IliyanAntov/CodeFreeBLDC/README.md

 <h1 align="center"> Осъвременяване на управлението на вакуумна помпа <br/><br/>
 Code-free BLDC pump motor driver
 </h1>

## [Документация](./Documentation/DR_Iliyan_Antov_101324019.pdf)

## [Презентация на проекта](./Documentation/Presentation/BLDC%20motor%20driver.pptx)

## Блокова схема:
<p align="center">
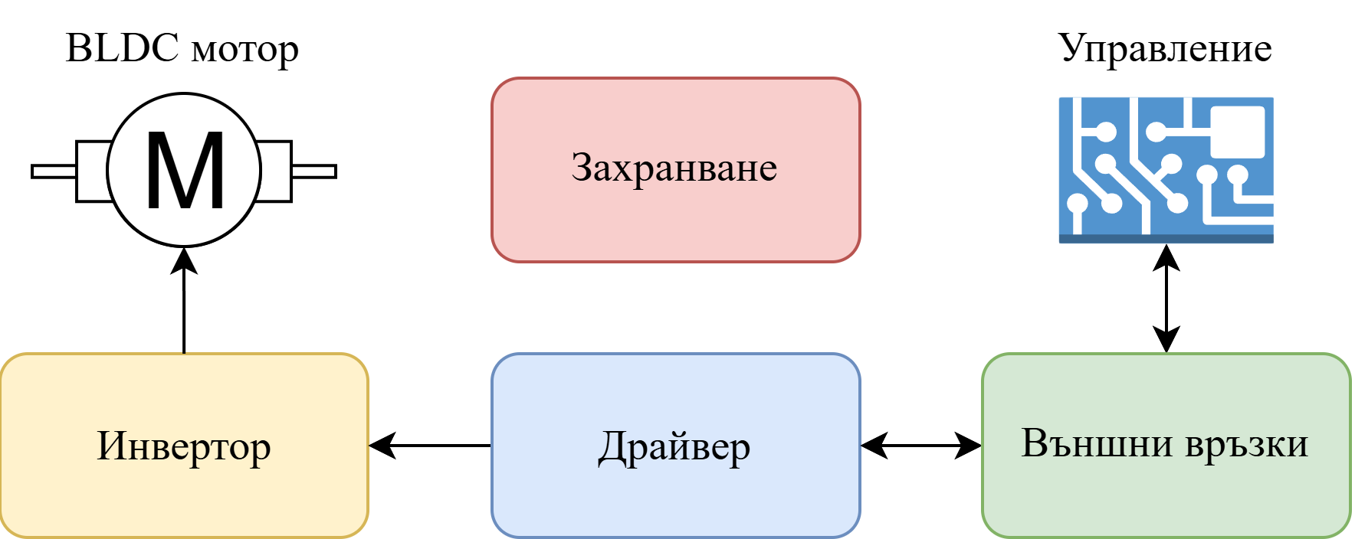
[picture p1: Documentation/Images/Block schemes/BLDC_driver.png]
  
</p>

## Принципна електрическа схема:
<p align="center" float="left">
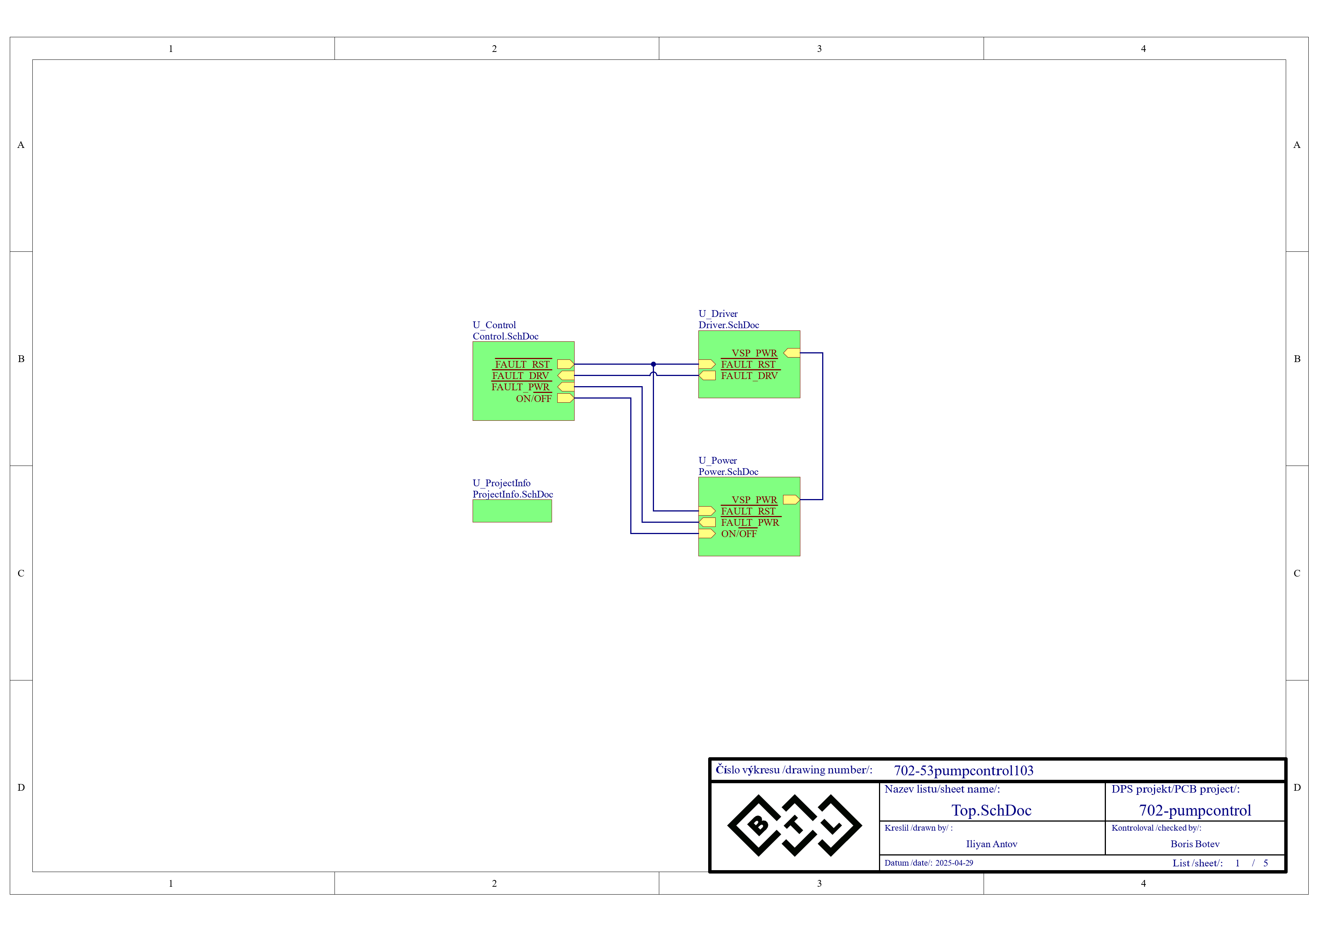
[picture p2: Design/Schematic/1_Top.png]
  
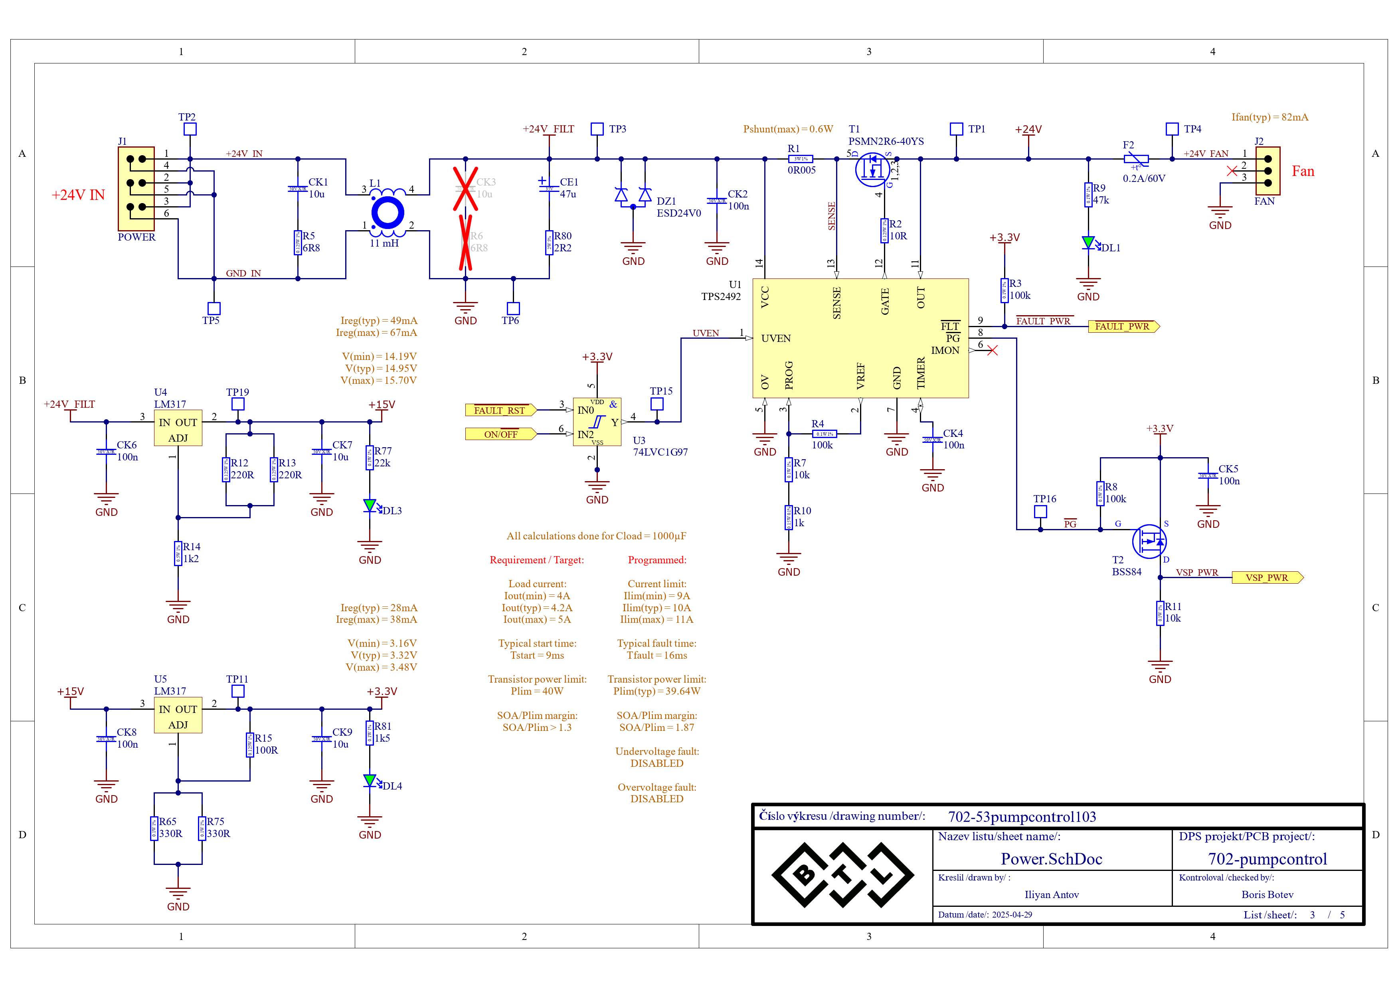
[picture p3: Design/Schematic/3_Power.png]
  
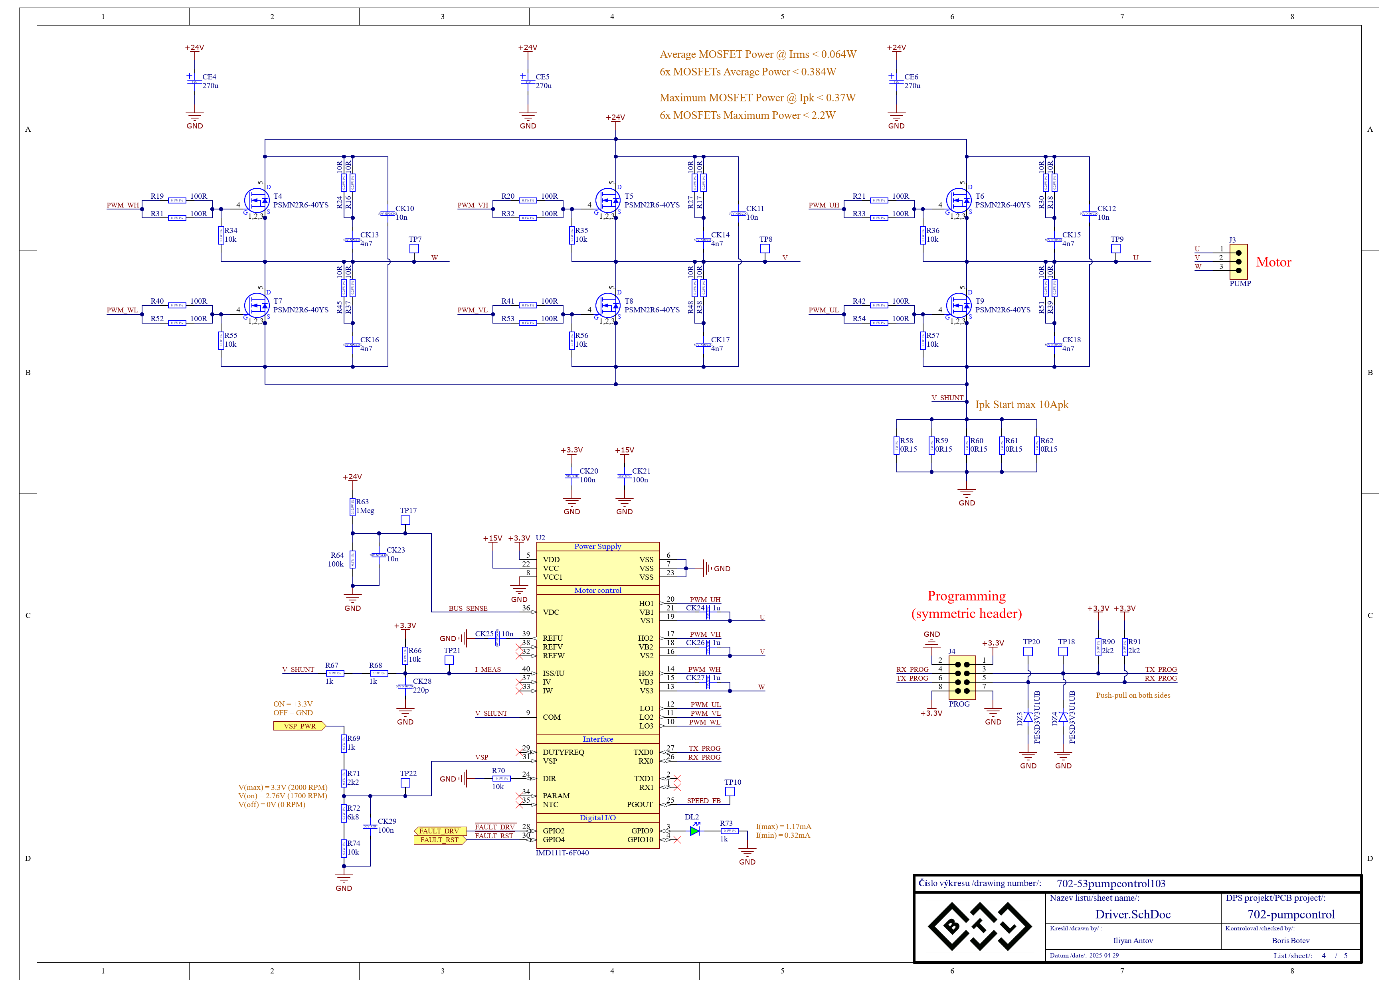
[picture p4: Design/Schematic/4_Driver.png]
  
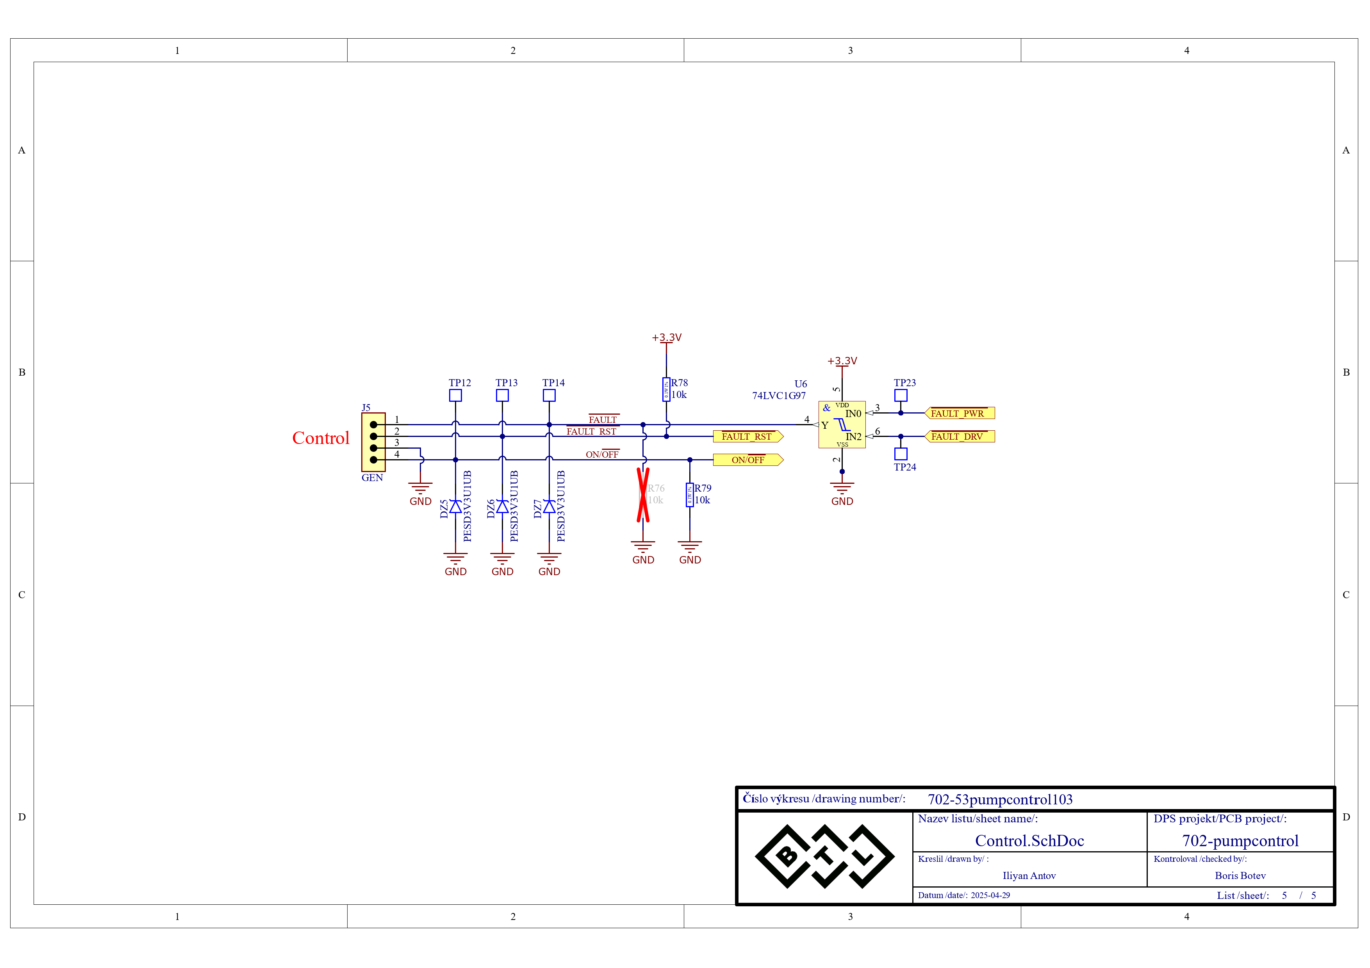
[picture p5: Design/Schematic/5_Control.png]
  
</p>

## Печатна платка:
<p align="center">
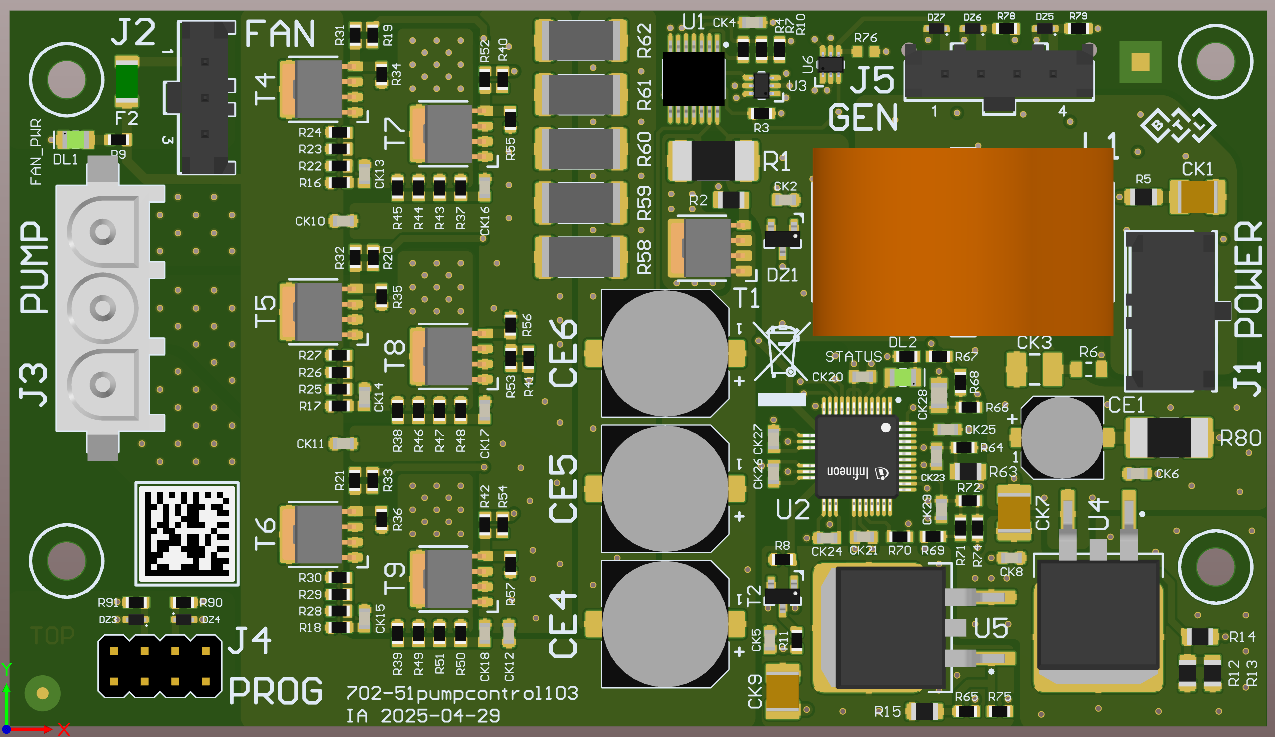
[picture p6: Documentation/Images/PCB/3D_TOP.png]
  
</p>

## Реализация:
<ul>
  <li><a href="./Design/Testing/702-pumpcontrol102_Test_Report.pdf"> Test report </a></li>
  <li><a href="./Documentation/Images/Measurements/EMC/VER_therapy%20-%20pumpcontrol103.pdf"> EMC report </a></li>
</ul>

## Използвани технологии:
* Schematics/Layout: Altium
* Simulations: LTSpice
* BLDC driver platform: Infineon iMOTION

## Автор:
Илиян Антов - [Iliyan Antov](https://github.com/IliyanAntov) - [i.antov2@gmail.com](i.antov2@gmail.com)
