IliyanAntov/CodeFreeBLDC/Design/Design report.docx

# 702-pumpcontrol102 Design Report

References:

- IMD111T datasheet (https://www.infineon.com/dgdl/Infineon-IMD110T-DataSheet-v01_01-EN.pdf?fileId=5546d462773f93240177489a1dcf0a7d)
- iMOTION Software Reference Manual (https://www.infineon.com/dgdl/Infineon-MCESW-RM-UserManual-v01_34-EN.pdf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)
- EVAL-M7-D111T user guide (https://www.infineon.com/dgdl/Infineon-UG-2021-17_EVAL-M7-D111T-UserManual-v01_00-EN.pdf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)
  - Schematics (https://www.infineon.com/dgdl/Infineon-Schematics-EVAL-M7-D111T-PCBDesignData-v01_00-EN.pdf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)
- EVAL-M7-LVMOS-INV user guide (https://www.infineon.com/dgdl/Infineon-UG-2021-30_EVAL-M7-LVMOS-INV-UserManual-v01_01-EN.pdf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)
  - Schematics (https://www.infineon.com/dgdl/Infineon-Schematics-EVAL-M7-LVMOS-INV-PCBDesignData-v01_00-EN.pdf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)
- REF_Fridge_D111T_RC2_SL user guide (https://www.infineon.com/dgdl/Infineon-UG-2021-31_REF_Fridge_D111T_RC2_SL_V1.1_EN-UserManual-v01_01-EN.pdf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)
  - Schematics (https://www.infineon.com/dgdl/Infineon-Schematics-REF_FRIDGE_D111T_RC2_SL-PCBDesignData-v01_01-EN.pdf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)
- iMOTION Link User Manual (https://www.infineon.com/dgdl/Infineon-iMOTION_Link-UserManual-v01_01-EN.pdf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)
- MOSFET Gate Drive Circuit application note (https://toshiba.semicon-storage.com/info/application_note_en_20180726_AKX00068.pdf?did=59460)
- Accurate Thermal Calculations on the Back of a Napkin (https://www.ti.com/lit/an/slpa015/slpa015.pdf)

# 1. Shunt resistors

I_(pk) =10A, P_(res(max)) =1W

R_(tot) =0.15/5=0.03Ω=30mΩ

P_(tot(max)) =R_(tot) *I_(pk)^2 =30m*10^2 =3W

P_(res(pk)) =(P_(tot))/5=0.6W

P_(tot(RMS)) =R_(tot) *I_(RMS)^2 =30m*4.2^2 =0.5W

P_(res(RMS)) =0.5/5=0.1W

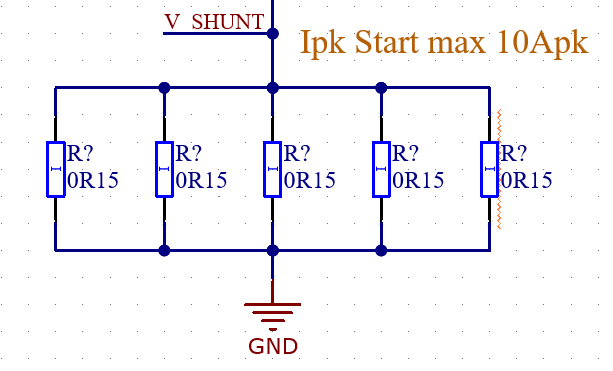
[picture p7: figure]

# 2. Bus sense

V_(ADC(max)) =3.3V

V_(DC(max)) =(100k+1000k)/(100k)*3.3V=36.3V

τ_(RC) =1Meg*10n=10μs

f_c =1/(2πRC)=1/(2π*1Meg*10n)=16Hz

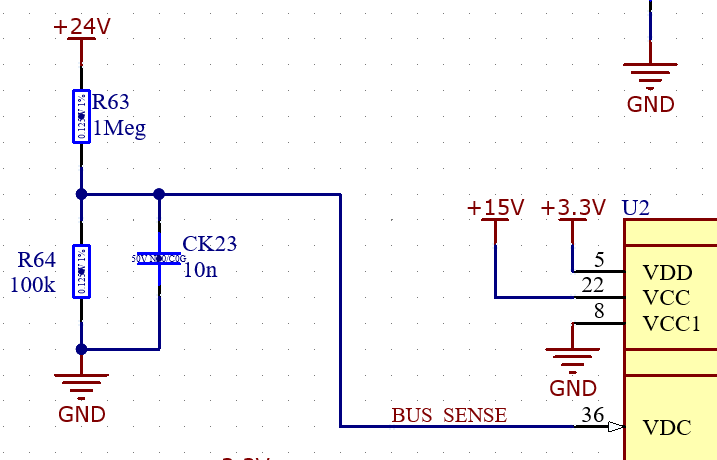
[picture p8: figure]

# 3. Current measurement

G_(int) =3, R_(shunt) =30mΩ

V_(offset) =(2k)/(2k+10k)*3.3V=0.55V=550mV

V_(shunt(min)) =-V_(offset) =-550mV

V_(shunt(max)) =(V_(ADC))/(G_(int))-V_(offset) =3.3/3-0.55=550mV

G_(ext) =(10k)/(2k+10k)=0.833

Current gain=G_(ext) *R_(shunt) =0.833*30mΩ=25mV/A

I_((min)) =(V_(shunt(min)))/(Current gain)=(-550mV)/25=-22A

I_((max)) =(V_(shunt(max)))/(Current gain)=(550mV)/25=22A

P_(res(max)) =(U^2)/R=5.45mW

τ_(RC) =2k*220p=440ns=0.44μs

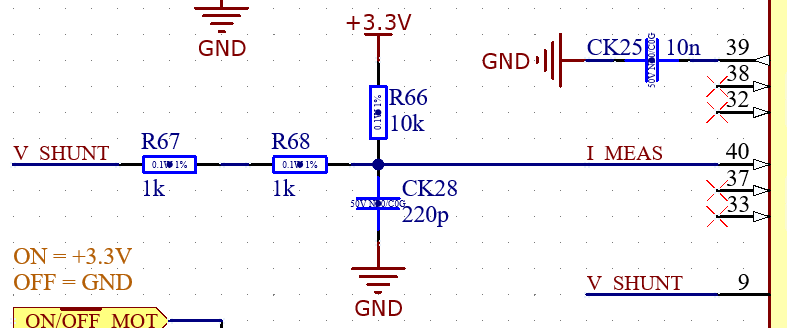
[picture p9: figure]
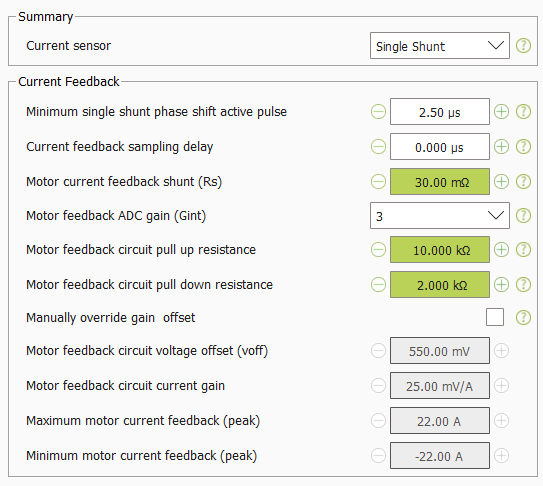
[picture p10: figure]
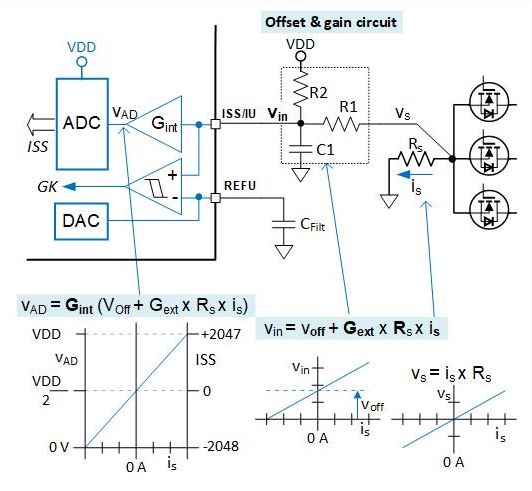
[picture p11: figure]

# 4. Parameter selection

Multiple parameter sets not used, so PARAM pin can be left floating. Parameter set chosen during firmware flash.

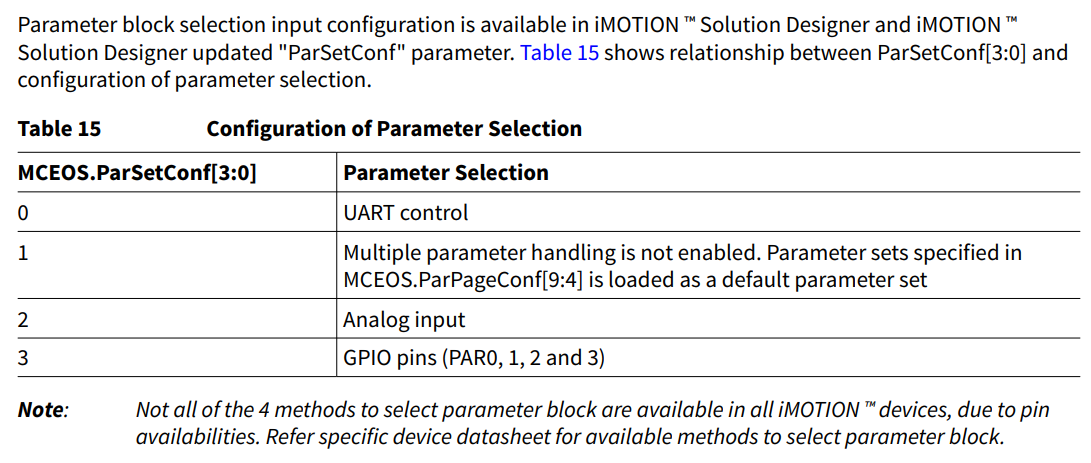
[picture p12: figure]

# 5. Motor direction

DIR pin should be LOW so motor direction is positive.

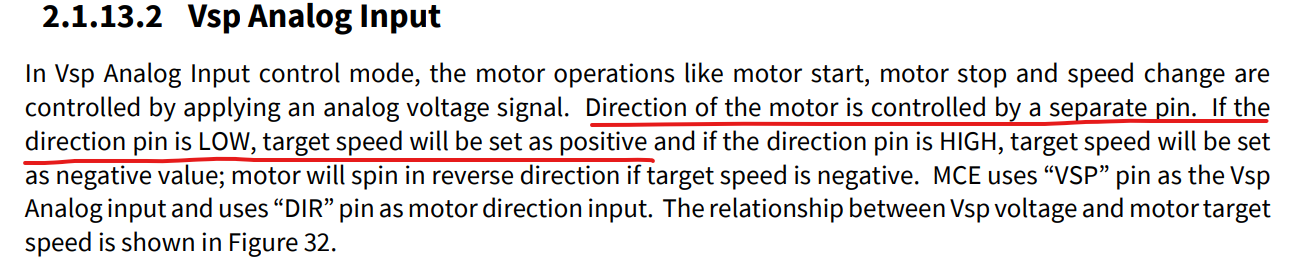
[picture p13: figure]
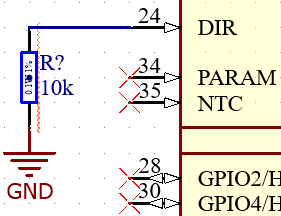
[picture p14: figure]

# 6. Motor speed

S_(typ) =1700 RPM, S_(min) =200 RPM, S_(max) =2000 RPM

V_(target) =((S_(typ) -S_(min) ))/((S_(max) -S_(min) ))*(V_(max) -V_(min) )+V_(min)

V_(target) =((1700-200))/((2000-200))*(3.16-0.79)+0.79=2.77V

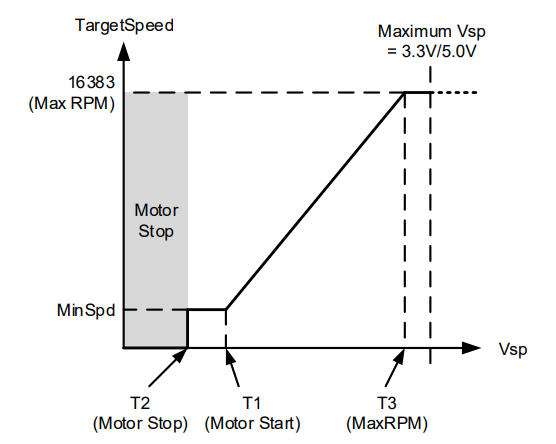
[picture p15: figure]
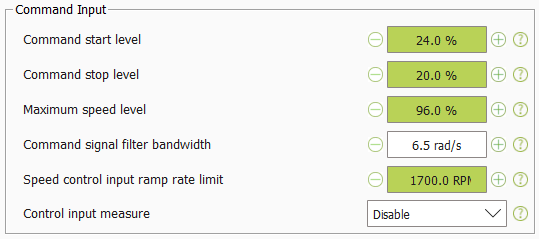
[picture p16: figure]

R_(ds(on)) ≤2Ω

VSP=(10k+6.8k)/(10k+6.8k+2.2k+1k+R_(ds(on)))*3.3V≈2.77V

I_(div) =(3.3V)/(1k+2.2k+6.8k+10k+R_(ds(on)))=165μA

τ_(RC) =(1k+2.2k)*100n=320μs

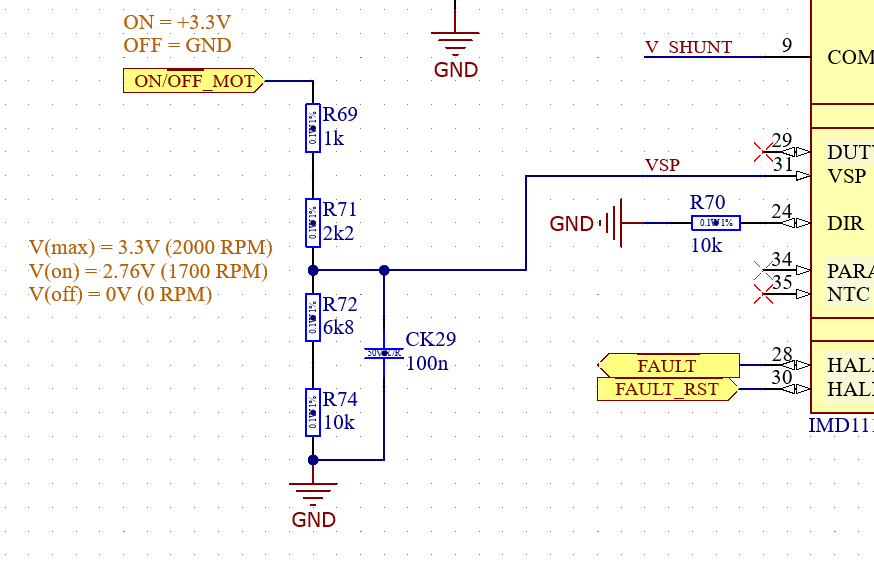
[picture p17: figure]
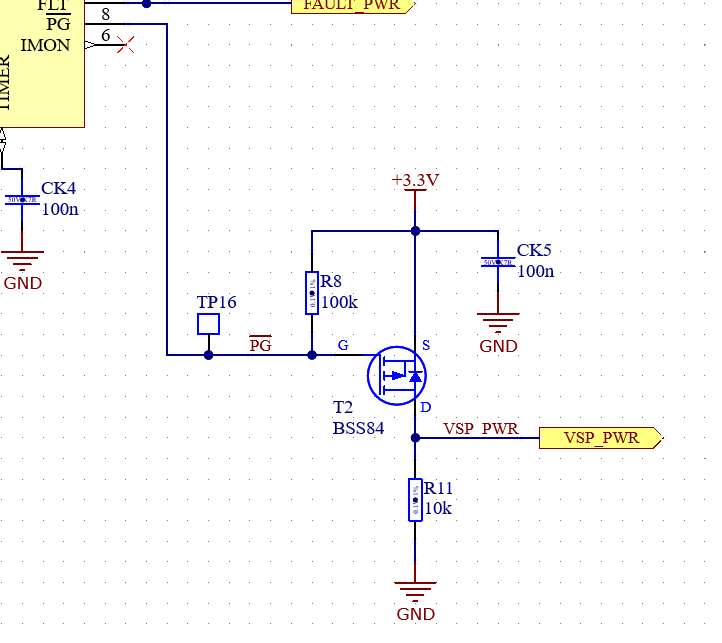
[picture p18: figure]
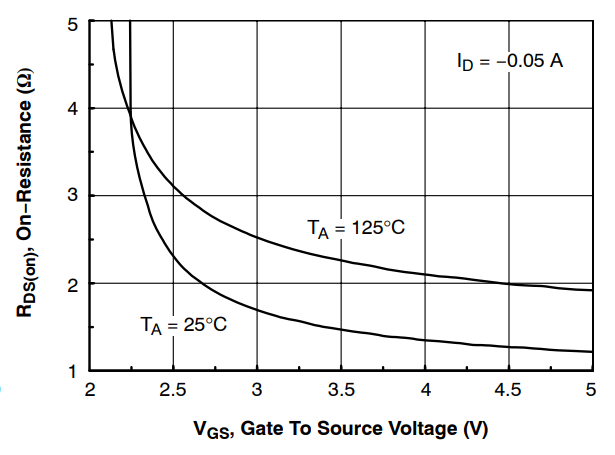
[picture p19: figure]

# 7. +15V and +3.3V power supplies

Q_(g(max)) =63nC, f_(sw(max)) =40kHz, N=6 transistors

I_(G(max)) =Q_(g(max)) *f_(sw(max)) =63n*40k=2.52mA

I_(CC(max)) =N*I_(g(max)) =6*2.52m=15.12mA

I_(QCC(nom)) =0.75mA

I_(+15V(nom)) =I_(QCC(nom)) +I_(CC(nom))

I_(+15V(nom)) ≈10mA

I_(QCC(max)) =1.5mA

I_(+15V(max)) =I_(QCC(max)) +I_(CC(max)) =1.5m+15.12m

I_(+15V(max)) =16.62mA

I_(DD(nom)) =12mA

I_(+3.3V(nom)) =15mA

I_(DD(max)) =20mA

I_(+3.3V(max)) =25mA

IC (IMD111T):

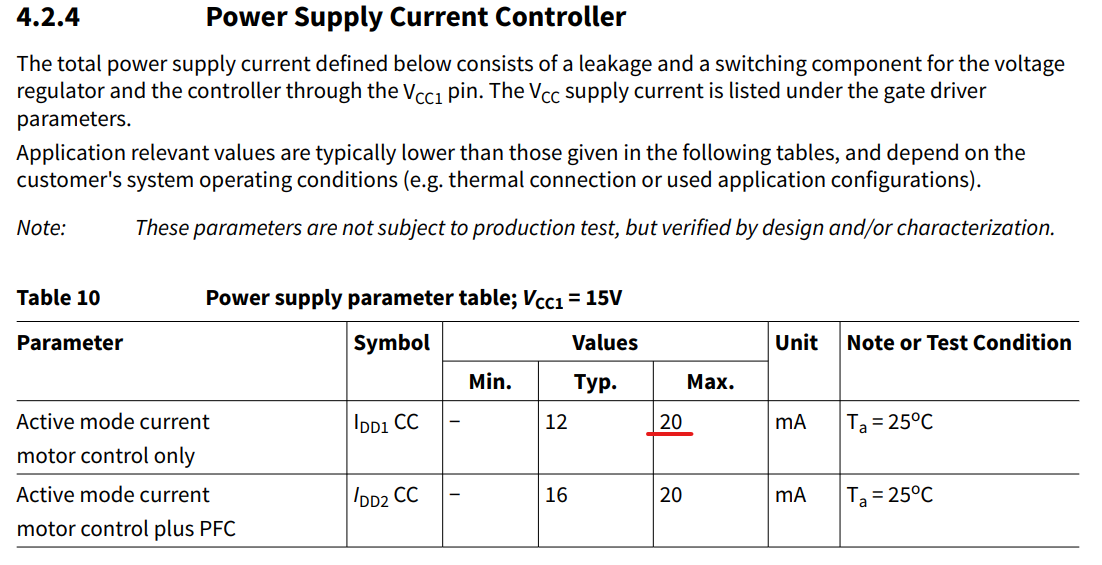
[picture p20: figure]

Transistors (PSMN2R6-40YS):

Regulator:

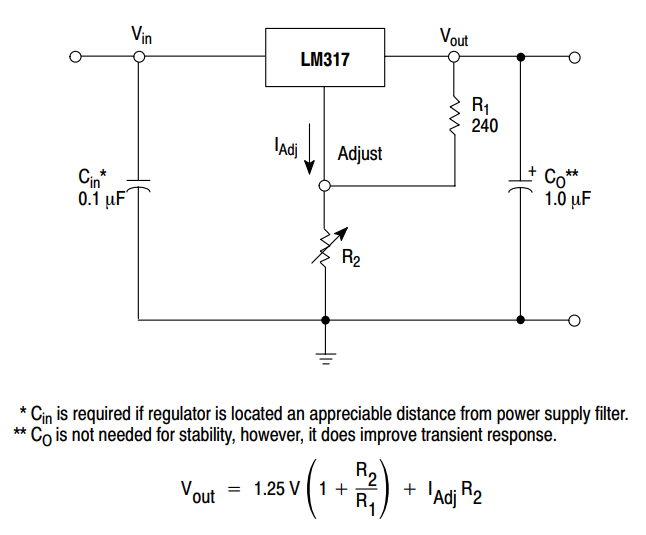
[picture p21: figure]

# 8. Overall power loss and self-heating

T_(amb) =40°C

- +15V regulator (LM317):

P_(+15V_reg(nom)) =0.44W

T_(+15V_reg(nom)) =62.12°C

- +3.3V regulator (LM317):

P_(+3.3V_reg(nom)) =0.32W

T_(+3.3V_reg(nom)) =55.99°C

- Shunt resistors (5x):

P_(R(nom)) =0.104W

T_(R(nom)(polygon)) =48.41°C

- Inverter transistors (6x):

P_(T_(inv) (nom)) =0.035W

T_(T_(inv) (nom)(polygon)) =42.82°C

- +24V power transistor:

P_(T_(+24V) (nom)) =0.035W

T_(T_(+24V) (nom)(polygon)) =43.16°C

- +24V power shunt resistor:

P_(R_(+24V) (nom)) =0.087W

T_(T_(+24V) (nom)(polygon)) =52.75°C

P_(tot(nom)) =P_(+15V_reg(nom)) +P_(+3.3V_reg(nom)) +5P_(R(nom)) +6P_(T_(inv) (nom)) +P_(T_(+24V) (nom)) +P_(R_(+24V) (nom))

P_(tot(nom)) =0.44+0.32+5*0.104+6*0.035+0.035+0.087

P_(tot(nom)) =1.614 W

# 9. Phase output snubber calibration

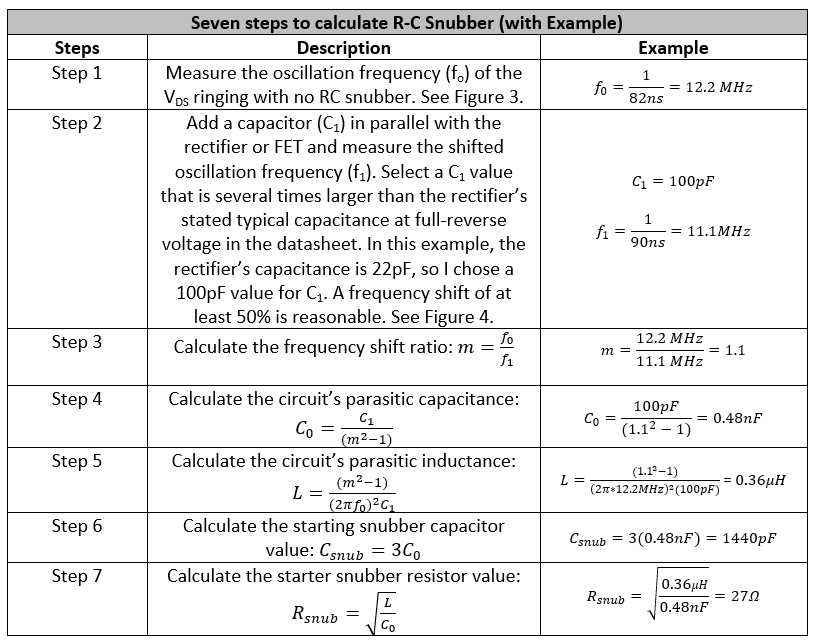
[picture p22: figure]

U phase:

Top:

f_0 =22.8 MHz

Choose C_1 =2.2 nF

f_1 =12.5 MHz

m=(f_0)/(f_1)=1.824

C_0 =(C_1)/((m^2 -1))=0.945 nF

L=((m^2 -1))/((2πf_0 )^2 C_1)=51.54 nH

C_(snub) =3C_0 =2.835 nF

Choose C_(snub) =4.7 nF

R_(snub) =√(L/(C_0))=7.385 Ω

Choose R_(snub) =5 Ω

Bot:

f_0 =24 MHz

Choose C_1 =2.2 nF

f_1 =11.5 MHz

m=(f_0)/(f_1)=2.087

C_0 =(C_1)/((m^2 -1))=0.656 nF

L=((m^2 -1))/((2πf_0 )^2 C_1)=67.08 nH

C_(snub) =3C_0 =1.968 nF

Choose C_(snub) =4.7 nF

R_(snub) =√(L/(C_0))=10.11 Ω

Choose R_(snub) =5 Ω

V phase:

Top:

f_0 =22.5 MHz

Choose C_1 =2.2 nF

f_1 =11.5 MHz

m=(f_0)/(f_1)=1.957

C_0 =(C_1)/((m^2 -1))=0.777 nF

L=((m^2 -1))/((2πf_0 )^2 C_1)=64.36 nH

C_(snub) =3C_0 =2.331 nF

Choose C_(snub) =4.7 nF

R_(snub) =√(L/(C_0))=9.101 Ω

Choose R_(snub) =5 Ω

Bot:

f_0 =23.8 MHz

Choose C_1 =2.2nF

f_1 =11.6 MHz

m=(f_0)/(f_1)=2.052

C_0 =(C_1)/((m^2 -1))=0.685 nF

L=((m^2 -1))/((2πf_0 )^2 C_1)=65.26 nH

C_(snub) =3C_0 =2.055

Choose C_(snub) =4.7 nF

R_(snub) =√(L/(C_0))=9.761 Ω

Choose R_(snub) =5 Ω

W phase:

Top:

f_0 =24 MHz

Choose C_1 =2.2 nF

f_1 =11.7 MHz

m=(f_0)/(f_1)=2.051

C_0 =(C_1)/((m^2 -1))=0.686 nF

L=((m^2 -1))/((2πf_0 )^2 C_1)=64.10 nH

C_(snub) =3C_0 =2.058 nF

Choose C_(snub) =4.7 nF

R_(snub) =√(L/(C_0))=9.666 Ω

Choose R_(snub) =5 Ω

Bot:

f_0 =24.2 MHz

Choose C_1 =2.2 nF

f_1 =11.8 MHz

m=(f_0)/(f_1)=2.051

C_0 =(C_1)/((m^2 -1))=0.686 nF

L=((m^2 -1))/((2πf_0 )^2 C_1)=63.04 nH

C_(snub) =3C_0 =2.058 nF

Choose C_(snub) =4.7 nF

R_(snub) =√(L/(C_0))=9.586 Ω

Choose R_(snub) =5 Ω
