IliyanAntov/CodeFreeBLDC/Design/TPS2492_calculations.xlsx

Sheet: Instructions
 | © 2016
TPS249x/8x Design Tool- Rev. B
Typical design procedure
Typical applications require multiple passes through the design tool using MOSFET factors such as transient
thermal response and safe operating area curves. Refer to the following application reports for more detail.
Robust Hot Swap Design (http://www.ti.com/lit/pdf/slva673)
The basic design process follows:
1. Enter operating conditions.
2. Select current limit parameters.
3. Enter MOSTFET SOA characteristics & power limit.
4. Select start up conditions (load and/or soft start). Check whether FET is operating with reasonable margin, within the SOA curve.
If not, try changing start-up conditions (soft start values, timer values), add more FETs in parallel, or switch to FET with better SOA.
5. Enter desired UVLO and OVLO values to get recommended resistor values.
6. Done
Notes
1. This worksheet is designed for use with Microsoft Excel 5.0 or later. Its use is intended to assist power supply designers in their
routine, day-to-day calculations.
2. All worksheets have light green inputs cells, white calculated cells, yellow warning cells and red high-risk cells.
3. Formulas and device constants used in the spreadsheet are locked to prohibit them from accidentally being overwritten or deleted.
TEXAS INSTRUMENTS TEXT FILE LICENSE Copyright (c) 2014 Texas Instruments Incorporated All rights reserved not granted herein. Limited License. Texas Instruments Incorporated grants a world-wide, royalty-free, non-exclusive license under copyrights and patents it now or hereafter owns or controls to make, have made, use, import, offer to sell and sell ("Utilize") this software subject to the terms herein. With respect to the foregoing patent license, such license is granted solely to the extent that any such patent is necessary to Utilize the software alone. The patent license shall not apply to any combinations which include this software, other than combinations with devices manufactured by or for TI (“TI Devices”). No hardware patent is licensed hereunder. Redistributions must preserve existing copyright notices and reproduce this license (including the above copyright notice and the disclaimer and (if applicable) source code license limitations below) in the documentation and/or other materials provided with the distribution Redistribution and use in binary form, without modification, are permitted provided that the following conditions are met: * No reverse engineering, decompilation, or disassembly of this software is permitted with respect to any software provided in binary form. * any redistribution and use are licensed by TI for use only with TI Devices. * Nothing shall obligate TI to provide you with source code for the software licensed and provided to you in obje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

Sheet: Design Calculator
TPS2490/1/2/3 & TPS2480/1/2/3 Hot Swap Design Tool
 | www.ti.com/hotswap
 |  |  | Enter Values in Green Shaded Cells
 |  |  | Calculated Values are shown in White Cells
 |  |  | Yellow and Red cells highlight pottential issues with the design. Red highlights items that are higher risk.
 | Step 0: Calculator Tutorials |  | Note: Before proceeding, please watch the video tutorials listed to ensure accurate results from this tool!
 |  |  | Steps 1 & 2: Operating Conditions, Current Limit, & Circuit Breaker (7:41) (https://training.ti.com/node/1133677)
 |  |  | Step 3: MOSFET Selection (9:58) (https://training.ti.com/node/1133673)
 |  |  | Step 4: Startup (10:32) (https://training.ti.com/node/1133664)
 |  |  | Step 5: UVLO, OVLO & PGD Thresholds (4:20) (https://training.ti.com/node/1133681)
 |  |  | TPS2490 Datasheet (http://www.ti.com/product/TPS2490)
 |  |  | I understand and agree to watch the video tutorials if help is needed. (Choose Yes to enable the calculator.) |  |  | Yes
 |  |  | Assure to follow the layout and application guidelines listed on the datasheet. |  |  | Yes
 |  |  | *For additional questions not addressed in the videos, please post on E2E.ti.com
 | Step 1: Operating Conditions |  |  | Minimum Input Operating Voltage: VIN(MIN) | 22 | V
 |  |  |  | Nominal Input Operating Voltage: VIN(NOM) | 24 | V
 |  |  |  | Maximum Input Operating Voltage: VIN(MAX) | 26 | V
 |  |  |  | Maximum Load Current: IOUT(MAX) | 5 | A
 |  |  |  | Maximum Output Load Capacitance: CLOAD | 1000 | µF
 |  |  |  | Maximum Ambient Operating Temperature: TMAX | 65 | oC
 | Steps 1 & 2: Operating Conditions, Current Limit, & Circuit Breaker (https://training.ti.com/node/1133677)
 | Step 2: Current Limit and Circuit Breaker |  |  | Maximum Recommended Value for Rs | 8.91 | mW
 |  |  |  | Use External Resistor Divider to Reduce Effecitve RS | No
 |  |  |  | Enter the Resistance for RS | 5 | mW
 |  |  |  | Recommended Value for RCL1 | NA | W
 |  |  |  | Recommended Value for RCL2 | NA | W
 |  |  |  | Enter value for RCL1 | 10 | W
 |  |  |  | Enter value for RCL2 | 2 | W
 | Steps 1 & 2: Operating Conditions, Current Limit, & Circuit Breaker (https://training.ti.com/node/1133677) |  |  | Effective Sense Resistance (RS,EFF) | 5.00 | mW
 |  |  |  | Resulting Minimum Current Limit | 9.0 | A
 |  |  |  | Resulting Typical Current Limit | 10.0 | A
 |  |  |  | Resulting Maximum Current Limit | 11.0 | A
 |  |  |  | Maximum Power Dissipation in RS | 0.6 | W
 | Step 3: MOSFET Selection |  |  | Q1 FET Name | ET+PSMN2R6XX0
 |  |  |  | Estimated MOSFET RQJA | 30 | oC/W
 |  |  |  | Number of MosFETs | 1 | #
 |  |  |  | MOSFET On resistance @ TJ,DC | 3.7 | mW
 |  |  |  | Maximum FET Junction Temperature | 150 | oC
 |  |  |  | 100ms SOA Current (re-use 1ms data if unavailable) @ VIN(MAX) | 90.0 | A
 |  |  |  | 1ms SOA Current @ VIN(MAX) | 10.0 | A
 | Step 3: MOSFET Selection (https://training.ti.com/node/1133673) |  |  | 10ms SOA Current @ VIN(MAX) | 5.0 | A
 |  |  |  | 100ms Current at @ VIN(MAX) (use DC if 100ms not available) | 2.5 | A
 |  |  |  | 1s or DC SOA Current at @ VIN(MAX) (use DC if 1s not available) | 1.5 | A
 |  |  |  | FET Power dissapation at full load (per FET) | 0.092 | W
 | Note: TI recommends choosing a FET with SOA current specified for 100ms and/or 1s or DC. If choosing a FET without these parameters, this calculator will estimate the values via extrapolation, which leaves an inherent associated risk. |  |  | Maximum steady state FET Junction Temperature (TJ,DC) | 67.8 | oC
 |  |  |  | Minimum Power Limit to Ensure Vsns > 5mV & Vprog > 0.4V (PLIM,MIN) | 40.0 | W
 |  |  |  | Target Power Limit | 40.0 | W
 |  |  |  | Select R3 | 100.0 | kW
 |  |  |  | Calculated R4 | 11.11 | kW
 |  |  |  | Actual R4 (Select next available std. value) | 11 | kW | Note: Hover here to see the 3 values affecting this curve, consult a thermal expert if you are unsure!
 |  |  |  | Actual PLIM | 39.64 | W
 | Step 4: Startup |  |  | Load Turn-On Threshold | 0 | V
 |  |  |  | Startup Load Type | Constant Current
 |  |  |  | Startup Load Value | 0.1 | A
 |  |  |  | Use External Soft-Start Control | No
 |  |  |  | Typical Start Time with Vinmax (Tstart) | 9.04 | ms
 |  |  |  | IFET - ILOAD margin (lowest for Vout range) | 93.44090909%
 |  |  |  | Target Fault Timer: Tstart + Margin | 15.83 | ms
 |  |  |  | Target Timer capacitance | 98.93 | nF
 |  |  |  | Selected Timer capacitance | 100 | nF
 | Step 4: Startup (https://training.ti.com/node/1133664) |  |  | Final Fault Timer(Tfault) | 16.00 | ms
 |  |  |  | Derated SOA / PLIM | 1.87
 |  |  |  | Can a "hot" board be hotplugged | No
 |  |  |  | Recommended slew Rate (max) | 0.53 | V/ms
 |  |  |  | Recommended slew Rate (min) | 0.10 | V/ms
 | Note: This is the typical dv/dt rate, but max value can be larger. This is because the gate source current can vary from 16uA to 28uA. Thus TI recommends keeping the overall SOA margin during start-up >1.5 in order to compensate for this. |  |  | dv/dt rate on Vout | 1 | V/ms
 |  |  |  | calculated SS capacitance | 22.00 | nF
 |  |  |  | actual SS capacitance | 22 | nF
 |  |  |  | actual dv/dt rate on Vout | 1.00 | V/ms
 |  |  |  | SOA margin during start-up | 2.32
 |  |  |  | Target Fault Time | 1 | ms
 |  |  |  | Calculated Timer Capacitance | 6.25 | nF
 |  |  |  | Actual Timer Capacitance (pick one smaller than CT,CALC) | 10 | nF
 |  |  |  | Actual Fault Time (Tfault) | 1.60 | ms
 |  |  |  | SOA margin during "hot-short" or "start-into short" | 1.87
 | Step 5: UVLO, OVLO & PGD Thresholds |  |  | Target Under - Voltage | 20 | V
 |  |  |  | Recommended R2 | 10.00 | kW
 |  |  |  | Actual R2 |  | kW
 |  |  |  | Calculated R1 | 0.00 | kW
 |  |  |  | Actual R1 |  | kW
 |  | Resulting Thresholds: | Minimum | Typical | Maximum
 | Step 5: UVLO, OVLO & PGD Thresholds (https://training.ti.com/node/1133681) | Resulting Upper UVLO Threshold = | #DIV/0! | #DIV/0! | #DIV/0! | V
 |  | Resulting Lower UVLO Threshold = | #DIV/0! | #DIV/0! | #DIV/0! | V
 | Design Summary |  |  | RS = | 5 | mW
 |  |  |  | RCL1 = | DNP | W
 |  |  |  | RCL2 = | short | W
 |  |  |  | R1 = | 0 | kW |  |  | Typical | Units
 |  |  |  | R2 = | 0 | kW |  | Current limit | 10.0 | A
 |  |  |  | R3 = | 100.0 | kW |  | Power Limit | 39.63963964 | W
 |  |  |  | R4 = | 11 | kW |  | Fault Timeout | 16.000 | ms
 |  |  |  | CT = | 100.00 | nF |  | Upper UVLO Threshold | #DIV/0! | V
 |  |  |  | C1 = | 0.10 | µF |  | Lower UVLO Threshold | #DIV/0! | V
 |  |  |  | Q1 = | ET+PSMN2R6XX0
 |  |  |  | RG = | DNP | kW
 |  |  |  | CG = | DNP | nF
 | Notes: | 1. Although not mandatory, CIN provides transient suppression at the VIN pin
 |  | 2. A TVS clamp from VIN to GND is absolutely mandatory to clamp the voltage overshoot upon MOSFET turn-off, e.g. during circuit breaker
 |  | 3. Componet tolerances not accounted for in Min/Max Calculations.
