IliyanAntov/CodeFreeBLDC/Documentation/T_Iliyan_Antov_101324019.docx

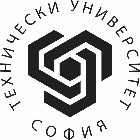
[picture p23: figure]

| Т Е Х Н И Ч Е С К И У Н И В Е Р С И Т Е Т – С О Ф И Я
| | ФАКУЛТЕТ ПО ЕЛЕКТРОННА ТЕХНИКА И ТЕХНОЛОГИИ

#### ДИПЛОМНА РАБОТА

ТЕМА: | ОСЪВРЕМЕНЯВАНЕ НА УПРАВЛЕНИЕТО НА ВАКУУМНА ПОМПА

ДИПЛОМАНТ: | инж. Илиян Илиянов Антов

РЪКОВОДИТЕЛ: | ас. инж. Николай Тюлиев

София, 2025
