IliyanAntov/CodeFreeBLDC/Documentation/DR_Iliyan_Antov_101324019.docx

Съдържание

# 1. Увод

Последна и най-важна задача на голяма част от електрическите устройства и системи е преобразуването на електрическата енергия в механична. Тази функция се изпълнява от т.нар. задвижващи механизми, които най-общо се разделят на линейни и ротационни. Постояннотоковите двигатели са едни от най-често използваните в индустрията ротационни задвижващи механизми.

Двата основни вида постояннотокови двигатели са т.нар. четкови и безчеткови мотори[1]. Основно предимство на четковите мотори е тяхната ниска цена и лесно управление. От друга страна, безчетковите мотори са по-ефективни, по-компактни, поддръжката им е по-лесна и имат по-дълъг живот. Всичко това обаче е за сметка на по-високата им цена, която до голяма степен е свързана с по-сложното управление. Докато при четковите мотори задвижването става чрез подаване на постоянно напрежение към две намотки, безчетковите мотори изискват синхронно управление (обикновено трифазно) на няколко намотки спрямо позицията на ротора.

Освен от цената на допълнителните компоненти за управление, имплементиращите безчеткови мотори продукти биват значително оскъпени и от цената за развой на управляващия фърмуер. Опростяването на процеса по развой на фърмуера е един от начините цената на крайния продукт да бъде понижена.

Управлението на постояннотокови двигатели е свързано с определени рискове. Колкото по-висок е въртящият момент на един двигател, толкова по-внимателна трябва да бъде работата с него – от една страна поради повишената опасност от механично нараняване, а от друга – поради високата мощност, която се консумира, свързана с по-голямо топлоотделяне. По-сложното управление на безчетковите мотори има определени предимства в този аспект – възможно е имплементирането на различни проверки, които да предпазват както работещите с двигателя хора, така и самите схеми, към които е свързан той. От друга страна обаче, грешки в управляващия фърмуер могат да доведат до нови рискове, които не са типични за четковите мотори – например късо съединение между захранващата шина и масата на схемата, което да доведе до възпламеняване. Поради тези причини се налага обстойно и внимателно изследване и валидация на управляващия фърмуер на безчетковите мотори. Това е още един фактор, допринасящ за повишената цена на този вид двигатели и още една причина да се търсят начини за опростяване на тази стъпка от развоя.

Настоящата дипломна работа има за цел проектирането на устройство за управление на компресорна помпа с безчетков постояннотоков двигател без да се налага разработка на управляващ фърмуер.

Ще бъдат сравнени различните видове трифазни безчеткови постояннотокови двигатели, които имат разлики по отношение на управлението. Ще бъдат разгледани някои от алгоритмите за управление на такива двигатели. Ще бъдат разгледани наличните на пазара интегрирани драйвери, подходящи за целите на дипломната работа. Ще бъдат разгледани подобни съществуващи устройства.

Ще бъдат дефинирани изисквания към разработваното устройство. Ще бъде проектирана електрическа схема за управление на безчетков постояннотоков двигател без нужда от разработка на фърмуер. Ще бъде проектирана печатна платка. Ще бъдат проведени експерименти за проверка на избраните решения и доказване на работоспособността на устройството.

# 2. Литературно проучване

Преди пристъпване към проектиране на устройството, е необходимо първо да се проучат и изберат:

- Параметрите на безчетковия мотор, който ще бъде управляван;
- Алгоритъмът, по който ще се управлява;
- Подходящ интегриран драйвер, който елиминира нуждата от разработка на управляващ фърмуер;
- Подходящ метод за превключване на захранването на мотора и управление на пусковия му ток с цел осигуряване на безопасност.

В следващите точки е направено литературно проучване и е дадена аргументация кои компоненти и методи са най-подходящи за целите на разработваното устройство. Тъй като компресорната помпа, която трябва да бъде управлявана от проектираното устройство използва трифазен безчетков мотор, от тук нататък всички описания и размишления ще се отнасят единствено за този тип мотори.

## 2.1. Видове трифазни безчеткови мотори[²][³][4]

Трифазните безчеткови мотори могат да се разделят на различни видове според множество критерии. Някои от тези разделения нямат особено отношение що се отнася до управлението на мотора, като например спрямо конструкцията му – с вътрешен ротор (in-runner) и с външен ротор (out-runner). Други обаче е желателно или дори необходимо да бъдат известни, за да се проектира правилно функциониращо управление. Такива са описани в следващите точки:

### Спрямо наличието на сензори

При управлението на безчеткови мотори, за да се синхронизира въртенето на магнитното поле, е необходимо във всеки един момент да се знае позицията на ротора. Моторите най-общо се разделят на два вида – с вградени позиционни Хол сензори (sensored) и без вградени сензори (sensorless). На фиг. 2.1. е показана блокова схема на разликите в управлението на тези видове мотори.

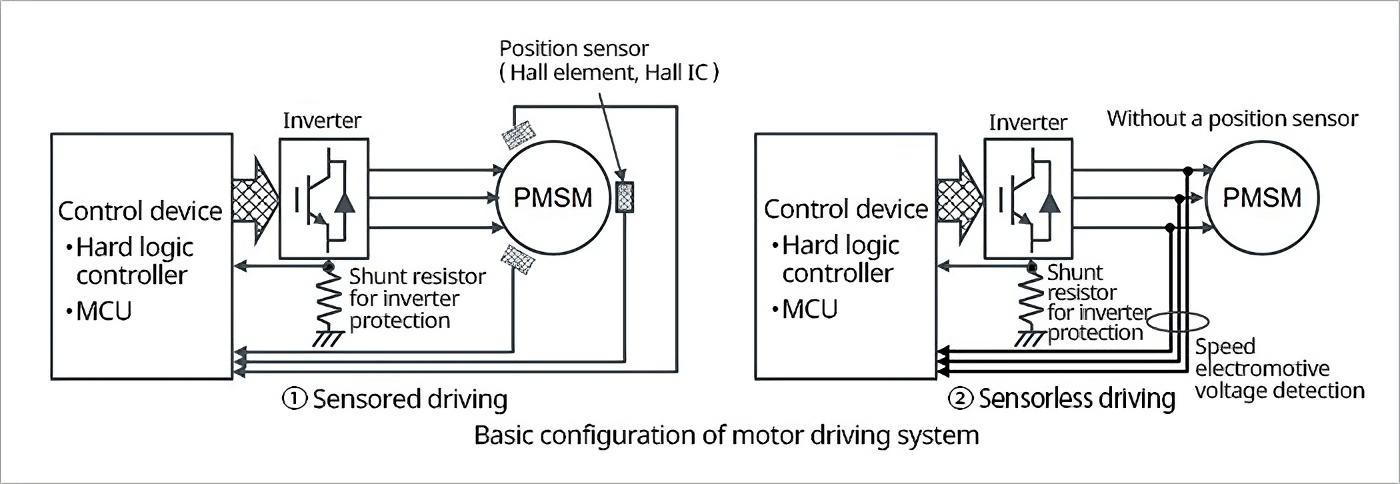
[picture p24: figure]

Фиг. 2.1. Управление на безчетков мотор с Хол сензори (ляво) и без вградени сензори (дясно)

При моторите с вградени Хол сензори, информацията за позицията на ротора се установява директно от показанията на сензорите. Това ги прави много прецизни и позволява гладко въртене на ротора при всякакви скорости. Недостатъците им са завишена цена и повишена сложност на конструкцията, което предполага повече възможности за повреда.

При моторите без вградени сензори, позицията на ротора трябва да бъде установена от управлението по косвен начин. Най-често това става чрез използване на обратното електродвижещо напрежение (ЕДН), генерирано в намотките на статора. Недостатък на тази конструкция е невъзможността за работа при ниски скорости, когато обратното ЕДН е прекалено малко. Безсензорното управление също така е по-сложно за изпълнение от гледна точка фърмуер. За сметка на това този тип мотори обикновено са по-евтини и по-надеждни.

Компресорната помпа, която трябва да бъде управлявана от проектираното устройство, е без вградени сензори, което налага подбирането на управление, което може да работи с безсензорни безчеткови мотори.

### Спрямо броя полюси

Роторът на безчетковия мотор може да бъде изграден от два или повече магнитни полюси. На фиг. 2.2. са показани конструкциите на двуполюсен и четириполюсен безчетков мотор.

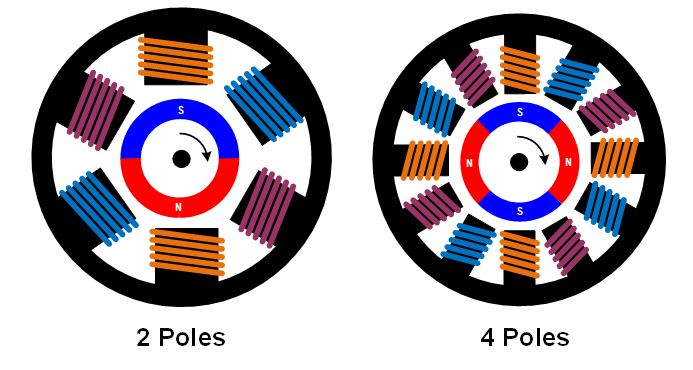
[picture p25: figure]
Brushless Vs Brushed DC Motors: When and Why to Choose One Over the Other | Article | MPS

Фиг. 2.2. Безчетков мотор с 2 полюса (ляво) и с 4 полюса (дясно)

Колкото по-голям е броят полюси, толкова по-гладко е въртенето на мотора. За сметка на това, ниският брой полюси позволява достигането на по-високи максимални скорости.

От гледна точка управление, броят полюси е пряко свързан с честотата на обратното ЕДН, генерирано в статора – колкото повече са полюсите, толкова по-висока е честотата на генерираното напрежение. За да се определи позицията на ротора при безчетков мотор без вградени сензори, броят полюси трябва да е известен предварително.

Роторът на помпата, която трябва да бъде управлявана от устройството, е изграден от 12 на брой магнитни полюса.

### Спрямо формата на обратното ЕДН

Според начина на навиване на намотките в статора, безчетковите мотори се разделят на такива с трапецовидно и със синусоидално обратно ЕДН. На фиг. 2.3. е показана разликата между двата вида.

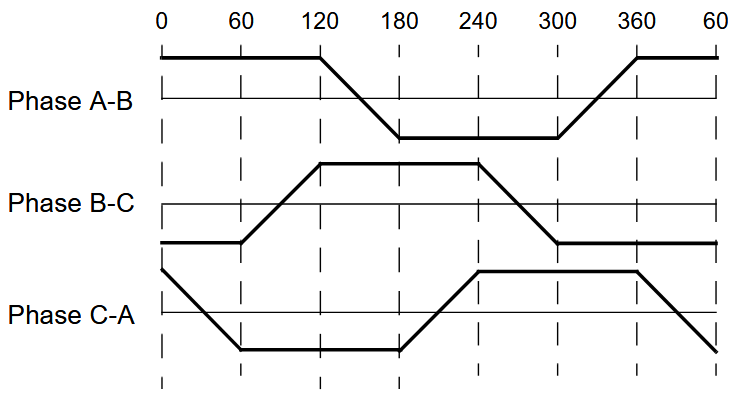
[picture p26: figure]
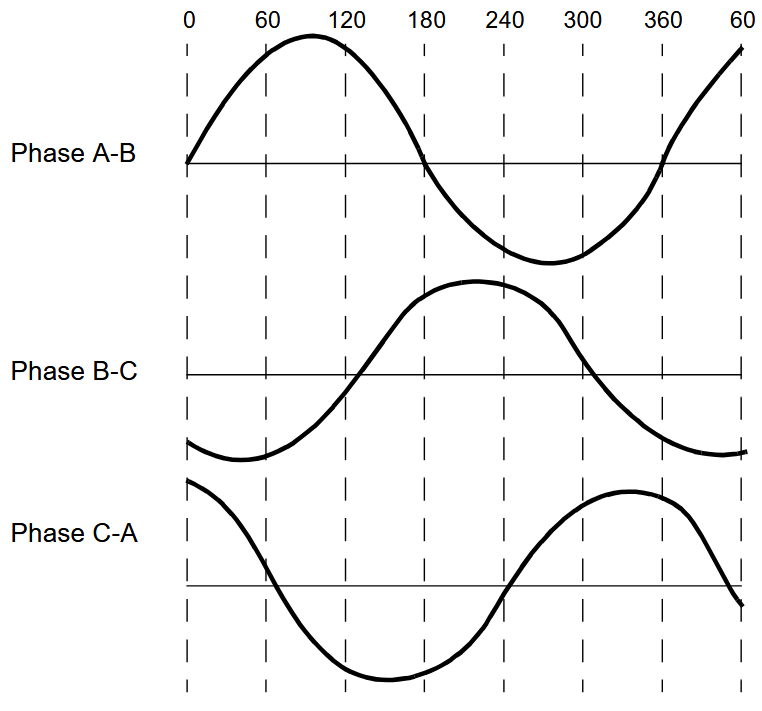
[picture p27: figure]

Фиг. 2.3. Форма на обратното ЕДН на трапецовиден (ляво) и синусоидален (дясно) безчетков мотор

От гледна точка управление, с цел постигане на максимална ефективност и въртящ момент, е добре фазовите токове също да имат трапецовидна или синусоидална форма за съответните видове мотори. В резултат, синусоидалните мотори обикновено имат по-равномерен въртящ момент. За сметка на това обаче те са по-скъпи поради сравнително по-сложната им конструкция.

Безчетковия мотор в компресорната помпа, която трябва да бъде управлявана от проектираното устройство, е от трапецовиден вид.

## 2.2. Алгоритми за управление на трифазни безчеткови мотори[4]

Съществуват три основни вида управление на трифазни безчеткови мотори – трапецовидно, синусоидално и полево-ориентирано (т.нар. FOC – Field Oriented Control). Както беше споменато по-горе, добре е вида на управлението да съвпада с вида на мотора, за който е предназначено. FOC управлението е изключение – то може да се използва както за трапецовидни, така и за синусоидални мотори. В следващите точки са разгледани особеностите на трите вида управление:

### Трапецовидно управление

Това представлява най-простият алгоритъм за управление на безчеткови мотори. При него през намотките се пуска ток по фиксирана последователност от 6 стъпки през 60° (на електрическото поле), като при всяка стъпка една от фазите е източник на ток (+), друга е консуматор (-), а третата е в състояние на висок импеданс (Z). В резултат се получават фазови токове, които променят поляритета си на всеки 120°. Последователността зависи от желаната посока на въртене на мотора. На фиг. 2.4. са показани управляващите сигнали и токовете през намотките при такъв вид управление.

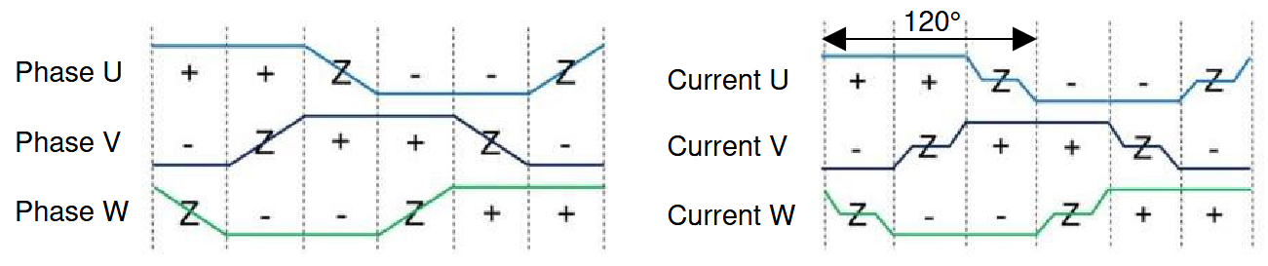
[picture p28: figure]

Фиг. 2.4. Управляващи напрежения (ляво) и фазови токове (дясно) при трапецовидно управление

След изпълнението на 6-те стъпки, последователността се повтаря. Броят повторения за извършване на едно механично завъртане на мотора (един оборот) зависи от броя на полюсите му.

Предимства на този метод са: лесна имплементация и съответно ниска цена, ниски загуби от превключване на управляващите транзистори, висок въртящ момент (особено при трапецовиден мотор).

Недостатъци са: ниска резолюция, пулсации на въртящия момент на всеки 60°, в някои случаи – генериране на доловим шум от неидеално токово управление.

### Синусоидално управление

При този алгоритъм за управление през целия период на електрическото поле през всяка от фазите преминава ток в една от двете възможни посоки, като той се променя плавно (синусоидално). Магнитният поток, генериран от статора, е синусоидален и това води до плавно завъртане на ротора. На фиг. 2.5. са показани управляващите сигнали и токовете през намотките при такъв вид управление.

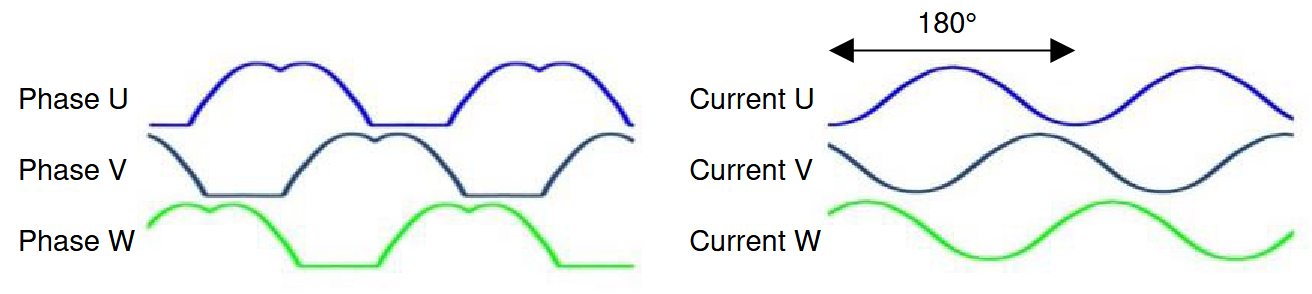
[picture p29: figure]

Фиг. 2.5. Управляващи напрежения (ляво) и фазови токове (дясно) при синусоидално управление

Както и при трапецовидното управление, броят повторения на тази последователност за извършване на едно механично завъртане на мотора (един оборот) зависи от броя на полюсите му.

Предимства на този метод са: плавно завъртане на ротора, константен въртящ момент, добра ефективност, тих по отношение на доловими шумове.

Недостатъци са: по-сложен за имплементиране и съответно по-скъп, големи загуби от превключване на управляващите транзистори (не се преминава през състояние на висок импеданс).

### FOC управление

FOC управлението е комплексен алгоритъм, който се използва за прецизно и ефективно управление на скоростта и въртящия момент на безчетков мотор. Принципът се основава на ориентиране на статорното поле по такъв начин, че то да е перпендикулярно на магнитния поток на ротора, така че да се получи максимален въртящ момент във всяка позиция на мотора. На фиг. 2.6. е показана векторна диаграма, която показва ориентацията на статорното електрическо поле (q) спрямо магнитния поток на ротора (d).

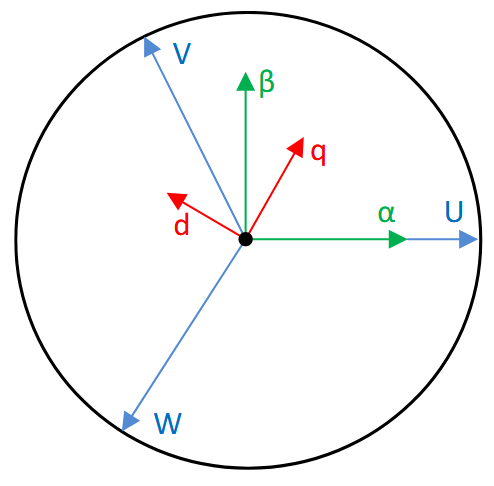
[picture p30: figure]

Фиг. 2.6. Векторна диаграма на FOC управление

Предимства на този метод са: максимална ефективност и въртящ момент на мотора, константен въртящ момент, тих по отношение на доловими шумове.

Недостатъци са: най-сложен за имплементиране и съответно най-скъп, големи загуби от превключване на управляващите транзистори (не се преминава през състояние на висок импеданс).

### Сравнение между трите вида управление

В табл. 2.1. е дадено сравнение между трите алгоритъма за управление на трифазни безчеткови мотори.

Табл. 2.1. Сравнение между алгоритмите за управление

| Трапецовидно | Синусоидално | FOC
Сложност на алгоритъма | Ниска | Средна | Висока
Ефективност на мотора | Ниска | Средна | Висока
Максимална скорост на мотора | Висока | Ниска | Висока
Загуби от превключване на управляващите транзистори | Малки | Големи | Големи
Пулсации на въртящия момент | Високи | Средни | Ниски
Уловим шум | Висок | Нисък | Нисък

Както беше споменато в т. 2.1.3. компресорната помпа, която ще бъде управлявана от проектираното устройство, използва безчетков мотор с трапецовидно обратно ЕДН. Вземайки това предвид, подходящи за целите на дипломната работа са трапецовидното и FOC управленията.

С това уточнение, вече могат да бъдат разгледани наличните на пазара интегрирани драйвери за управление на безчеткови мотори, като фокусът ще бъде върху такива, предлагащи трапецовидно и/или FOC управление. В следващата точка са дадени няколко варианта за такива драйвери и е избран един от тях, който най-добре покрива изискванията към устройството.

## 2.3. Интегрирани драйвери за управление на трифазни безчеткови мотори

Този тип интегрални схеми са сравнителна новост на пазара, която изглежда тепърва набира популярност. През последните години се наблюдава значително повишаване на наличните предложения и включване на все повече производители. В следващите точки са дадени някои примери за такива интегрирани драйвери, които са подходящи за съответното приложение. Изборът е ограничен от параметрите на компресорната помпа, която трябва да бъде управлявана:

- Захранващо напрежение: 24V
- Мощност: 100W
- Вид управление: Трапецовидно или FOC

### MCT8329A (Texas Instruments)[5]

На фиг. 2.7. е показана опростена вътрешна схема на този драйвер.

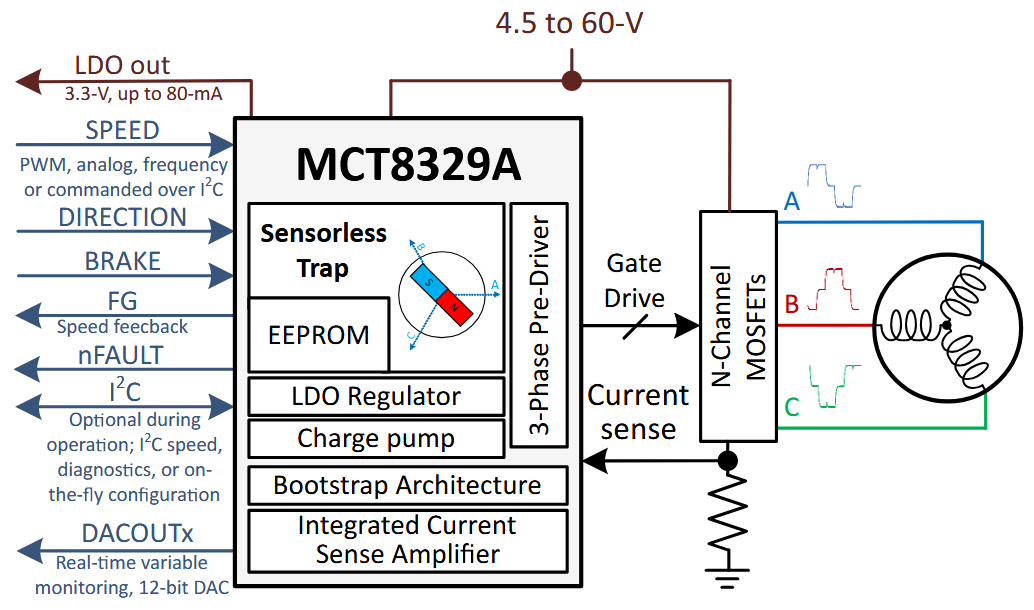
[picture p31: figure]

Фиг. 2.7. Опростена структурна схема на MCT8329A

Основни характеристики и предимства на MCT8329A:

- Трапецовидно управление (наличен и идентичен драйвер с FOC управление – MCF8329A);
- Напълно интегриран драйвер за външни транзистори;
- Много висок гейтов ток: 1A/2A (source/sink);
- Високо гейтово напрежение: 13V typ.;
- Наличен софтуер за лесна конфигурация;
- Възможност за управление на скоростта чрез широчинно-импулсна модулация (ШИМ), аналогово напрежение или честота;
- Извод за грешки.

Проблеми и недостатъци с оглед на конкретното приложение:

- Входовете и изходите са с фиксирани функции и няма възможност да се въведе сигнал според нуждите на устройството;
- Корпусът е с много малко разстояние между площадките (0.2mm), което прави монтажа труден и скъп.

Въпреки много добрите характеристики на този драйвер, трудният монтаж е основна причина той да не е подходящ за конкретното приложение.

### A89306 (Allegro)[6]

На фиг. 2.8. е показана опростена вътрешна схема на този драйвер.

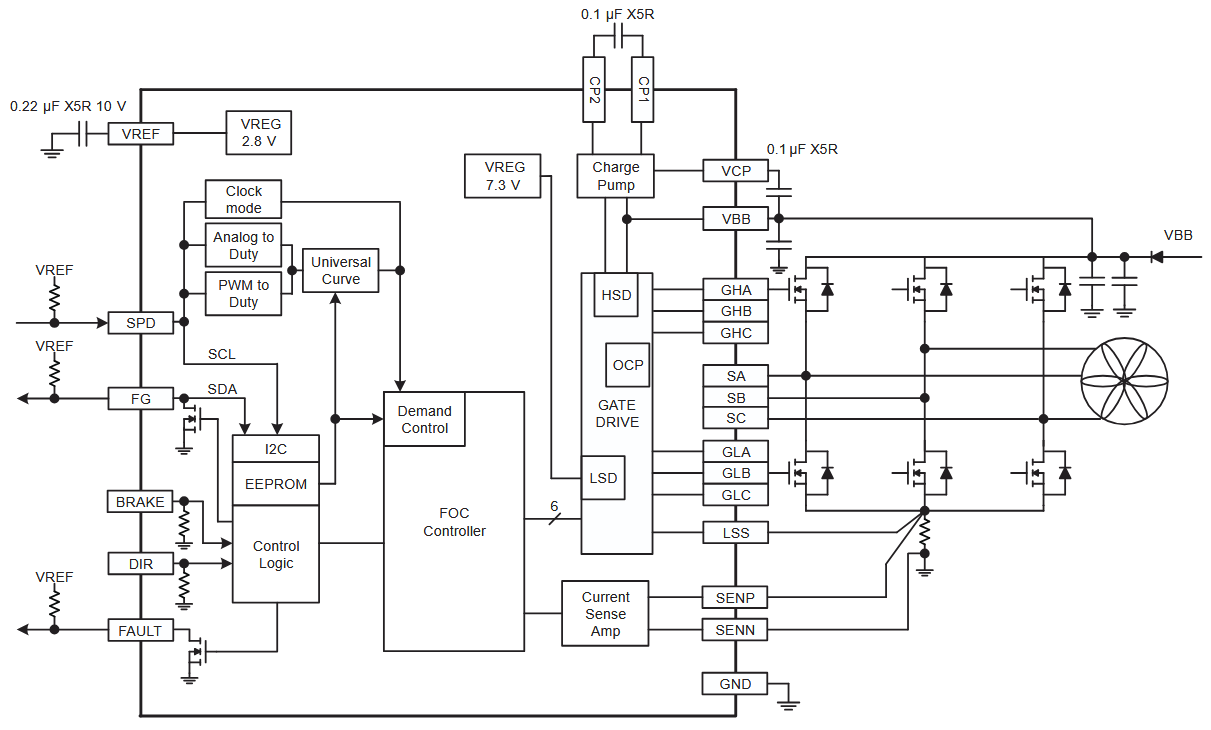
[picture p32: figure]

Фиг. 2.8. Опростена структурна схема на A89306

Основни характеристики и предимства на A89306:

- FOC управление;
- Напълно интегриран драйвер за външни транзистори;
- Възможност за управление на скоростта чрез ШИМ, аналогово напрежение или честота;
- Извод за грешки.

Проблеми и недостатъци с оглед на конкретното приложение:

- Промяната на конфигурацията е трудна поради липсата на софтуер;
- Входовете и изходите са с фиксирани функции и няма възможност да се въведе сигнал според нуждите на устройството;
- Гейтовият ток е нисък: 55mA/105mA (source/sink);
- Гейтовото напрежение е ниско: 6.8V min.

Тази ИС до голяма степен наподобява предложението на Texas Instruments (MCF8329A), но сравнително лошите характеристики на гейтовите драйвери я правят неподходяща за конкретното приложение (мощните транзистори, които ще се наложи да се използват, обикновено имат високо прагово напрежение от порядъка на над 5V).

### STSPIN32G0B1 (STMicroelectronics)[⁷]

На фиг. 2.9. е показана опростена вътрешна схема на този драйвер.

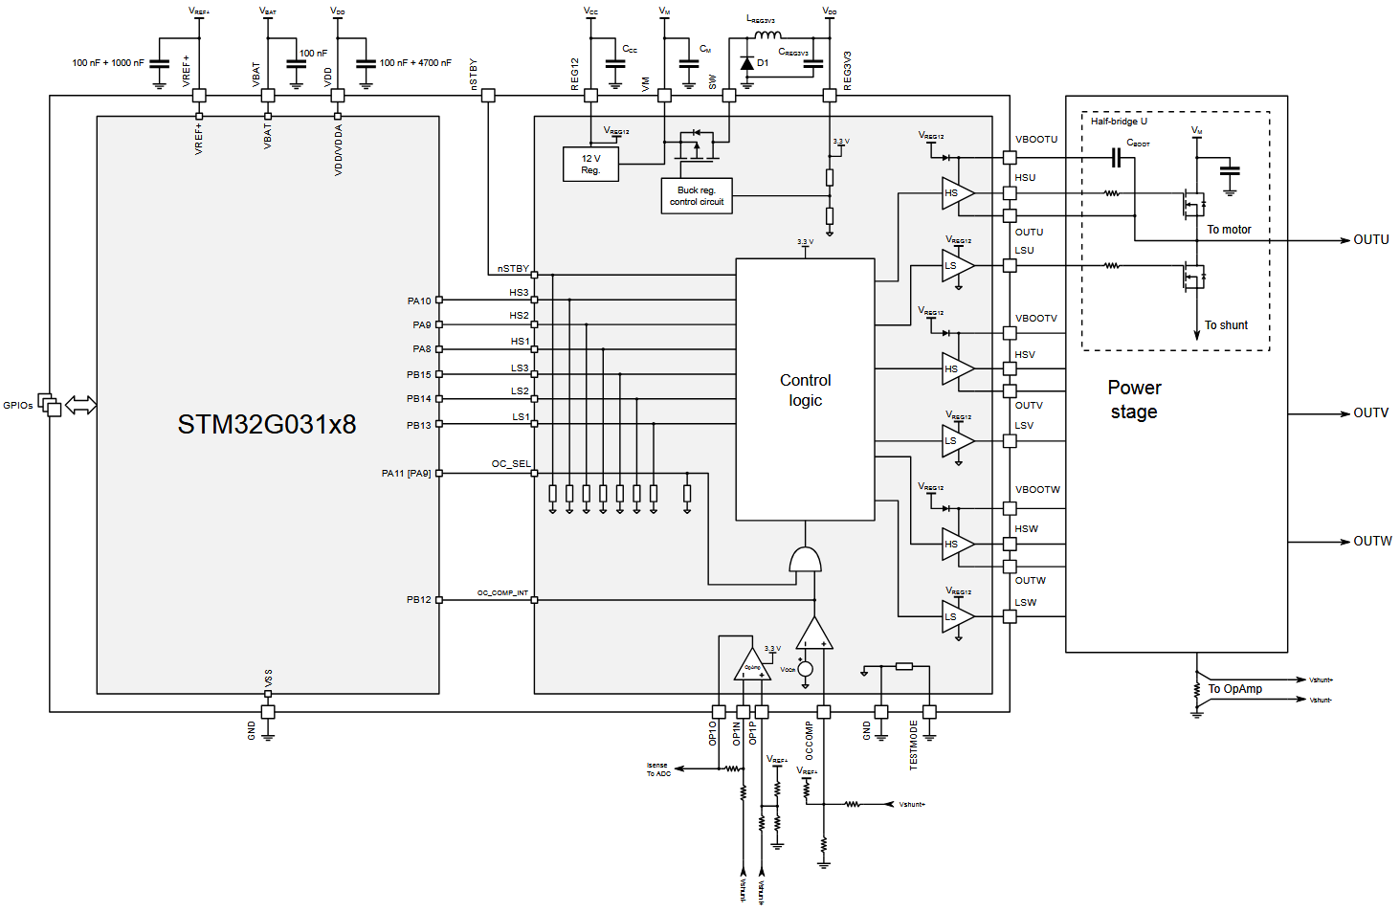
[picture p33: figure]

Фиг. 2.9. Опростена структурна схема на STSPIN32G0B1

Основни характеристики и предимства на STSPIN32G0B1:

- Възможност за избор между трапецовидно и FOC управление;
- Напълно интегриран драйвер за външни транзистори;
- Напълно програмируеми логически входове и изходи;
- Голяма свобода при конфигурирането и възможност за редактиране на управляващия фърмуер;
- Множество софтуерни инструменти, които улесняват настройката;
- Висок гейтов ток: 600mA (source/sink);
- Високо гейтово напрежение: 12V typ.;

Проблеми и недостатъци с оглед на конкретното приложение:

- Поради голямата свобода, която дава на потребителя, процесът по конфигурация има повече стъпки в сравнение с други драйвери, което прави допускането на грешки по-вероятно;

С изключение на повишения риск от допускане на грешки, този драйвер е много подходящ за конкретното приложение.

### IMD111T (Infineon)[8]

На фиг. 2.10. е показана опростена вътрешна схема на този драйвер.

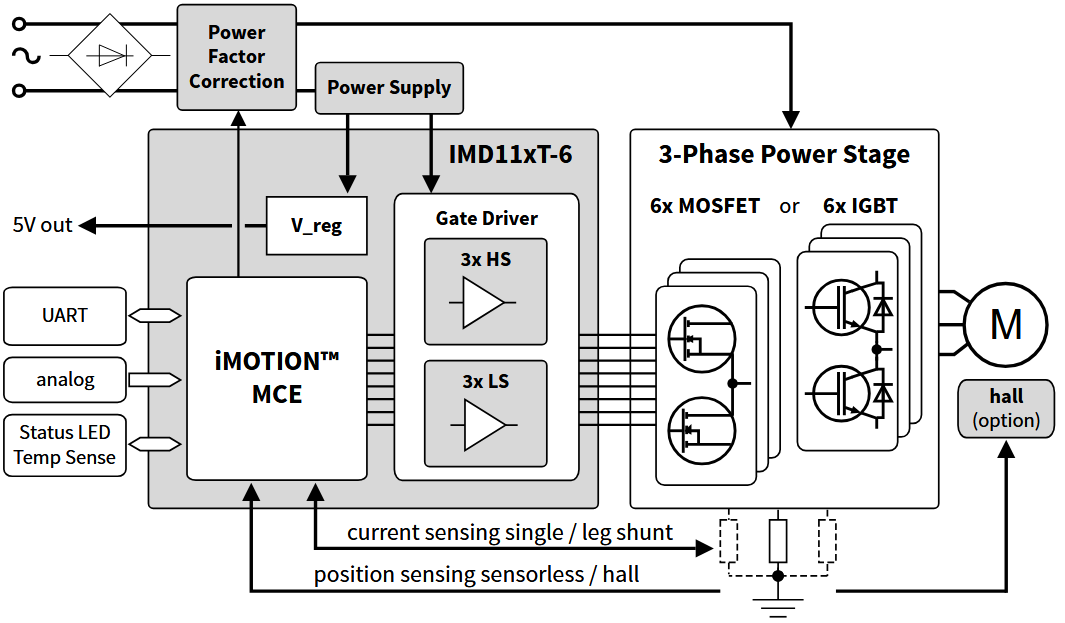
[picture p34: figure]

Фиг. 2.10. Опростена структурна схема на IMD111T

Основни характеристики и предимства на IMD111T:

- FOC управление;
- Напълно интегриран драйвер за външни транзистори;
- Задоволителен гейтов ток: 240mA/420mA (source/sink);
- Високо гейтово напрежение: 14.3V typ.;
- Наличен софтуер за лесна конфигурация;
- Възможност за управление на скоростта чрез широчинно-импулсна модулация (ШИМ), аналогово напрежение или честота;
- Възможност за изпълнение на прости скриптове за промяна на функцията на логическите входове и изходи;
- Лесно програмиране чрез UART интерфейс.

Проблеми и недостатъци с оглед на конкретното приложение:

- Вграденият в драйвера микроконтролер е специално разработен от Infineon и програмирането му се различава от програмирането на STM микроконтролери и се извършва с различни инструменти.

Този драйвер също е много подходящ за конкретното приложение. Наличието на т.нар. „Script Engine” позволява изпълнението на елементарни скриптове, чрез които могат лесно да бъдат присвоени определени функции на изводите му (например да се направи изход за грешки и вход за изчистване на грешки). За разлика от STSPIN32G0B1, при IMD111T не е възможно по погрешка да се промени фърмуерът, отговарящ за управлението на самия мотор.

Имайки предвид описаното в предходните точки, най-подходящи за целите на разработваното устройство са драйверите STSPIN32G0B1 на STMicroelectronics и IMD111T на Infineon. Поради по-малката вероятност от допускане на грешки при програмирането и по-малкото инструменти, нужни за конфигурация, ще бъде използван драйверът IMD111T.

## 2.4. Съществуващи решения

Като алтернатива за проектирането на специално устройство може да се разгледа използването на готови модули за управление на безчеткови мотори. На фиг. 2.11. е показан модулът JYQD-V8.3B[9], който може да се използва за управление на мотори до 168W (24V/7A).

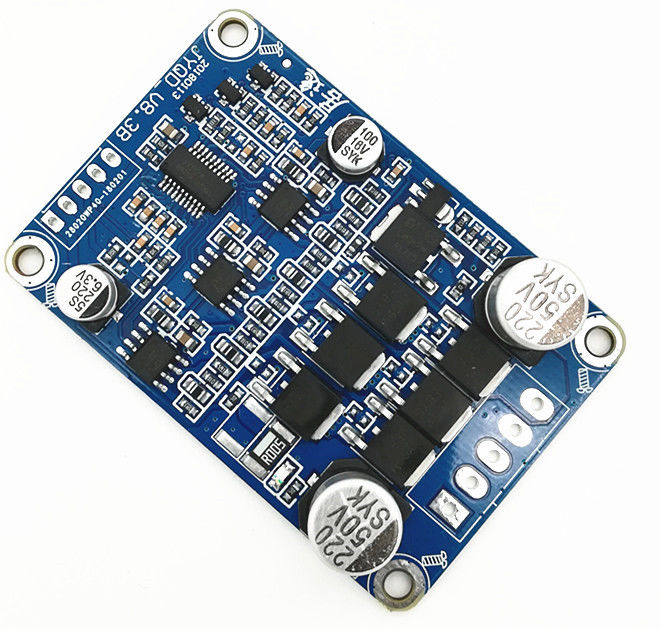
[picture p35: figure]
JYQD-V8.3B Sensorless BLDC Motor Driver PWM Frequency 1-20KHZ Duty Cycle 0-100%

Фиг. 2.11. Модул за управление на безчеткови мотори JYQD-V8.3B

На пръв поглед този модул изглежда подходящ, но използването му е свързано с определени проблеми и рискове:

- Съединителят, към който се включва компресорната помпа, е от различен вид и няма да може да се монтира;
- Управлението става чрез сигнали за посока и скорост на въртене, но липсва сигнал за грешка;
- Методът на управление е неизвестен и е възможно да се появят проблеми с устойчивостта на мотора при натоварване.
- Електромагнитната съвместимост на този модул е неизвестна и може да се окаже незадоволителна в чувствителни среди.

Много от производителите на продукти, използващи безчеткови мотори, предлагат управляващи модули като допълнителна опция към покупката. Такъв е и случаят за компресорната помпа, която трябва да бъде управлявана – HC100D2[10]. На фиг. 2.12. е показана компресорната помпа с предлагания от производителя модул за управление.

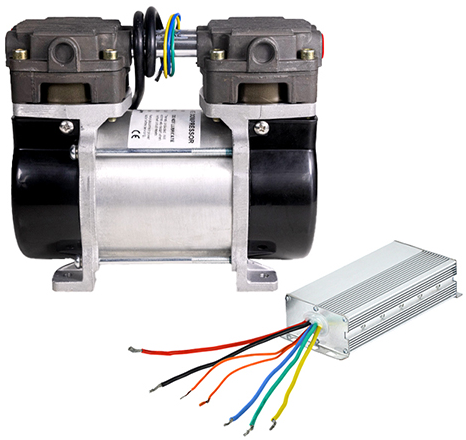
[picture p36: figure]

Фиг. 2.12. Компресорна помпа HC100D2 с управляващ модул

В много случаи използването на такъв модул може да се окаже икономически най-изгодно, тъй като е проектиран да бъде напълно съвместим с мотора.

От друга страна обаче, в конкретния случай с предлаганият от производителя модул има известни проблеми:

- Управлението е с фиксирана скорост, която не може да бъде променяна;
- Електрическите характеристики на модула не са дефинирани и не е гарантирано, че няма да бъдат променени в бъдеще;
- Очакваният живот на управляващия модул не е дефиниран и качеството на компонентите е неизвестно.

## 2.5. Заключение

Проектирането на специализиран модул за управление на компресорната помпа решава всички проблеми, изложени в предходната точка – могат да бъдат подбрани подходящи съединители, качествени компоненти с дълъг живот, могат да се обособят произволни сигнали според нуждите на устройството и може да се проектира печатна платка, съобразена с изискванията за електромагнитна съвместимост на средата. От друга страна, разработката на такъв модул може да се окаже доста скъпа, ако се налага и разработка на управляващ фърмуер.

Ето защо, за целите на дипломния проект ще бъде проектирано специализирано устройство за управление на компресорна помпа без разработка на управляващ фърмуер. Ще бъде използван интегрирания драйвер за управление на трифазни безчеткови мотори IMD111T на Infineon. Ще бъде експериментирано с различни скорости на въртене на безчетковия мотор в помпата и ще бъде избрана такава скорост, при която производителността и шума са добре балансирани.

# 3. Техническо задание

## 3.1. Цел и предназначение

Устройството трябва да може да се използва за управление на компресорна помпа без да се налага разработка на управляващ фърмуер.

## 3.2. Принцип на работа

Устройството трябва да има два входни сигнала – за пускане и спиране на помпата и за изчистване на записаните в драйвера грешки, и един изходен сигнал – за обозначаване на настъпил проблем с управлението. Скоростта на помпата трябва да може да се задава конфигурационно, но да остава постоянна при нормална работа. Захранващото напрежение на мотора трябва да бъде изцяло изключвано при получаване на сигнал за спиране на помпата. Включването на захранването при получаване на сигнал за стартиране на помпата трябва да става плавно, така че да не се натоварва захранващия модул с прекомерно големи импулсни токове. Устройството трябва да бъде проектирано да бъде максимално безшумно по отношение на електромагнитни смущения, така че да може да се използва в чувствителна среда.

## 3.3. Параметри (характеристики)

Изисквания към устройството:

- Захранващо напрежение: 24V DC;
- Мощност на управлявания безчетков мотор: 90W;
- Скорост на мотора: 200 до 2000RPM (според конфигурацията);
- Входни сигнали:
  - Пускане/спиране на мотора;
  - Изчистване на грешки.
- Изходни сигнали:
  - Грешка с модула.
- Възможност за изключване на захранването към мотора;
- Ограничаване на импулсните токове при стартиране на мотора;
- Генериране на грешки при:
  - Късо съединение;
  - Претоварване на мотора;
  - Блокиране на ротора;
  - Проблем с изпълнението на управляващия фърмуер;
  - Изключване на една от фазовите намотки;
  - Пренапрежение в захранването (над 28V).
- Индикация за успешно конфигуриран драйвер.

# 4. Блокова схема

На фиг. 4.1. е показана блоковата схема на проектираното устройство. Представени са четирите основни съставни блока на устройството, както и връзките между тях. С цел по-добра прегледност, връзките от блок „Захранване“ към всички останали блокове са изпуснати.

„Управление“ представлява външната печатна платка, изработваща сигналите за управление на безчетковия мотор (пускане/спиране) и драйвера (управление на грешки).

„BLDC мотор“ представлява компресорната помпа, която трябва да бъде управлявана от устройството.

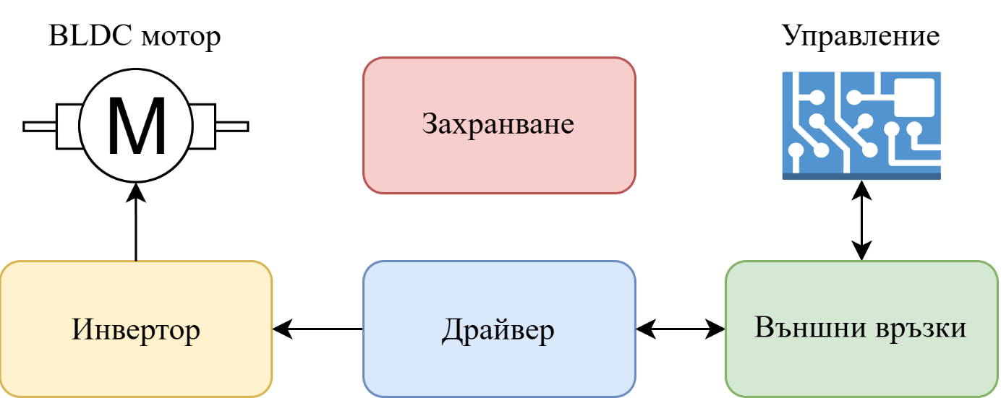
[picture p37: figure]

Фиг. 4.1. Блокова схема на устройството

Предназначението на всеки от съставните блокове е както следва:

1) Блок „Захранване“ – осигурява захранване на всички останали блокове и се грижи за плавно пускане и спиране на мотора;
2) Блок „Драйвер“ – изчислява и изработва необходимите сигнали за управление на транзисторите в блок „Инвертор“, изработва сигнали за настъпили грешки и ги изпраща към управляващата печатна платка посредством блок „Външни връзки“;
3) Блок „Инвертор“ – превключва големите токове, необходими за задвижване на безчетковия мотор и филтрира високочестотните съставки в управляващите сигнали и в напреженията на намотките с цел намаляване на излъчваните от устройството електромагнитни смущения;
4) Блок „Външни връзки“ – подготвя сигналите и осигурява връзка с външната управляваща печатна платка.

# 5. Принципна електрическа схема

При проектирането на принципната електрическа схема на устройството, изборът на схемни решения и елементи е съобразен най-вече с главната му функция – управление на компресорна помпа с безчетков мотор. От особена важност е устройството да бъде подходящо за серийно производство.

За всички блокове са използвани приспособени, но иначе добре познати от литературата схеми с подходящи за случая характеристики.

Всички елементи, използвани в принципната електрическа схема, са стандартни и широко разпространени. При избора на елементи, най- важните съображения са те да бъдат налични за закупуване от компанията, с подходящи характеристики за конкретното приложение и с добър баланс между цена и качество.

С така подбраните елементи, за функциониране на схемата са необходими три постояннотокови захранващи напрежения: +24V (за безчетковия мотор), +15V (за превключване на силовите транзистори в блок „Инвертор“) и +3,3V (за логическата част от схемата). Те се изработват от блок „Захранване“, описан подробно в т. 5.2.

## 5.1. Принципна електрическа схема в обобщен вид

На фиг. 5.1. е показана принципната електрическа схема на проектираното устройство в обобщен вид. Всеки от блоковете е представен чрез своето име и входно-изходни сигнали. Електрическите схеми на блоковете са дадени в следващите подточки, където е описан и процесът по проектирането им. Пълната принципна електрическа схема на устройството е дадена в Приложение 1.

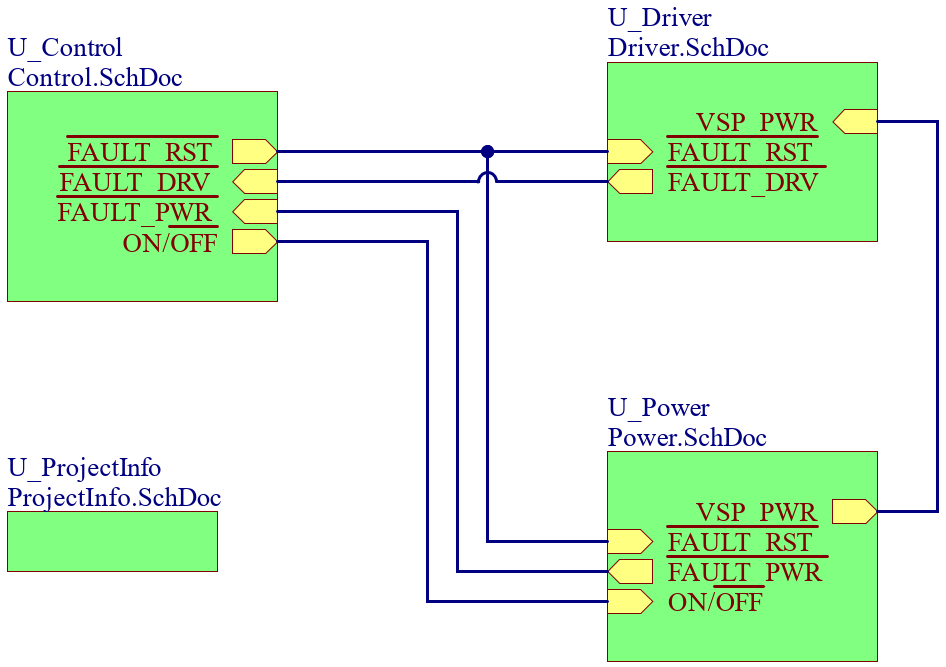
[picture p38: figure]

Фиг. 5.1. Принципна електрическа схема на устройството в обобщен вид

## 5.2. Блок „Захранване“

На фиг. 5.2. е показана принципната електрическа схема на блока.

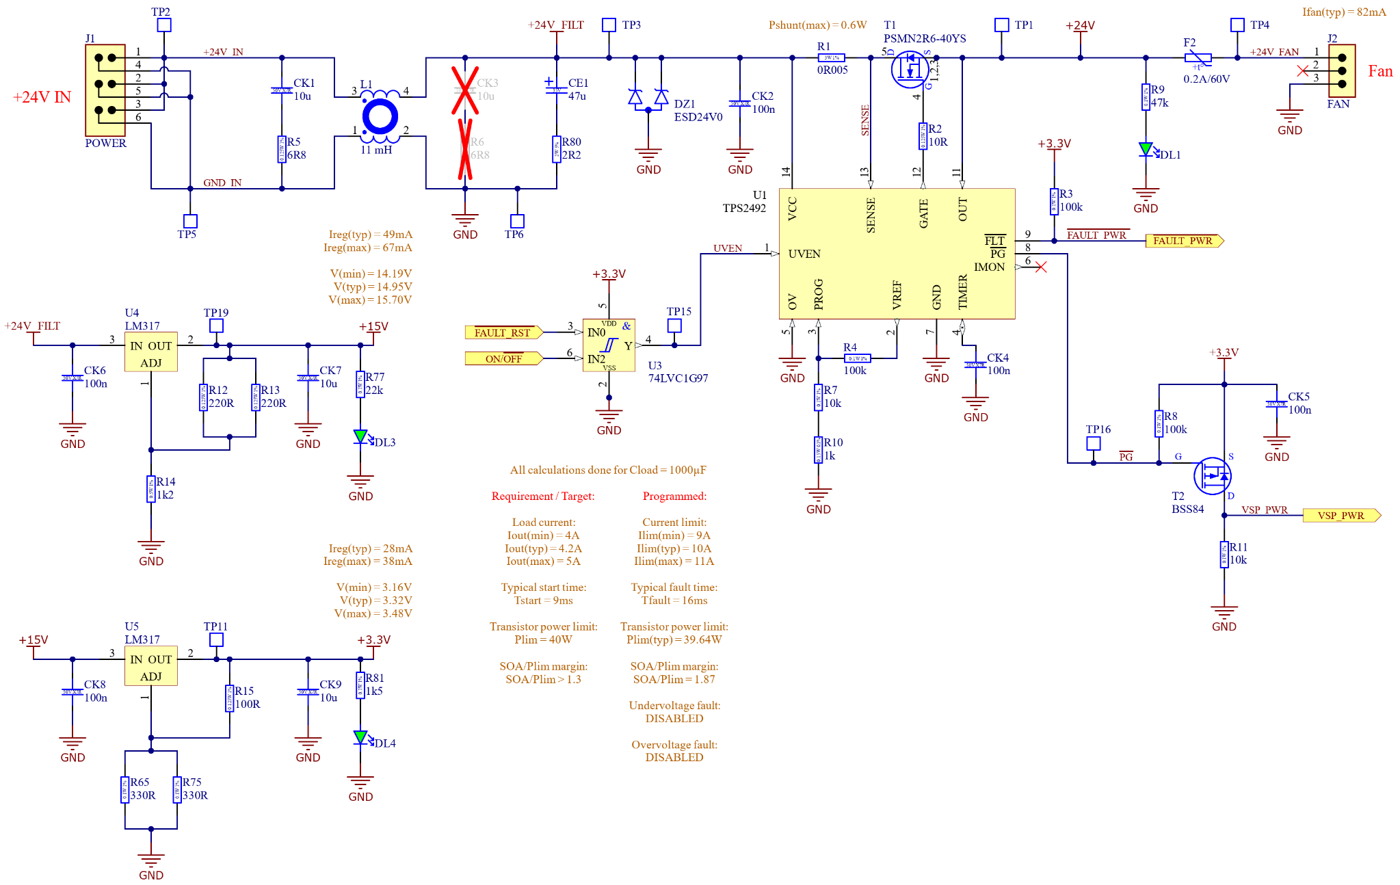
[picture p39: figure]

Фиг. 5.2. Принципна електрическа схема на блок „Захранване“

Устройството се захранва от външен източник на постоянно напрежение. Номиналната му стойност е +24V, като производителят гарантира стойности между +22V и +26V при нормална работа. Поради големите токове, които ще протичат през устройството при работещ мотор, връзката към захранващия модул се осъществява чрез кабел с общо 6 проводника – 3 за захранване (+) и 3 за маса (-). За включване на кабела към устройството е предвиден съединителят J1.

Смущения, предавани по захранващия кабел, могат да бъдат опасни за схемата и е необходимо да бъдат филтрирани. Кондензаторът CK1 и резисторът R5 образуват т.нар. гасител (snubber). Неговото предназначение е да премахва високочестотните пикове в захранващото напрежение, като разсейва енергията им в резистора. Стойностите на компонентите не са критични и силно зависят от честотата на смущението, което се цели да се премахне. Избрани са стандартни стойности, съобразени с по-често наблюдаваните смущения (10μF и 6.8Ω).

Шумовете от околната среда най-често са синфазни (влияят еднакво на всички проводници в захранващия кабел). За филтрирането им е предвиден синфазният дросел L1 (т.нар. Common Mode Choke).

В изхода на дросела се получава постоянното захранващо напрежение на устройството, обозначено с етикетите +24V_FILT и GND. Това напрежение се явява вътрешно за схемата, но то също е податливо на високочестотни смущения (например породени от превключване на безчетковия мотор). За потискането им е предвиден втори гасител, съставен от кондензатора CE1 и резистора R80. Избрани са стандартни стойности, съобразени с по-често наблюдаваните смущения (47μF и 2.2Ω).

За коректна работа на схемата са необходими още две постоянни захранващи напрежения: +15V и +3,3V. Единият вариант за изработването им е чрез превключващи регулатори (т.нар. Switch-Mode Power Supplies – SMPS) а другия – чрез линейни регулатори.

Линейните регулатори обикновено са по-евтини и заемат по-малко пространство на платката, но за сметка на това имат ниско КПД, което директно зависи от разликата в напреженията във входа и изхода им. Мощността, която трябва да разсейва линейния регулатор, се изчислява по следния алгоритъм:

P_D =(U_(out) -U_(in) ).I_(out)

P_D -разсейвана мощност от регулатора

U_(out) -изходно напрежение на регулатора

U_(in) -входно напрежение на регулатора

I_(out) -изходен ток на регулатора

Въпреки че в случая разликата между входното и изходното напрежение е значителна, консумацията на ток е сравнително ниска, което прави използването на линейни регулатори възможно (и по-изгодно).

За изработване на захранващите напрежения +15V и +3,3V се използват съответно регулаторите U4 и U5 (от вида LM317). На входовете им с цел премахване на смущения са свързани филтровите кондензатори CK6 и CK8. В изходите им с цел подобряване на реакцията им към преходни процеси (например резки промени в консумацията) са свързани кондензаторите CK7 и CK9. Стойностите на всички кондензатори са съобразени с препоръките на производителя на интегралните линейни регулатори.

Изходното напрежение на линейните регулатори LM317 се изчислява по следната формула (от документацията):

U_(out) =U_(ref) . (1+(R_L)/(R_U))+I_(Adj) R_L

U_(out) -изходно напрежение на регулатора

U_(ref) -референтно напрежение на регулатора (U_(out) -U_(adj) )

R_L -резистор, свързан между извод 1 (ADJ) и маса

R_U -резистор, свързан между извод 1 (ADJ) и извод 2 (OUT)

I_(Adj) -ток, протичащ от извод 1 (ADJ) през R_L към маса

За да гарантира правилна работа на регулатора, производителят изисква в изхода му винаги да протича ток Iout ≥ 10mA. Вземайки това предвид, изборът на резистори става по следния алгоритъм:

Избираме I_(R_U) =10mA

R_U =(U_(ref))/(I_(R_U))=(1,25)/(10 .10^(-3))=125Ω

U_(out) =U_(ref) . (1+(R_L)/(R_U))+I_(Adj) R_L ⇒R_L =(U_(out) -U_(ref))/((U_(ref))/(R_U)+I_(ADJ))

За +15V регулатор U4:

Избираме R_U =110Ω

R_L =(U_(out) -U_(ref))/((U_(ref))/(R_U)+I_(ADJ))=(15-1,25)/((1,25)/110+50 . 10^(-6))=1205Ω=1,2kΩ

Избрани са резистори със стандартни стойности, близки до изчислените – два резистора по 220Ω (R12 и R13), свързани в паралел – общо 110Ω за горния резистор и 1,2kΩ (R14) за долния резистор.

За +3,3V регулатор U5:

Избираме R_U =100Ω

R_L =(U_(out) -U_(ref))/((U_(ref))/(R_U)+I_(ADJ))=(3,3-1,25)/((1,25)/100+50 . 10^(-6))=163Ω

Избрани са резистори със стандартни стойности, близки до изчислените – 100Ω (R16) за горния резистор и два резистора по 330Ω (R65 и R75), свързани в паралел – общо 165Ω за долния резистор.

Необходимо е също да бъде изчислена работната температура на двата регулатора. За целта трябва първо да се определи максималният товарен ток за всяко от захранванията.

Основният консуматор за +3,3V захранването е драйвера на безчетковия мотор (от блок „Драйвер“) – данните са дадени от производителя и са взети от документацията. Като се предвиди и известен запас за други консуматори в схемата (логически елементи, издърпващи резистори и др.), финалните стойности придобиват следния вид:

I_(+3,3V_((nom))) =I_(DD_((nom))) +I_(ext_((nom))) =12mA+3mA=15mA

I_(+3,3V_((max))) =I_(DD_((max))) +I_(ext_((max))) =20mA+5mA=25mA

Като се вземе предвид и консумацията на настройващия делител:

I_(U4_((nom))) =I_(+3,3V_((nom))) +(U_(ref_((nom))))/(R_(U_((nom))))=15mA+(1,25V)/(100Ω)=27,5mA

I_(U4_((max))) =I_(+3,3V_((max))) +(U_(ref_((max))))/(R_(U_((min))))=25mA+(1,3V)/(99Ω)=38,13mA

Температурата на регулатора зависи от вида на корпуса и големината на охлаждащата площ, върху която е монтиран. За изчисленията е използвана сравнително консервативна стойност на топлинното съпротивление Rθ = 50K/W. При температура на околната среда Tamb = 40°C, температурата на регулатора е:

P_(U4_((nom))) =(U_(in_((nom))) -U_(out_((nom))) )I_(U4_((nom)))

P_(U4_((nom))) =(14,95V-3,32V) . 27,5mA=0,32W

P_(U4_((max))) =(U_(in_((max))) -U_(out_((min))) )I_(U4_((max)))

P_(U4_((max))) =(15,89V-3,14V) . 38,13mA=0,49W

T_(U4_((nom))) =R_Θ . P_(U4_((nom))) +T_(amb) =50 . 0,32+40=56°C

T_(U4_((max))) =R_Θ . P_(U4_((max))) +T_(amb) =50 . 0,49+40=64,5°C

Основен консуматор за +15V захранването са токовете, зареждащи гейтовите капацитети на мощните транзистори от блок „Инвертор“:

Гейтов заряд: Q_(G_((max))) =63nC

Честота на превключване: f_(sw_((nom))) =24kHz, f_(sw_((max))) =40kHz

Общ брой транзистори: N=6

I_(G_((nom))) =Q_(G_((max))) . f_(sw_((nom))) =63nC . 24kHz=1,51mA

I_(+15V_((nom))) =N . I_(G_((nom))) =6 . 1,51m=9,06mA

I_(G_((max))) =Q_(G_((max))) . f_(sw_((max))) =63nC . 40kHz=2,52mA

I_(+15V_((max))) =N . I_(G_((max))) =6 . 2,52m=15,12m

Като се вземат предвид и консумацията на драйвера, консумацията на линейния регулатор U4 (свързан към изхода на U5) и консумацията на настройващия делител:

I_(U5_((nom))) =I_(+15V_((nom))) +I_(CC_((nom))) +I_(U4_((nom))) +(U_(ref_((nom))))/(R_(U_((nom))))

I_(U5_((nom))) =9,06mA+0,75mA+27,5mA+(1,25V)/(110Ω)=48,67mA

I_(U5_((max))) =I_(+15V_((max))) +I_(CC_((max))) +I_(U4_((max))) +(U_(ref_((max))))/(R_(U_((min))))

I_(U5_((nom))) =15,12mA+1,5mA+38,13mA+(1,3V)/(108,9Ω)=66,69mA

Температурата на регулатора е:

P_(U5_((nom))) =(U_(in_((nom))) -U_(out_((nom))) )I_(U5_((nom)))

P_(U5_((nom))) =(24V-14,95V) . 48,67mA=0,44W

P_(U5_((max))) =(U_(in_((max))) -U_(out_((min))) )I_(U5_((max)))

P_(U5_((max))) =(26V-14,04V) . 66,69mA=0,80W

T_(U5_((nom))) =R_Θ . P_(U5_((nom))) +T_(amb) =50 . 0,44+40=62°C

T_(U5_((max))) =R_Θ . P_(U5_((max))) +T_(amb) =50 . 0,8+40=80°C

Добра практика е към източниците на захранващи напрежения да бъдат свързани индикаторни светодиоди, чрез които лесно да може да се потвърди че функционират нормално. Токът през тях е добре да бъде малък, защото са необходими само за сервизни цели.

Към регулаторите U4 и U5 са свързани зелени индикаторни светодиоди DL3 и DL4. Стойностите на токоограничаващите резистори се изчисляват по следния алгоритъм:

Избираме I_(DL3) =I_(DL4) =0,5mA

R_(lim_(+15V)) =(U_(out_(U4)) -U_(F_(DL3)))/(I_(DL3))=(15V-2,5V)/(0,5mA)=25kΩ

R_(lim_(+3,3V)) =(U_(out_(U5)) -U_(F_(DL4)))/(I_(DL4))=(3,3V-2,5V)/(0,5mA)=1,6kΩ

Избрани са резистори със стандартни стойности, близки до изчислените – 22kΩ (R77) и 1,5kΩ (R81).

От гледна точка безопасност, важно изискване към устройството е захранването към мотора да бъде изцяло изключвано, когато не е необходимо (т.е. когато моторът е спрян). За да се осигури стабилна работа на мотора, към захранването му обикновено се включват големи кондензатори (от порядъка на стотици μF до няколко mF). При липса на метод за ограничаване на зарядния им ток, той може да достигне много големи стойности (от порядъка на стотици A). Освен че тези токове са опасни за елемента, превключващ захранването (обикновено транзистор), те също могат да доведат и до катастрофално пропадане на напрежението на захранващия модул, от което той да не може да се възстанови. Поради тези причини, при превключването на голям капацитивен товар е от особена важност да се предвидят методи за ограничаване на пусковия ток.

В конкретното устройство тази функция се изпълнява от интегралния контролер TPS2492 (U1) на фирмата Texas Instruments. Неговото предназначение е да управлява отпушването на външния NMOS транзистор, който превключва захранването към мотора. Контролерът едновременно следи тока през транзистора и неговото дрейн-сорс напрежение, като цели постигане на постоянна мощност по време на целия пусков процес. По този начин се гарантира, че транзисторът никога не излиза от своята област на безопасна работа (Safe Operating Area – SOA). Мощността на транзистора, която контролерът поддържа, се задава от проектанта чрез програмиращи резистори (включени между изводите VREF и PROG).

Освен управлението на мощността, контролерът има и други полезни функции. Те включват:

- Програмируема грешка за ниско напрежение (UV);
- Програмируема грешка за високо напрежение (OV);
- Програмируемо време за грешка при претоварване (TIMER);
- Сигнал за грешка с контролера (\FLT);
- Сигнал за успешно включване на захранването (\PG);
- Аналогово напрежение за следене на тока (IMON).

За да се гарантира, че захранващото напрежение никога няма да достигне опасни за контролера стойности, паралелно на извод VCC е свързан диод за предпазване от транзиентни напрежения (т.нар. Transient Voltage Suppressor – TVS) от вида ESD24V0 (DZ1). Предвиден е също филтров кондензатор със стандартна стойност 100nF (CK2).

Захранването в изхода на контролера трябва да бъде активно само тогава, когато устройството получи команда за стартиране на мотора. Пускането на захранването става чрез подаване на високо логическо ниво на извод UVEN. В случай на грешка, контролерът запушва транзистора и изработва сигнал за грешка на извод \FLT. Грешката остава активна, докато на извод UVEN не бъде подадено ниско ниво (т.е. контролерът получи сигнал за изключване на захранването). В схемата сигналите за пускане/спиране на мотора (ON/O\F\F\) и изчистване на грешки (\FAULT_RST) са свързани към извод UVEN през логически елемент И от вида 74LVC1G97 (U3). При това положение, в случай на отчетена грешка от контролера, има два начина тя да бъде изчистена – чрез подаване на сигнал за спиране на мотора или чрез подаване на сигнал за изчистване на грешки. По този начин се гарантира, че сигналът за изчистване на грешки ще извършва очакваното действие дори тогава, когато не е подаден сигнал за спиране на мотора.

Сигналът за настъпила грешка в контролера (извод \FLT) се използва от блок „Външни връзки“ като един от критериите за грешка с устройството. Тъй като при нормална работа на контролера този сигнал е в състояние на висок импеданс, към него е свързан издърпващ резистор към захранване със стандартна стойност, препоръчана от производителя – 100kΩ (R3).

Сигналът за успешно включване на захранването (извод \PG) е много подходящ за синхронизация – чрез него може да се гарантира, че захранването на мотора е в коректни граници преди да започне изработването на управляващи сигнали от драйвера (блок „Драйвер“) за изходните транзистори (блок „Инвертор“). Сигналът VSP_PWR се явява захранване за схемотехниката, която изработва аналогово напрежение за задаване на скоростта на мотора (описано подробно в т. 5.4.). За да се получи този сигнал, е необходимо сигналът от извод \PG да бъде инвертиран, като е важно високото логическо ниво да бъде нискоимпедансна връзка към +3,3V. Това се постига чрез PMOS транзистор от вида BSS84 (T2), който има ниско напрежение на отпушване VGS(th) = -2V. При запушен транзистор, ниското ниво за VSP_PWR се осигурява от издърпващ резистор със стандартна стойност 10kΩ (R11). За стабилизиране на захранването на транзистора, към него е свързан също филтров кондензатор със стандартна стойност 100nF (CK5).

Тъй като в неактивното си състояние \PG сигналът е в състояние на висок импеданс, към него е свързан издърпващ резистор към захранване със стандартна стойност, препоръчана от производителя – 100kΩ (R8).

Мощният NMOS транзистор, който превключва захранването към мотора, е от вида PSMN2R6-40YS (T1). От особена важност е този транзистор да има много ниско съпротивление дрейн-сорс сорс във включено състояние, за да се минимизира самонагряването и съответно температурата му. В случая производителят гарантира RDS(on) ≤ 5,3mΩ, което при консумация IDS = 10A се равнява на загуби от порядъка на PD = RDS(on) . IDS² = 0,53W. За ограничаване на максималния му гейтов ток е свързан резистор със стандартна стойност 10Ω (R2).

Тъй като в заданието не се включва следене на входното напрежение, изводът OV е свързан към маса (по препоръка на производителя) и не се използва. Не е предвидено също следене на консумацията на мотора – изводът IMON не е свързан (по препоръка на производителя).

Останалите елементи, свързани към контролера, служат за програмиране на неговите функции – максималния пусков ток (чрез шунтовия резистор), максималната мощност на транзистора (чрез резисторния делител) и времето за изработване на грешка при претоварване (чрез кондензатора). Тези елементи могат да се изчислят по алгоритмите, дадени в документацията на контролера, но в случая е по-удобно да се използва специално предоставения от производителя софтуер.

На фиг. 5.3. са показани входните данни, въведени в софтуера. Границите на входното напрежение се определят от външния модул, който осигурява захранването на схемата. Максималният товарен ток е изчислен от максималната мощност на мотора, който ще бъде управляван (IOUT(MAX) = PMOT(MAX) / VIN(MIN) = 90W / 22V = 4,09A), като в софтуера е използвана леко завишена стойност с цел по-добра надеждност. Товарният капацитет зависи най-вече от стабилизиращите захранването кондензатори в блок „Инвертор“. Използват се три паралелно свързани кондензатора с обща стойност 3 . 270μF = 810μF, като в софтуера е използвана леко завишена стойност с цел по-добра надеждност. Максималната температура на околната среда зависи от експлоатационните условия на устройството и е дадена по задание, като в реалността се очаква винаги да бъде по-ниска от зададената (65°C).

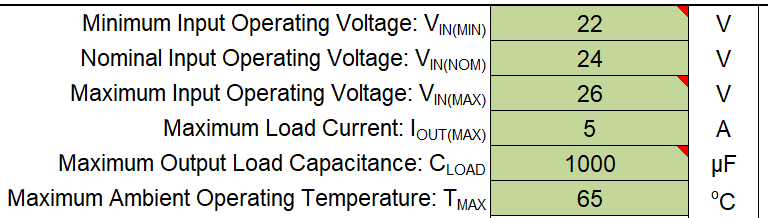
[picture p40: figure]

Фиг. 5.3. Програмиране на TPS2492 – входни данни

На фиг. 5.4. са показани изчисленията за програмиране на максималния ток през транзистора. Избран е шунтов резистор с близка, но по-малка от изчислената от софтуера стойност – 5mΩ (R1). При така подбрана стойност, програмираният максимален пусков ток ще бъде между 9A-11A, с номинална стойност 10A. Вижда се също, че е необходимо да се използва достатъчно мощен шунтов резистор, който да може да разсее поне 0,6W. В случая избраният резистор е с максимална мощност 3W.

Фиг. 5.4. Програмиране на TPS2492 – максимален ток

На фиг. 5.5. са показани изчисленията за програмиране на максималната мощност на транзистора. Всички параметри на транзистора са взети от документацията. Топлинното му съпротивление зависи от вида на корпуса и големината на охлаждащата площ, върху която е монтиран. Използвана е сравнително консервативна стойност: Rθ = 30°C/W. Вижда се, че температурата му в нормален режим е едва 2,8°C над зададената околна температура. Избраната максимална мощност на транзистора е възможно най-малката, която може надеждно да се отчете от контролера, като по този начин се гарантира, че превключването на захранването няма да го натоварва излишно. Програмирането на мощността става чрез резисторен делител. Единият от резисторите (между VREF и PROG изводите) е избран със стандартна стойност 100kΩ (R4). За да се постигне желаният лимит на мощността, за другия резистор са използвани последователно свързани резистори със стандартни стойности 10kΩ (R7) и 1kΩ (R10). С така подбрани стойности, изчисленият лимит на мощността е 39,64W.

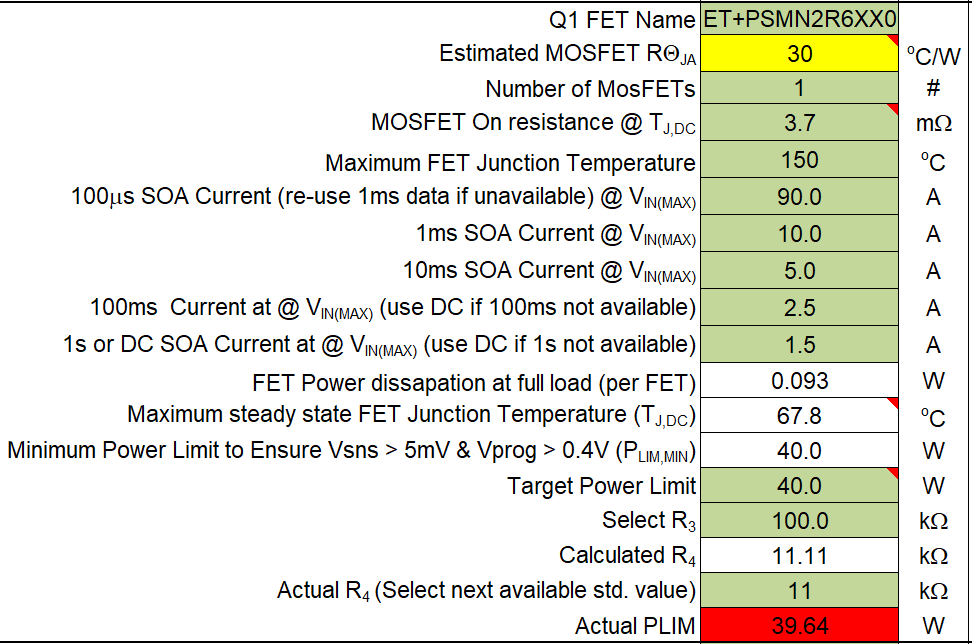
[picture p41: figure]

Фиг. 5.5. Програмиране на TPS2492 – максимална мощност

На фиг. 5.6. е представена графика, която показва сравнение между ограничената от контролера област на работа на транзистора (в червено) спрямо дадената в документацията на транзистора област на безопасна работа (SOA) (в зелено). Вижда се, че контролерът винаги ще поддържа транзистора в безопасната област.

Фиг. 5.6. Програмирана област на работа (червено) спрямо SOA (зелено)

На фиг. 5.7. са показани изчисленията за програмиране на времето за изработване на грешка при претоварване на транзистора. Контролерът стартира вътрешен таймер в случаите, когато се прилага ограничение на тока или мощността на транзистора. Ако този таймер надвиши програмираното време, захранването се изключва и контролерът изработва сигнал за грешка. При нормален режим на работа, включването на захранването е свързано с определен период на ограничаване на тока/мощността на транзистора, докато трае зареждането на кондензаторите в изхода му. Типичната стойност на това време в нормален режим на работа е изчислена от софтуера – Tstart = 9,04ms. За да се гарантира правилна работа на схемата, програмираното време за изработване на грешка трябва да е по-голямо от това време. Препоръчва се също да се избере достатъчно по-голяма стойност, така че да се гарантира устойчивост на схемата. Изчисленото от софтуера препоръчително време за изработване на грешка е Tstart + Tmargin = 15,83ms, което се постига със свързване на кондензатор с капацитет Ctarget = 98,93nF към извод TIMER. За схемата е избран кондензатор със стандартна стойност 100nF (CK4). При така подбрана стойност, действителното време за изработване на грешка е Tfault = 16ms.

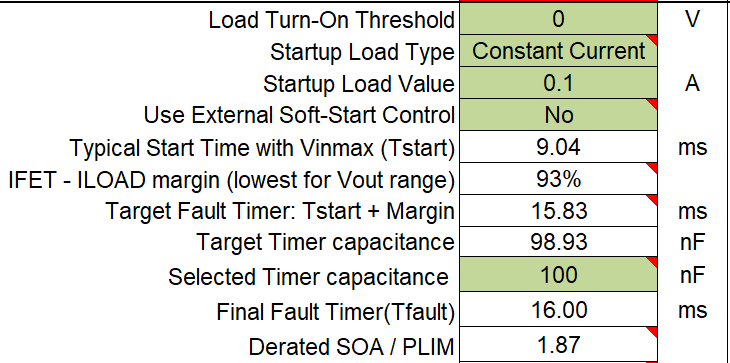
[picture p42: figure]

Фиг. 5.7. Програмиране на TPS2492 – време за грешка

На фиг. 5.8. е представена времедиаграма, която показва изчислената от софтуера мощност на транзистора при включване на захранването.

Фиг. 5.8. Мощност на транзистора при включване на захранването

Към изхода на контролера е свързан зелен индикаторен светодиод DL1. Стойността на токоограничаващия резистор се изчислява по следния алгоритъм:

Избираме I_(DL1) =0,5mA

R_(lim_(+24V)) =(U_(out_(U1)) -U_(F_(DL1)))/(I_(DL1))=(24V-2,5V)/(0,5mA)=43kΩ

Избран е резистор със стандартна стойност, близка до изчислената –47kΩ (R9).

Оригиналното управление, което проектираното устройство трябва да замени, позволява свързване на охлаждащ вентилатор към захранването на мотора. За съединяването му е предвиден куплунгът J2. За да се предпази схемата от късо съединение във веригата на вентилатора, последователно на него е свързан бушон с максимална стойност на тока 200mA (F2).

На ключови места от схемата на блока са свързани тестови точки (TP1–TP6, TP11, TP15, TP16, TP19) с цел лесно измерване на сигналите в реални условия.

## 5.3. Блок „Инвертор“

На фиг. 5.9. е показана принципната електрическа схема на блока.

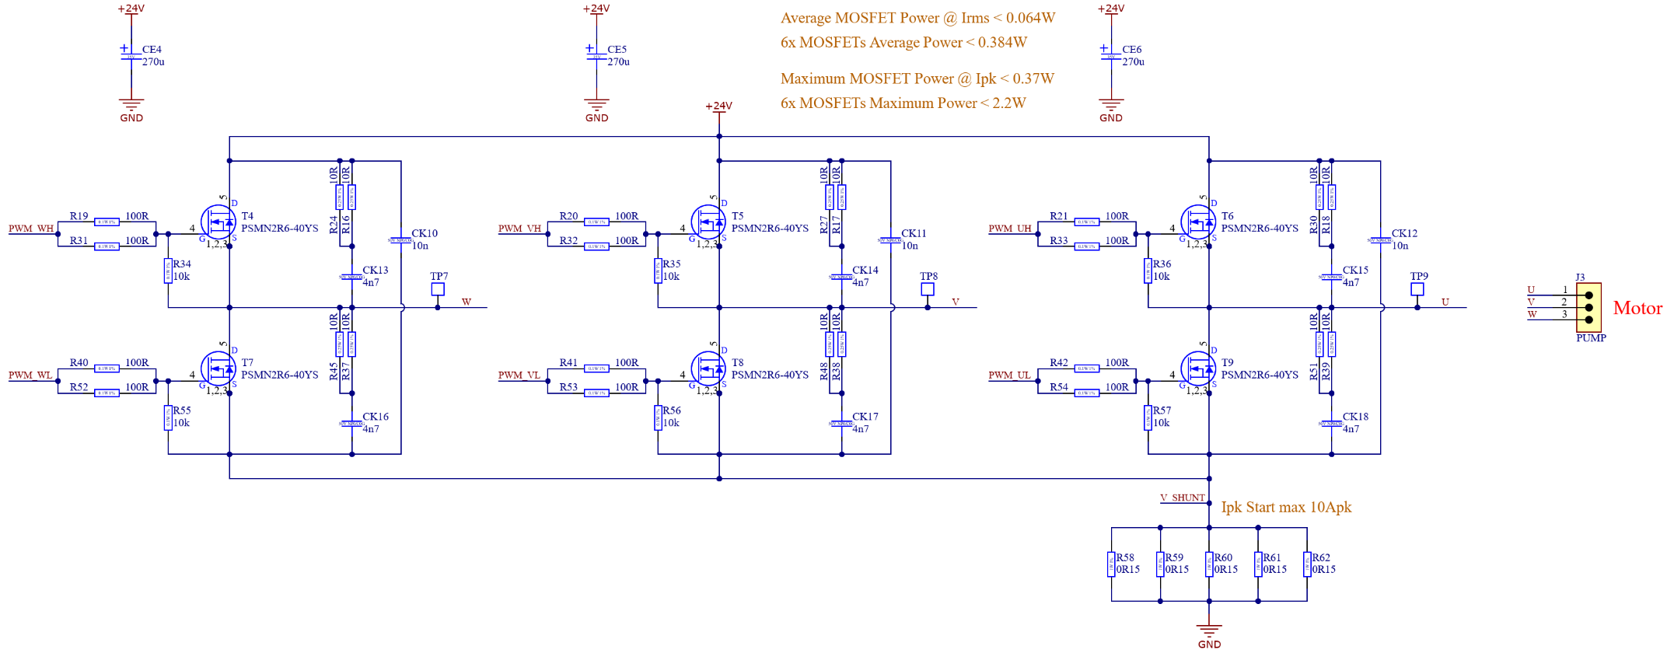
[picture p43: figure]

Фиг. 5.9. Принципна електрическа схема на блок „Инвертор“

Блокът се състои от три идентични полумостови схеми, по една за всяка фаза на безчетковия мотор (U, V и W). За свързване на безчетковия мотор към схемата е предвиден куплунгът J3.

Важно условие за надеждна работа на мотора е захранването му да бъде устойчиво на резки пикове в консумацията. За целта към него обикновено се включват големи електролитни кондензатори, които да осигурят необходимите импулсни токове. Тези кондензатори трябва от една страна да бъдат достатъчно големи, така че да осигурят необходимата стабилност на схемата, а от друга – достатъчно малки, така че да не заемат прекалено много място на платката или да я оскъпяват излишно. В конкретния случай са използвани три паралелно свързани кондензатора със стандартна стойност 270μF (CE4-CE6), които образуват сумарен капацитет 810μF. Експериментално може да се потвърди, че този капацитет е достатъчен за управлявания мотор.

При избора на NMOS транзистори за полумостовите схеми, най-важното условие е те да бъдат с достатъчно ниско RDS(on) съпротивление, за да се минимизира самонагряването и съответно температурата им. В случая могат да се използват транзистори, идентични с превключващия захранването NMOS (блок „Захранване“) – PSMN2R6-40YS (T4-Т9), като по този начин се намалява необходимият брой елементи за насищане на схемата. При пикова консумация IDS = 10A, загубите във всеки от транзисторите са около PD = 0,53W.

Гейтовете на транзисторите се управляват от правоъгълни импулси, изработвани от драйвера (блок „Драйвер“). За да се даде възможност за ограничаване на времето за превключване, към всеки гейт са свързани два паралелни резистора със стандартна стойност 100Ω (R19-R21, R31-R33, R40-R42, R52-R54), образуващи общо съпротивление 50Ω. При увеличаване на гейтовото съпротивление, скоростта на превключване на транзистора намалява, а от там намаляват и излъчваните от него високочестотни шумове. Това може да се окаже много важно при сертифициране на устройството за електромагнитна съвместимост (ЕМС). От друга страна, с повишаване на гейтовото съпротивление растат и загубите в него. Обикновено точната му стойност се избира след провеждане на експерименти с готовото устройство. Предпочита се максимално ниско съпротивление, така че шумовете от превключване да бъдат приемливи, а загубите в резисторите – минимални.

В процеса на включване на интегралните драйвери и контролери, често срещана практика е входно-изходните изводи да бъдат в състояние на висок импеданс. За да се гарантира, че при това положение транзисторите ще бъдат запушени, към гейтовете на всеки от тях е свързан издърпващ резистор към най-отрицателния им потенциал. Резисторите са със стандартна стойност 10kΩ (R34-R36, R55-R57).

Превключването на голям индуктивен товар (какъвто е безчетковият мотор) обикновено води до осцилации в напреженията в изходите на полумостовите схеми. Тези осцилации обикновено се проявяват като високочестотни смущения, които значително влошават представянето на схемата в контекста на ЕМС сертификацията. За да се премахнат тези осцилации, към всеки от транзисторите е включен гасител (snubber)[11]. За всеки от тях са използвани стандартни елементи – два паралелно свързани резистора със стандартна стойност 10Ω (R16-R18, R24, R27, R30, R37-R39, R45, R48, R51), образуващи общо съпротивление 5Ω, и един кондензатор със стандартна стойност 4,7nF (CK13-CK18). Точните стойности на елементите зависят от паразитните капацитети и индуктивности на печатната платка на устройството. Те се определят и настройват експериментално, като процесът е описан подробно в т. 8.

Използваният в конкретното приложение безчетков мотор е без вградени сензори и за да бъде управляван е необходимо да бъде измерван тока през него. Това става чрез шунтови резистори, свързани между отрицателния общ проводник на полумостовите схеми и масата. В конкретния случай са използвани пет паралелно свързани резистора със стандартна стойност 150mΩ (R58-R62), образуващи общо съпротивление 30mΩ. При пикова консумация IMOT(max) = 10A, загубите във всеки от резисторите ще бъдат около PD(max) = (RSHUNT(tot) . IMOT(max)²) / 5 = 0,6W. В нормален режим консумацията на мотора е IMOT(typ) = PMOT(typ) / UMOT(typ) = 3,75A, а загубите ще бъдат около PD(typ) = (RSHUNT(tot) . IMOT(typ)²) / 5 = 0,08W. Избраните резистори са с максимална разсейвана мощност 1W. Падът на напрежение върху шунтовите резистори се следи от драйвера (блок „Драйвер“) и спрямо него се изчислява консумацията на мотора във всеки един момент.

Поради естеството на схемотехниката за измерване на тока (т.нар. Low-side current sensing), най-отрицателният потенциал за полумостовите схеми е различен от масата на схемата – това е т.нар. променливотокова маса (AC GND). За да се осигури стабилност на този потенциал и да се подобри работата на схемата, към всяка от полумостовите схеми е свързан по още един кондензатор между дрейн терминала на горния (High-side) и сорс терминала на долния (Low-side) транзистор. Неговата стойност e подбрана по такъв начин, че от една страна да ограничи отскоците в променливотоковата маса, но от друга да не попречи на бързодействието на веригата за измерване на тока през мотора. Избрани са кондензатори със стандартна стойност 10nF (CK10-CK12).

На ключови места от схемата на блока са свързани тестови точки (TP7-TP9) с цел лесно измерване на сигналите в реални условия.

## 5.4. Блок „Драйвер“

На фиг. 5.10. е показана принципната електрическа схема на блока.

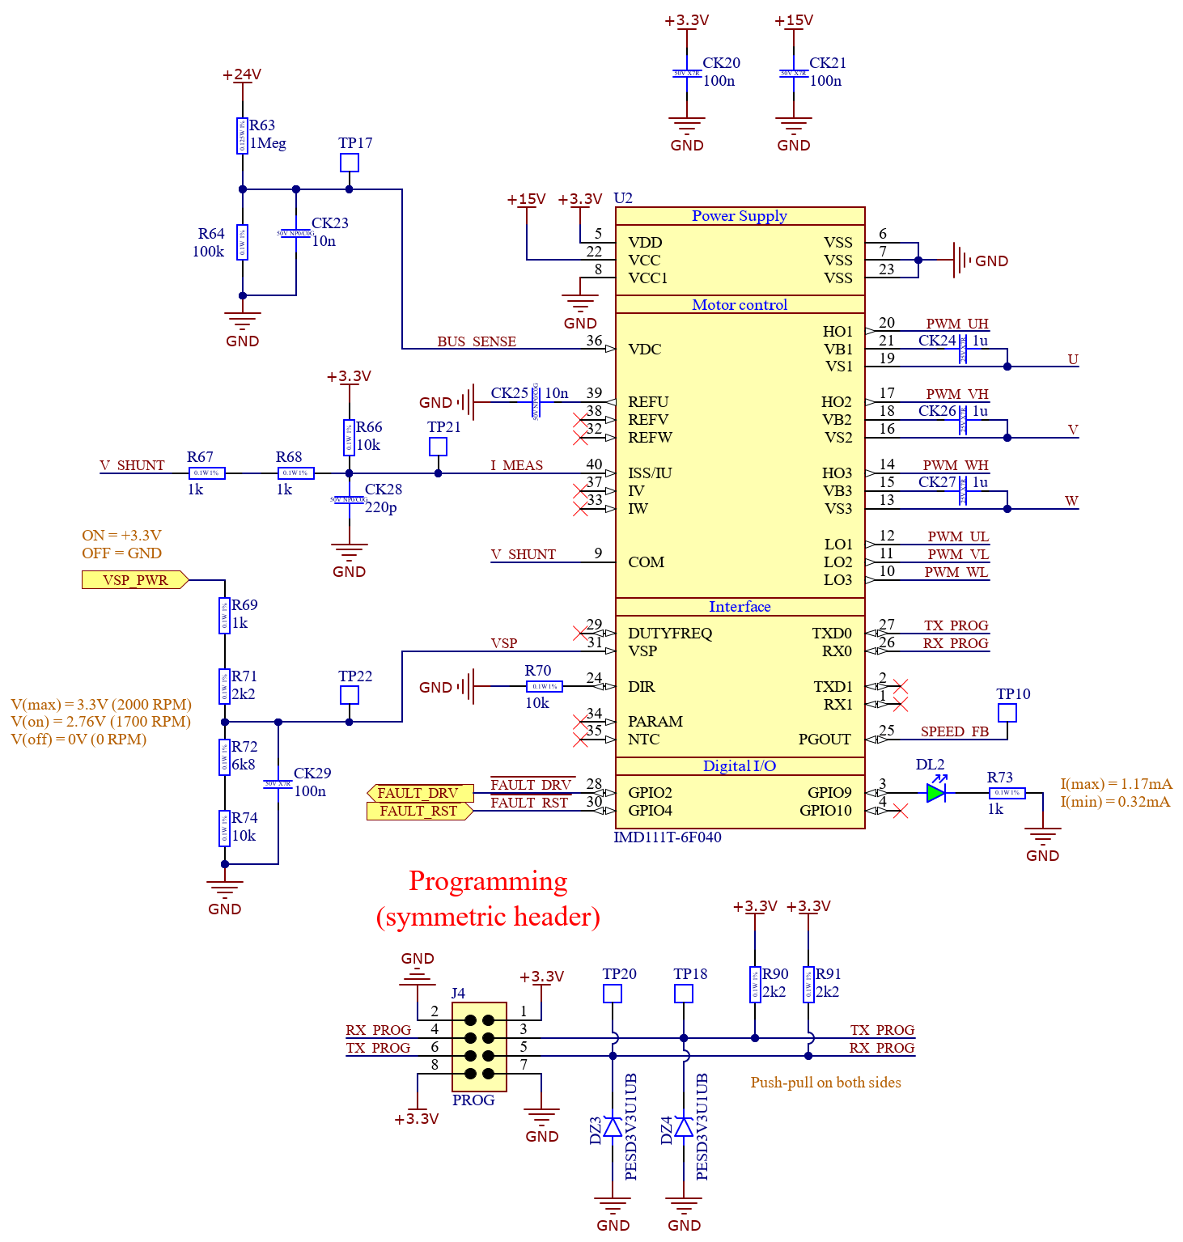
[picture p44: figure]

Фиг. 5.10. Принципна електрическа схема на блок „Драйвер“

В следствие на сравнението, направено в т. 2.3., избраният за устройството интегриран драйвер за управление на безчетков мотор е от вида IMD111T (U2).

Вътрешно, този драйвер се нуждае от две захранващи напрежения – едно за превключване на транзисторите и едно за логическите му функции. Захранването за транзисторите се свързва към извод VCC, като в случая то е с номинална стойност +15V. Драйверът има възможност да работи и само с това външно подадено напрежение, тъй като вътрешно е снабден с понижаващ регулатор на напрежение, който изработва +5V за логическите му функции. В случая обаче този режим на работа не е подходящ, защото логическите схеми, към които устройството ще бъде свързано, работят със захранващо напрежение +3,3V. Драйверът позволява захранващото напрежение за логическата му част да бъде подадено външно, както и то да бъде +3,3V, но при условие че вътрешният регулатор бъде изключен. Това става чрез свързване на извод VCC1 към маса. При това положение, захранващото напрежение за логиката се подава на извод VDD. Към двата захранващи входа с цел премахване на смущения са свързани филтрови кондензатори със стандартна стойност 100nF (CK20 и CK21).

За да се осигури необходимото захранващо напрежение за отпушване на горните транзистори (High-side) във всеки от полумостовете, драйверът разполага с т.нар. Charge Pump схеми. За функционирането им е необходимо свързване на кондензатори между VB и VS изводите за всяка от трите фази. Избрани са кондензатори със стандартна стойност 1μF (CK24, CK26, CK27).

Гейтовете на горните транзистори (High-side) в полумостовите схеми се управляват от изводи HO1-HO3, а гейтовете на долните (Low-side) – от изводи LO1-LO3. Трите фазни напрежения се свързват към изводи VS1-VS3, а най-отрицателният потенциал за полумостовата схема (променливотоковата маса) – към извод COM. Към извод REFU е свързан филтров кондензатор със стандартна стойност 10nF (CK25) по препоръка на производителя.

Драйверът предоставя възможност за следене на захранващото напрежение на управлявания мотор и изработване на грешки при прекомерно ниски или високи стойности. За целта се използва извод VDC, който се следи от вътрешен аналогово-цифров преобразувател (АЦП). Максималното напрежение, което може да бъде измерено от АЦП, зависи от логическото захранване на драйвера – в случая +3,3V. За да може да се осъществи точно измерване, е необходимо входното напрежение на АЦП да бъде съгласувано с обхвата му. Това става чрез резисторен делител, който се изчислява по следния алгоритъм:

U_(ADC_((max))) =3,3V

Избираме U_(MEAS_((max))) =36V

U_(ADC_((max))) =U_(MEAS_((max))) . (R_L)/(R_L +R_U)

Избираме R_L =100kΩ

R_U =R_L . ((U_(MEAS_((max))))/(U_(ADC_((max))))-1)=100kΩ . ((36V)/(3,3V)-1)=991kΩ

Избрани са резистори със стандартни стойности, близки до изчислените – 100kΩ (R64) и 1MΩ (R63).

Паралелно на извод VDC е свързан също кондензатор със стандартна стойност 10nF (CK23). Неговото предназначение е да филтрира кратковременни промени в захранващото напрежение, като по този начин се увеличава устойчивостта на схемата към смущения.

Драйверът предоставя няколко възможности за задаване на скоростта на въртене на мотора – чрез аналогово напрежение, честота, коефициент на запълване или през UART връзка. В конкретния случай скоростта трябва да бъде фиксирана при производството на устройството. Поради тази причина, добър вариант е тя да се задава чрез аналогово напрежение, получено чрез резисторен делител. При този вариант на управление, сигналът трябва да бъде свързан към извод VSP на драйвера. По задание е дадено, че скоростта на мотора трябва да може да се променя в границите от 200 до 2000 RPM, като точната стойност се задава при производството. На фиг. 5.11. е представена графика, която показва как се изчислява скоростта на мотора спрямо подаденото на извод VSP аналогово напрежение.

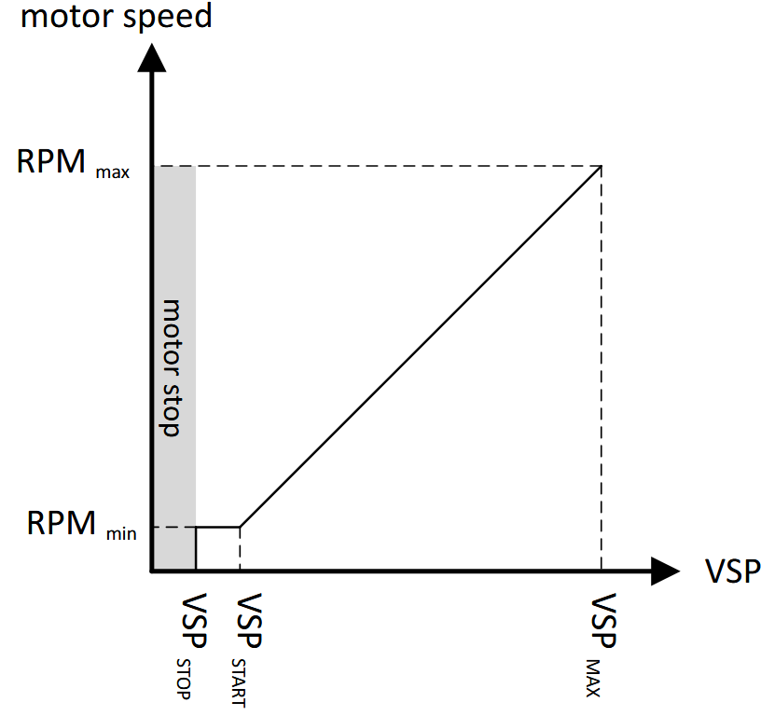
[picture p45: figure]

Фиг. 5.11. Управление на скоростта на мотора с аналогово напрежение

Стойностите на параметрите VSPSTOP, VSPSTART и VSPMAX се задават в конфигурацията на драйвера, като в случая са избрани стойности, съобразени с препоръките на производителя. За първоначалния прототип на устройството, избраната скорост на мотора е 1700RPM. Изчисляването на необходимите резистори за делителя става по следния алгоритъм:

VSP_(STOP) =20% . V_(CC) =0,2 . 3,3V=0,66V

VSP_(START) =24% .V_(CC) =0,24 . 3,3V=0,79V

VSP_(MAX) =96% . V_(CC) =0,96 . 3,3V=3,17V

SPD_(MIN) =200RPM

SPD_(MAX) =2000RPM

SPD_(TRG) =1700RPM

VSP_(TRG) =(SPD_(TARGET) -SPD_(MIN))/(SPD_(MAX) -SPD_(MIN))⋅(VSP_(MAX) -VSP_(START) )+VSP_(START)

VSP_(TRG) =(1700-200)/(2000-200)⋅(3,17V-0,79V)+0,79V=2,77V

VSP_(TRG) =VSP_(PWR) .(R_L)/(R_U +R_L)

Избираме R_L =16,8kΩ

R_U =R_L . ((VSP_(PWR))/(VSP_(TRG))-1)=16,8kΩ . ((3,3V)/(2,77V)-1)=3,21kΩ

Избрани са резистори със стандартни стойности, близки до изчислените – последователно свързани 1kΩ (R69) и 2,2kΩ (R71) за горния резистор (общо 3,2kΩ) и последователно свързани 6,8kΩ (R72) и 10kΩ (R74) за долния резистор (общо 16,8kΩ).

Паралелно на извод VSP е свързан също кондензатор със стандартна стойност 100nF (CK29). Неговото предназначение е да филтрира шумове в захранването на делителя, като по този начин увеличи устойчивостта на схемата към смущения.

Посоката на въртене на мотора се задава чрез извод DIR. В конкретното приложение, единствено положителната посока на въртене е валидна за мотора. За да се програмира тя, изводът DIR се свързва към маса през стандартен издърпващ резистор 10kΩ (R70).

Измерването на тока през мотора става чрез стандартна схема, дадена в документацията на драйвера. В нормален режим, токът през мотора е двупосочен. Тъй като захранването на АЦП в драйвера е еднополярно, за да може да измери пълния обхват от токове е необходимо нулевата му точка да бъде отместена в средата на захранването. Това става чрез резисторен делител, свързан между точката на измерване (напрежението върху шунтовите резистори) и захранването на схемата. Напрежението на измерващия извод ISS на драйвера може също така да бъде усилено вътрешно. Колкото по-голямо е вътрешното усилване на драйвера, толкова по-малки могат да са шунтовите резистори, използвани за измерването. В случая максималното вътрешно усилване, което може да се зададе, така че обхватът на измерването да е достатъчен при нормална работа, е Gint = 3. При това положение, изчисляването на необходимите резистори за делителя става по следния алгоритъм:

U_(ISS_((max))) =(U_(ADC_((max))))/(G_(int))=(3,3)/3=1,1V

Избираме U_(offset) =(U_(ISS_((max))))/2=(1,1V)/2=0,55V

Когато I_(MOT) =0A⇒U_(SHUNT) =0V:

U_(offset) =(R_L)/(R_U +R_L)⋅V_(CC)

Избираме R_U =10kΩ

R_L =(R_U . U_(offset))/(V_(CC) -U_(offset))=(10kΩ . 0,55V)/(3,3V-0,55V)=2kΩ

Избрани са резистори със стандартни стойности, близки до изчислените – 10kΩ (R66) за горния резистор и два последователно свързани резистора по 1kΩ (R67 и R68) за долния резистор (общо 2kΩ). При така подбрани резистори, токовият обхват се изчислява по следния алгоритъм:

U_(shunt) =R_(shunt) . I_(MOT)

U_(ISS) =U_(offset) +U_(shunt) ⋅(R_U)/(R_U +R_L)=U_(offset) +R_(shunt) . I_(MOT) ⋅(R_U)/(R_U +R_L)

I_(MOT_((min))) =(U_(ISS_((min))) -U_(offset))/(R_(shunt) ⋅(R_U)/(R_U +R_L))=(0V-0,55V)/(30mΩ⋅(10kΩ)/(10kΩ+2kΩ))=-22A

I_(MOT_((max))) =(U_(ISS_((max))) -U_(offset))/(R_(shunt) ⋅(R_U)/(R_U +R_L))=(1,1V-0,55V)/(30mΩ⋅(10kΩ)/(10kΩ+2kΩ))=22A

Паралелно на извод ISS е свързан също кондензатор със стандартна стойност 220pF (CK28). Той служи за премахване на високочестотните смущения във веригата за измерване на тока, като по този начин подобрява управлението на мотора.

Драйверът има много развита функционалност по отношение на отчитане на настъпили проблеми с мотора и генериране на грешки за тях. Тези грешки обаче за вътрешни за драйвера и единственият предвиден от производителя начин за прочитането им е чрез UART връзка. Заданието към устройството изисква всички грешки, генерирани от него, да бъдат изведени като външен сигнал (блок „Външни връзки“). По задание се изисква също да има сигнал, чрез който всякакъв вид грешки да могат да бъдат изчистени. За да се постигне тази функционалност, единственият възможен вариант е да се използва предоставения от драйвера „Script Engine”, който позволява изпълнението на прости скриптове. Скриптовете позволяват присвояване на произволни функции на всички свободни входно-изходни изводи на драйвера. В случая е много подходящо да бъде разработен скрипт, който свързва един от изводите (GPIO2) с вътрешно-генерираните грешки. Друг извод (GPIO4) се използва за изчистване на генерираните грешки. Трети извод (GPIO9) се използва за свързване на сервизен зелен светодиод DL2, чрез който да се сигнализира за успешно програмиран драйвер. Стойността на токоограничаващия резистор се изчислява по следния алгоритъм:

Избираме I_(DL2) =0,5mA

R_(lim_(DL2)) =(U_(out_(U2)) -U_(F_(DL2)))/(I_(DL2))=(3V-2,5V)/(0,5mA)=1kΩ

Избран е резистор със стандартна стойност, близка до изчислената –1kΩ (R73).

Програмирането на драйвера става чрез стандартна UART комуникация на изводи TXD0 и RX0.

За свързване на програматор е предвидена рейката J4, която е направена симетрична, така че да позволява свързване на конектора и в двете възможни ориентации. Куплунгът има предвидени изводи за свързване на външно +3,3V захранване, за да се позволи програмиране на драйвера без да се налага включване на основното му +24V захранване. Към комуникационните UART линии са свързани защитни TVS диоди от вида PESD3V3U1UB (DZ3 и DZ4). Към всеки от сигналите е свързан също издърпващ резистор към захранване със стандартна стойност, препоръчана от производителя – 2,2kΩ (R90 и R91).

На ключови места от схемата на блока са свързани тестови точки (TP10, TP17, TP18, TP20-TP22) с цел лесно измерване на сигналите в реални условия.

## 5.5. Блок „Външни връзки“

На фиг. 5.12. е показана принципната електрическа схема на блока.

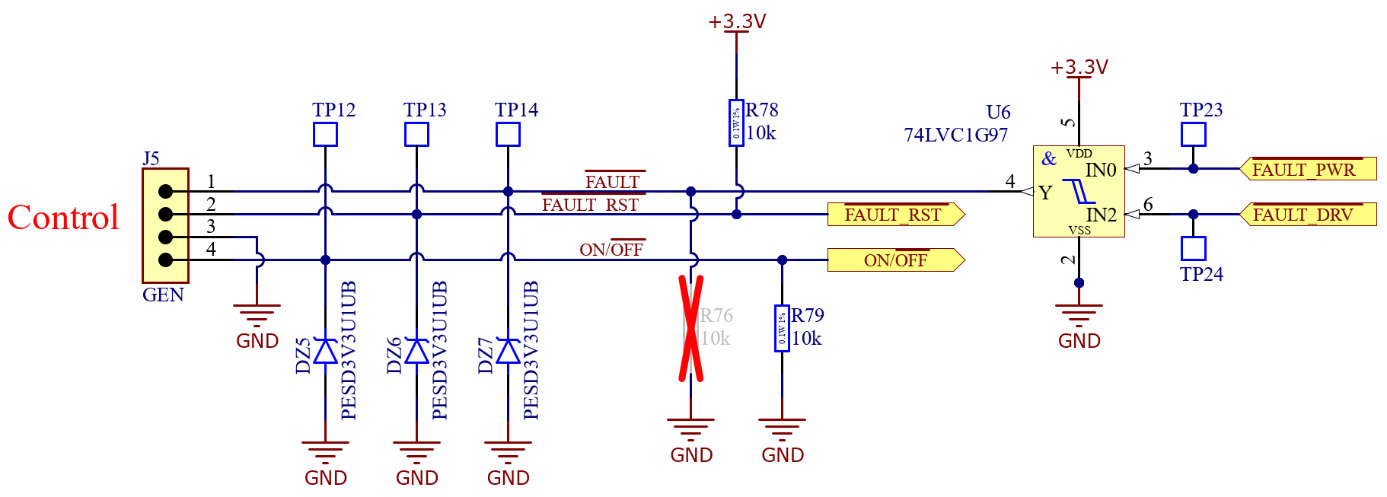
[picture p46: figure]

Фиг. 5.12. Принципна електрическа схема на блок „Външни връзки“

За присъединяване на управляващата устройството платка е предвиден куплунгът J5. Към сигналните линии са свързани защитни TVS диоди от вида PESD3V3U1UB (DZ5-DZ7).

От гледна точка безопасност е важно състоянието на сигналите да бъде строго дефинирано, когато управляващата платка не е включена към устройството. За това се грижат издърпващи резистори със стандартна стойност 10kΩ (R78 и R79). Те гарантират, че при изключено управление, устройството ще отчита команда за спиране на мотора (сигнал ON/O\F\F\ ще бъде в ниско ниво) и няма да отчита команда за изчистване на грешки (сигнал \FAULT_RST ще бъде във високо ниво).

Грешки в схемата се изработват от две независими интегрални схеми – контролера за управление на пусковия ток (блок „Захранване“) и драйвера за управление на безчетковия мотор (блок „Драйвер“). Тъй като изходния сигнал за грешка с устройството е само един, е необходимо грешките от двата модула да бъдат мултиплексирани. Това става чрез мултифункционален логически елемент от вида 74LVC1G97 (U6), изпълняващ функцията логическо И.

На ключови места от схемата на блока са свързани тестови точки (TP12-TP14, TP23, TP24) с цел лесно измерване на сигналите в реални условия.

# 6. Печатна платка

Важен етап от проектирането на устройството е изготвянето на печатна платка, на която да бъде монтирана схемата. Коректно изготвената печатна платка гарантира правилно, надеждно и предвидимо функциониране на устройството и позволява използването му в реални условия. Изготвянето на печатна платка е дълъг процес и затова ще бъдат разгледани само главните съображения, взети под внимание при проектирането, а те са:

- Всички съединители трябва да бъдат поставени на същите места, където се намират в оригиналното управление, за да не се налага преработка на кабелите в системата;
- За да бъде възможно монтиране на платката на мястото на оригиналното управление, монтажните отвори трябва да бъдат разположени на точно определени места;
- Размерите на платката трябва да бъдат максимално близки до тези на оригиналното управление;
- Защитните TVS диоди трябва да бъдат разположени максимално близо до съединителите, за които са предназначени;
- Филтърът на входното +24V захранване трябва да бъде разположен максимално близо до съединителя, където се включва то;
- Под синфазния дросел не трябва да има медни полигони;
- Захранващите писти и медни полигони трябва да бъдат с достатъчно голяма площ, така че да не се нагряват при преминаването на голям ток през тях;
- Филтровите кондензатори трябва да бъдат разположени максимално близо до интегралните схеми, за които са предназначени;
- За линейните регулатори на напрежение трябва да бъдат предвидени охлаждащи медни полигони с достатъчно големи размери;
- Под частта от корпуса на интегралния драйвер, където вътрешно се намира схемотехниката за превключване на мощните транзистори (т.нар. gate driver), не трябва да има медни полигони;
- Под частта от корпуса на интегралния драйвер, където вътрешно се намира схемотехниката за логическите му функции, както и под всички останали логически компоненти в схемата, трябва да има медни полигони за захранване и маса, за да се минимизират излъчваните шумове;
- Под силовата схемотехника не трябва да има медни полигони за захранване и маса, за да не се зашумяват от работата на мотора;
- За да се повиши точността на измерването, шунтовият резистор в захранването трябва да бъде свързан към контролера за управление на пусковия ток чрез т.нар. Келвин връзка (Kelvin connection);
- Контролерът за управление на пусковия ток трябва да бъде разположен максимално близо до шунтовия резистор и превключващия захранването транзистор, за да се повиши точността на измерванията;
- Всички мрежи, през които преминават големите токове за задвижване на мотора, трябва да бъдат изпълнени чрез медни полигони с достатъчно голяма площ, така че да не се нагряват;
- Кръгът, през който преминават големите токове към мотора, трябва да бъде отделен от логическата част на схемата и да бъде с максимално малка площ, за да се минимизират излъчваните шумове;
- Шунтовите резистори, използвани за измерване на тока през мотора, трябва да бъдат монтирани максимално близко един до друг, така че да се нагряват еднакво с цел повишаване на точността на измерването;
- Гасителите (snubbers) трябва да бъдат разположени максимално близо до транзисторите, за които са предназначени;
- Сигналните писти и полигони трябва да се проектират по такъв начин, че да се минимизира паразитната им индуктивност;
- Всички светодиоди трябва да бъдат видими и логично разположени;
- Всички тестови точки трябва да бъдат лесно достижими;
- Компонентите трябва да бъдат разположени по такъв начин, че да се минимизират дължините на връзките между тях, стига описаните по-горе изисквания да са също изпълнени;
- В близост до краищата на платката трябва да бъдат разположени референтни знаци, необходими за автоматичното ѝ асемблиране (т.нар. fiducial marks);
- Добре е всички сигнални писти да бъдат максимално широки;
- За предпочитане е да се използват еднакви проходни отвори с достатъчно голям размер, за да се намали крайната цена на платката;
- По възможност се предпочита всички компоненти да са монтирани от едната страна на платката, което значително улеснява производството и намалява крайната цена;
- По възможност всички елементи е добре да бъдат обозначени в ситопечата;
- По възможност е добре в ситопечата да бъдат добавени описателни имена за светодиодите и съединителите;
- По възможност е добре всички тестови точки да бъдат разположени от страната на платката без компоненти, за да се улесни достъпът до тях в процеса на автоматична верификация.

За проектиране на печатната платка е използван CAD софтуерът Altium Designer. Изработената печатна платка е четирислойна, с едностранно разположение на компонентите. В Приложение 2 са дадени най-важните слоеве на платката – четирите метализационни слоя (горен – Top Layer, вътрешен за маса – GND Layer, вътрешен за захранвания – VCC Layer и долен – Bot Layer), както и ситопечатът от горната страна на платката (Top Silkscreen). В Приложение 3 е даден монтажният чертеж на печатната платка. На фиг. 6.1. и фиг. 6.2. са показани 3D изгледи на горната и долната страна на завършената печатна платка с монтирани елементи.


Фиг. 6.1. 3D изглед на печатната платка – горна страна

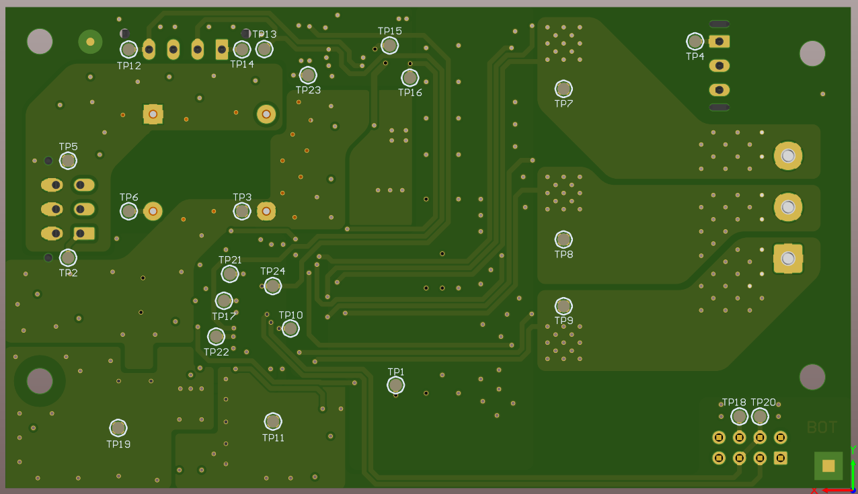
[picture p47: figure]

Фиг. 6.2. 3D изглед на печатната платка – долна страна

# 7. Конфигурация на драйвера

## 7.1. Параметри на мотора

## 7.2. Настройка на управлението

## 7.3. Програмиране на входно-изходните изводи

текст

# 8. Експериментални резултати

текст

# 9. Заключение

текст

# 10. Използвана литература

[1] DC Motors: Types and Uses – IQS Directory (https://www.iqsdirectory.com/articles/electric-motor/dc-motors.html)

[2] Types of Brushless DC Motors – SONTIAN (https://sontianmotor.com/types-of-brushless-dc-motors/)

[3] Brushless DC (BLDC) Motor Fundamentals – Microchip (https://ww1.microchip.com/downloads/aemDocuments/documents/OTH/ApplicationNotes/ApplicationNotes/00885a.pdf)

[4] Brushless-DC Motor Driver Considerations and Selection – TI (https://www.ti.com/lit/an/slvaes1a/slvaes1a.pdf?ts=1740570045722)

[5] MCT8239A – TI (https://www.ti.com/lit/ds/symlink/mct8329a.pdf?ts=1748156902013)

[6] A89306 – Allegro (https://www.allegromicro.com/-/media/files/datasheets/a89306-datasheet.pdf)

[7] STSPIN32G0B1 – STMicroelectronics (https://www.st.com/en/motor-drivers/stspin32g0b1.html)

[8] IMD111T – Infineon (https://www.infineon.com/dgdl/Infineon-IMD110T-DataSheet-v01_01-EN.pdf?fileId=5546d462773f93240177489a1dcf0a7d)

[9] JYQD-V8.3B – Juyi Tech (https://www.bldcmotor-driver.com/sale-11380250-jyqd-v8-3b-sensorless-bldc-motor-driver-pwm-frequency-1-20khz-duty-cycle-0-100.html)

[10] HC100D2 - HCEM (https://www.hcem.cn/product_show.asp?id=262)

[11] Design Considerations for High-Power Motor Driver Applications – TI (https://www.ti.com/lit/an/slvaf66/slvaf66.pdf?ts=1749228985861)

Приложение 1

Принципна електрическа схема

Приложение 2

Печатна платка - слоеве

Приложение 3

Печатна платка - монтажен чертеж
