IliyanAntov/CodeFreeBLDC/Design/Simulations/+15V/ToleranceAnalysis.xlsx

Sheet: Data
Values | Measurement | MC: |  | Values | Measurement | WC:
14.94636364 | vout | sampledev | 0.125 | 14.94636364 | vout | min | 13.94
15.00022771 | vout | meanval | 14.949 | 14.30274109 | vout | nom | 14.95
14.84450722 | vout | trueval | 14.94636364 | 14.30274109 | vout | max | 16.01
15.16548798 | vout |  |  | 15.49365018 | vout
14.80252142 | vout | 6sigma min | 14.19 | 15.49365018 | vout
14.98225956 | vout | nominal | 14.95 | 14.40922909 | vout
14.89884433 | vout | 6sigma max | 15.70 | 14.40922909 | vout
15.09614579 | vout |  |  | 15.60013818 | vout
14.89120546 | vout |  |  | 15.60013818 | vout
15.01684993 | vout |  |  | 14.12199876 | vout
14.96023971 | vout |  |  | 14.12199876 | vout
15.17772861 | vout |  |  | 15.29784599 | vout
14.91593372 | vout |  |  | 15.29784599 | vout
14.80096431 | vout |  |  | 14.22848676 | vout
15.03279845 | vout |  |  | 14.22848676 | vout
14.94677453 | vout |  |  | 15.40433399 | vout
15.03755786 | vout |  |  | 15.40433399 | vout
15.09034958 | vout |  |  | 14.12199876 | vout
14.980315 | vout |  |  | 14.12199876 | vout
15.00101162 | vout |  |  | 15.29784599 | vout
14.88871591 | vout |  |  | 15.29784599 | vout
14.93243502 | vout |  |  | 14.22848676 | vout
14.98205225 | vout |  |  | 14.22848676 | vout
14.7441928 | vout |  |  | 15.40433399 | vout
15.00925565 | vout |  |  | 15.40433399 | vout
14.93330224 | vout |  |  | 13.94125642 | vout
15.11649015 | vout |  |  | 13.94125642 | vout
14.98739215 | vout |  |  | 15.10204179 | vout
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
14.95995579 | vout
14.86589901 | vout
14.77350057 | vout
14.81419569 | vout
14.89339037 | vout
14.6690515 | vout
15.03161084 | vout
14.88242991 | vout
14.94542641 | vout
14.83620667 | vout
15.09591258 | vout
14.76134667 | vout
14.94204435 | vout
14.88282085 | vout
14.77084668 | vout

Sheet: Sources
WC analysis link: | C:\Users\AntovI\Desktop\Projects\702\702-pumpcontrol102\Simulations\+15V\15V_WC.log
MC analysis link: | C:\Users\AntovI\Desktop\Projects\702\702-pumpcontrol102\Simulations\+15V\15V_MC.log
