IliyanAntov/CodeFreeBLDC/Design/Simulations/+3.3V/ToleranceAnalysis.xlsx

Sheet: Data
Values | Measurement | MC: |  | Values | Measurement | WC:
3.32075 | vout | sampledev | 0.027 | 3.32075 | vout | min | 3.13
3.331635346 | vout | meanval | 3.321 | 3.1816269 | vout | nom | 3.32
3.298983757 | vout | trueval | 3.321 | 3.1816269 | vout | max | 3.52
3.363886798 | vout |  |  | 3.4466269 | vout
3.296566825 | vout | 6sigma min | 3.16 | 3.4466269 | vout
3.320804327 | vout | nominal | 3.32 | 3.196269 | vout
3.312432292 | vout | 6sigma max | 3.48 | 3.196269 | vout
3.356264879 | vout |  |  | 3.461269 | vout
3.322330325 | vout |  |  | 3.461269 | vout
3.332841538 | vout |  |  | 3.126952344 | vout
3.310101795 | vout |  |  | 3.126952344 | vout
3.364901142 | vout |  |  | 3.387396131 | vout
3.306490948 | vout |  |  | 3.387396131 | vout
3.285837019 | vout |  |  | 3.141594444 | vout
3.342007179 | vout |  |  | 3.141594444 | vout
3.316695635 | vout |  |  | 3.402038231 | vout
3.355275505 | vout |  |  | 3.402038231 | vout
3.369576128 | vout |  |  | 3.209369677 | vout
3.313227969 | vout |  |  | 3.209369677 | vout
3.335593376 | vout |  |  | 3.476679677 | vout
3.307950185 | vout |  |  | 3.476679677 | vout
3.318574631 | vout |  |  | 3.224216766 | vout
3.334637173 | vout |  |  | 3.224216766 | vout
3.281780345 | vout |  |  | 3.491526766 | vout
3.33720871 | vout |  |  | 3.491526766 | vout
3.318577866 | vout |  |  | 3.153929677 | vout
3.349476094 | vout |  |  | 3.153929677 | vout
3.335680255 | vout |  |  | 3.416619677 | vout
3.329714765 | vout |  |  | 3.416619677 | vout
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
3.333067897 | vout
3.307564732 | vout
3.288996065 | vout
3.282313089 | vout
3.305561862 | vout
3.263766564 | vout
3.339169941 | vout
3.310459532 | vout
3.326739359 | vout
3.308185333 | vout
3.349836642 | vout
3.277792419 | vout
3.319577314 | vout
3.305378255 | vout
3.290151671 | vout

Sheet: Sources
WC analysis link: | C:\Users\AntovI\Desktop\Projects\702\702-pumpcontrol102\Simulations\+3.3V\3V3_WC.log
MC analysis link: | C:\Users\AntovI\Desktop\Projects\702\702-pumpcontrol102\Simulations\+3.3V\3V3_MC.log
