IliyanAntov/CodeFreeBLDC/Design/Schematic/2_ProjectInfo.png

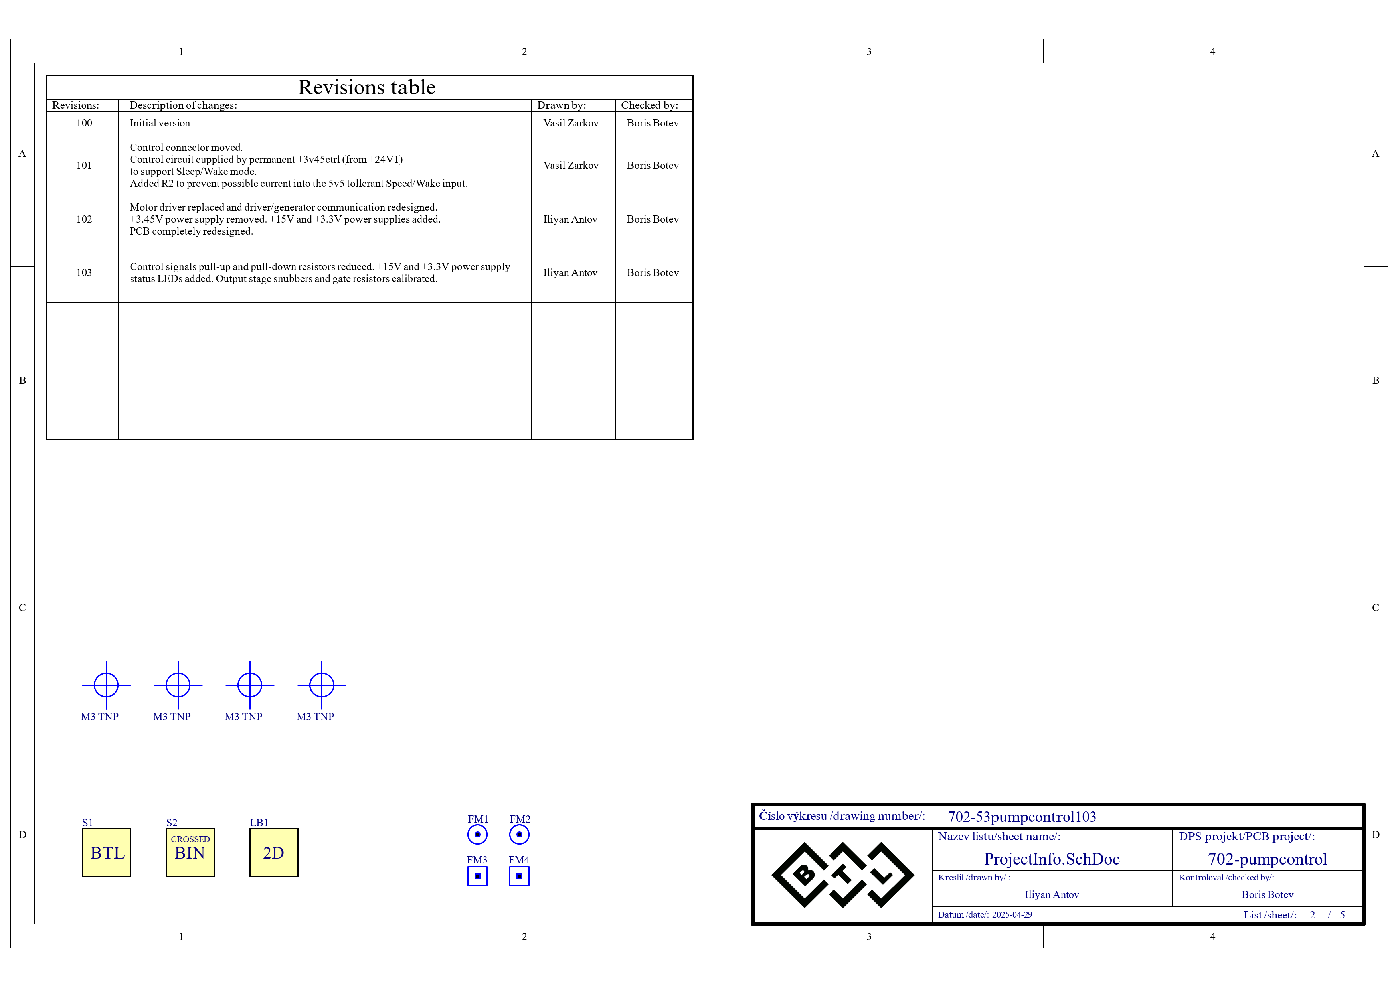
Design/Schematic/2_ProjectInfo.png
