IliyanAntov/CodeFreeBLDC/Documentation/Images/Driver configuration/Config Wizard/1_IC Configuration.png

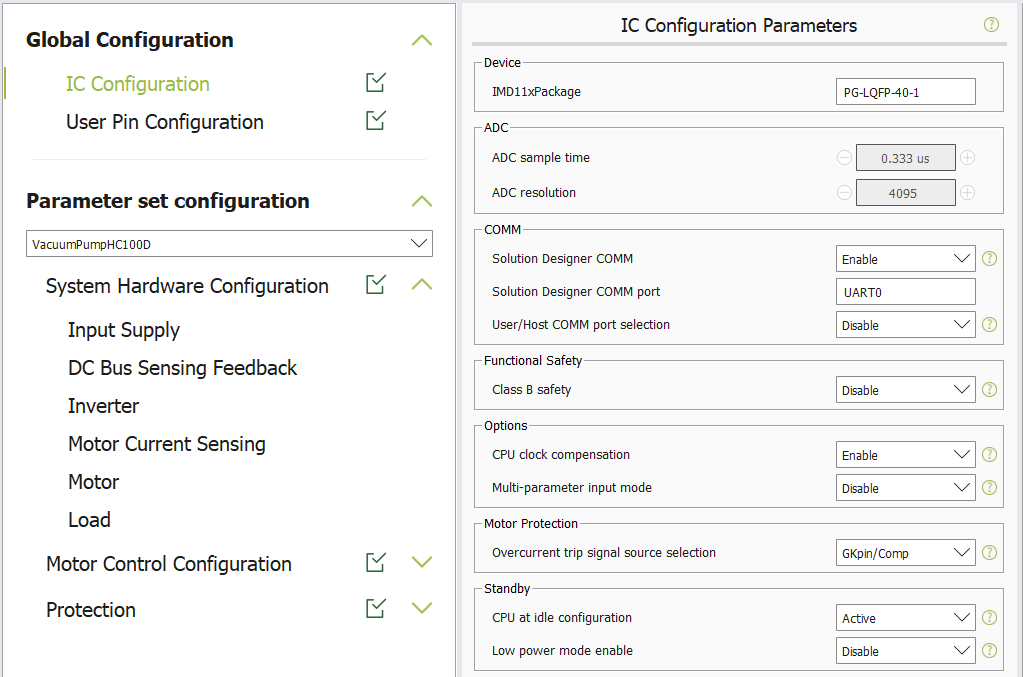
Documentation/Images/Driver configuration/Config Wizard/1_IC Configuration.png
