IliyanAntov/CodeFreeBLDC/Documentation/Images/Driver configuration/Config Wizard/2_User Pin Configuration.png

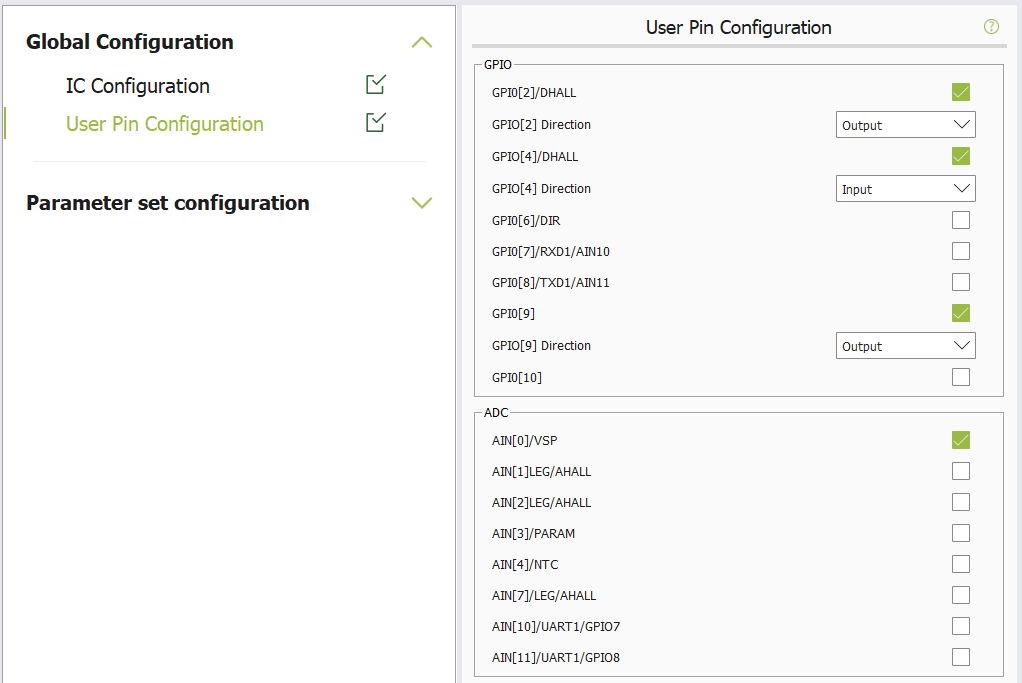
Documentation/Images/Driver configuration/Config Wizard/2_User Pin Configuration.png
