IliyanAntov/CodeFreeBLDC/Documentation/Images/Driver configuration/Config Wizard/3_Input Supply.png

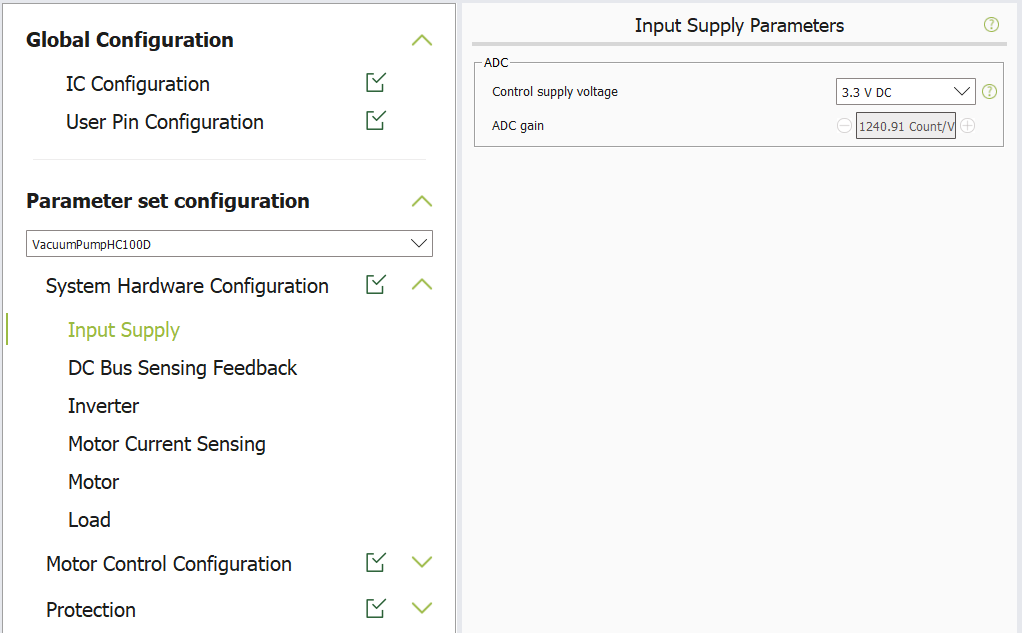
Documentation/Images/Driver configuration/Config Wizard/3_Input Supply.png
