IliyanAntov/CodeFreeBLDC/Documentation/Images/Driver configuration/Config Wizard/4_DC Bus Sensing Feedback.png

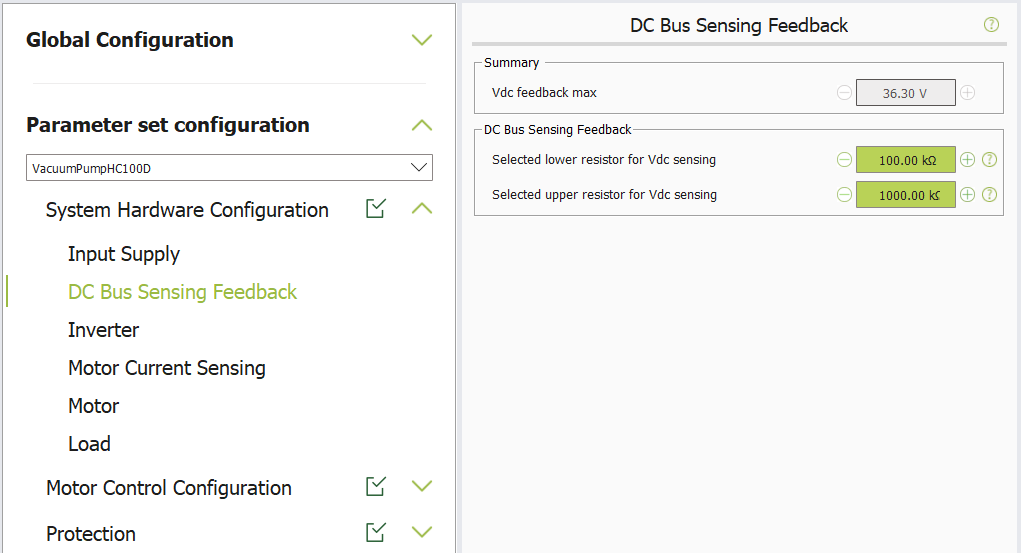
Documentation/Images/Driver configuration/Config Wizard/4_DC Bus Sensing Feedback.png
