IliyanAntov/CodeFreeBLDC/Documentation/Images/Driver configuration/Config Wizard/5_Inverter.png

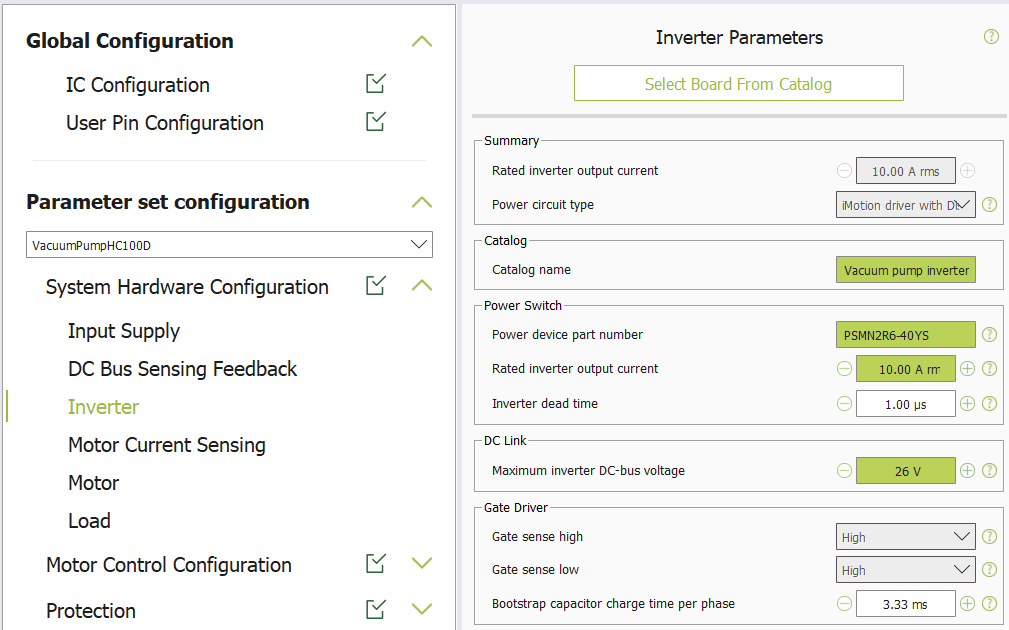
Documentation/Images/Driver configuration/Config Wizard/5_Inverter.png
