IliyanAntov/CodeFreeBLDC/Documentation/Images/Driver configuration/Config Wizard/6_Motor Current Sensing.png

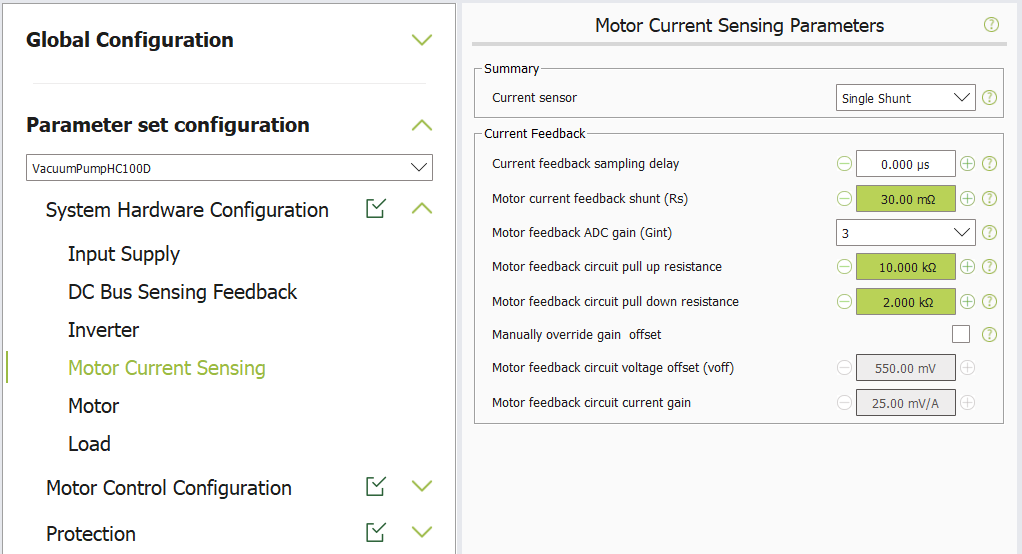
Documentation/Images/Driver configuration/Config Wizard/6_Motor Current Sensing.png
