IliyanAntov/CodeFreeBLDC/Documentation/Images/Driver configuration/Config Wizard/7_Motor.png

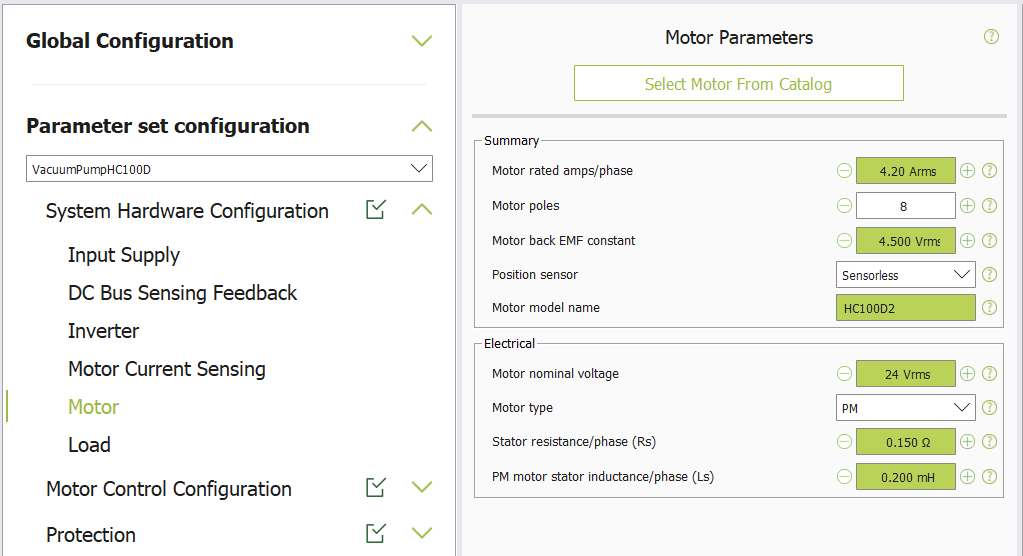
Documentation/Images/Driver configuration/Config Wizard/7_Motor.png
