IliyanAntov/CodeFreeBLDC/Documentation/Images/Driver configuration/Config Wizard/8_Load.png

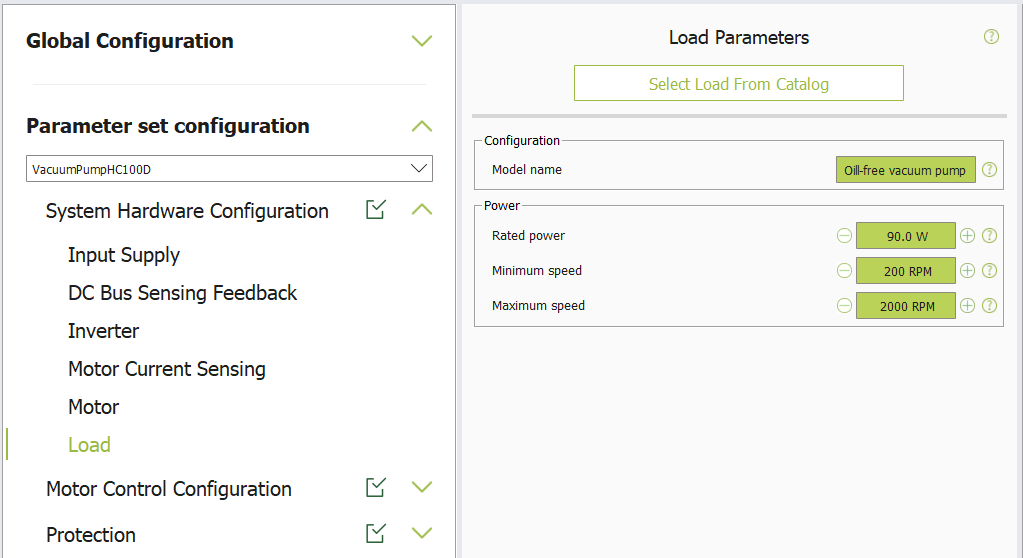
Documentation/Images/Driver configuration/Config Wizard/8_Load.png
