IliyanAntov/CodeFreeBLDC/Documentation/Images/Driver configuration/Config Wizard/9_Motor Control Configuration.png

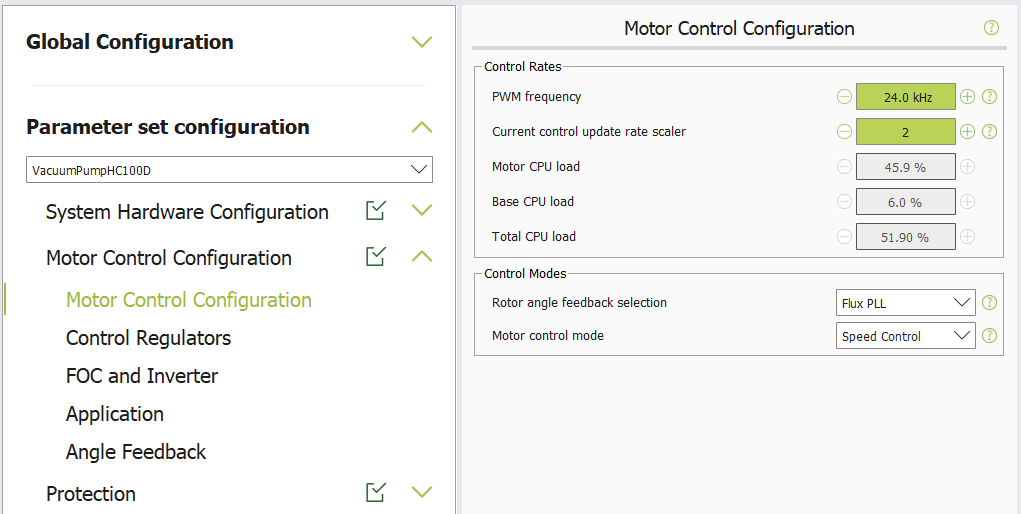
Documentation/Images/Driver configuration/Config Wizard/9_Motor Control Configuration.png
