IliyanAntov/CodeFreeBLDC/Documentation/Images/Driver configuration/Config Wizard/10_Control Regulators.png

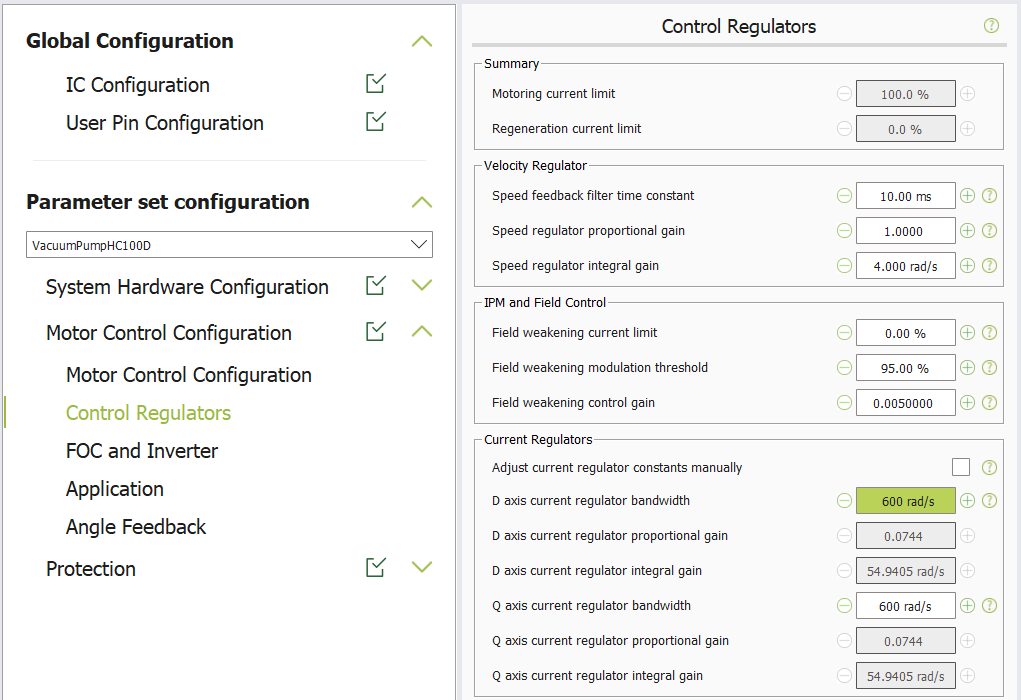
Documentation/Images/Driver configuration/Config Wizard/10_Control Regulators.png
