IliyanAntov/CodeFreeBLDC/Documentation/Images/Driver configuration/Config Wizard/11_FOC and Inverter.png

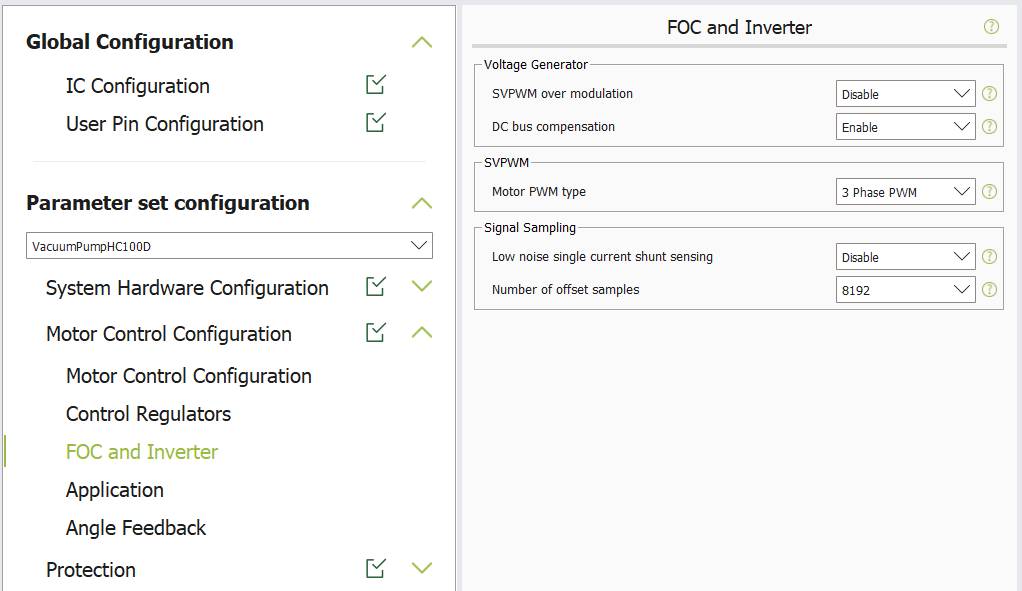
Documentation/Images/Driver configuration/Config Wizard/11_FOC and Inverter.png
