IliyanAntov/CodeFreeBLDC/Documentation/Images/Driver configuration/Config Wizard/12_Application.png

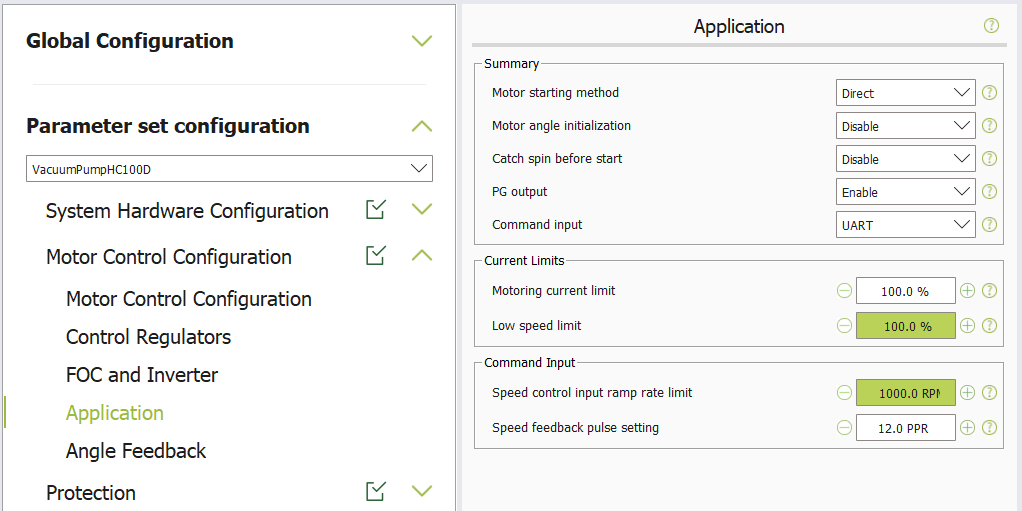
Documentation/Images/Driver configuration/Config Wizard/12_Application.png
