IliyanAntov/CodeFreeBLDC/Documentation/Images/Driver configuration/Config Wizard/13_Angle Feedback.png

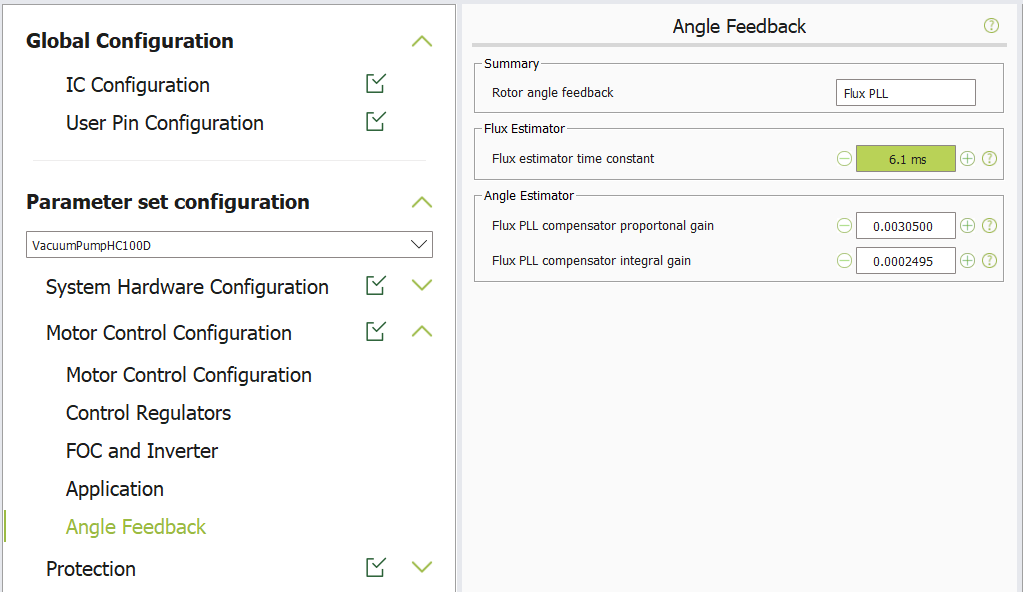
Documentation/Images/Driver configuration/Config Wizard/13_Angle Feedback.png
