IliyanAntov/CodeFreeBLDC/Documentation/Images/Driver configuration/Config Wizard/14_Motor Protection.png

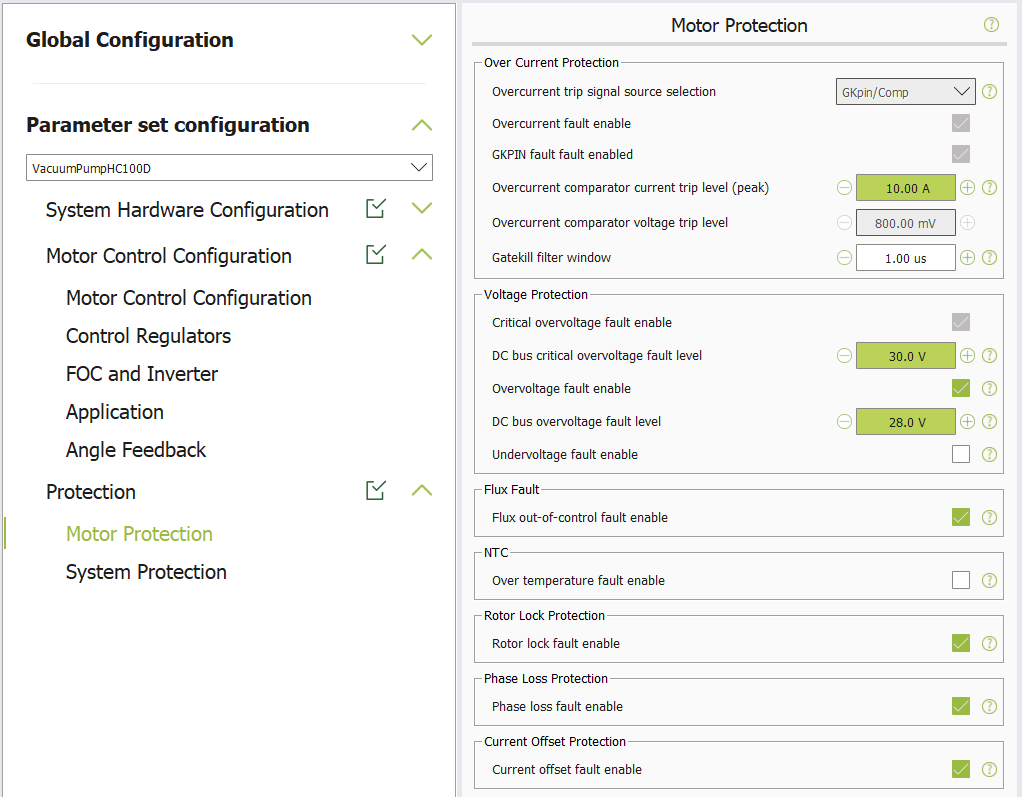
Documentation/Images/Driver configuration/Config Wizard/14_Motor Protection.png
