IliyanAntov/CodeFreeBLDC/Documentation/Images/Driver configuration/Config Wizard/15_System Protection.png

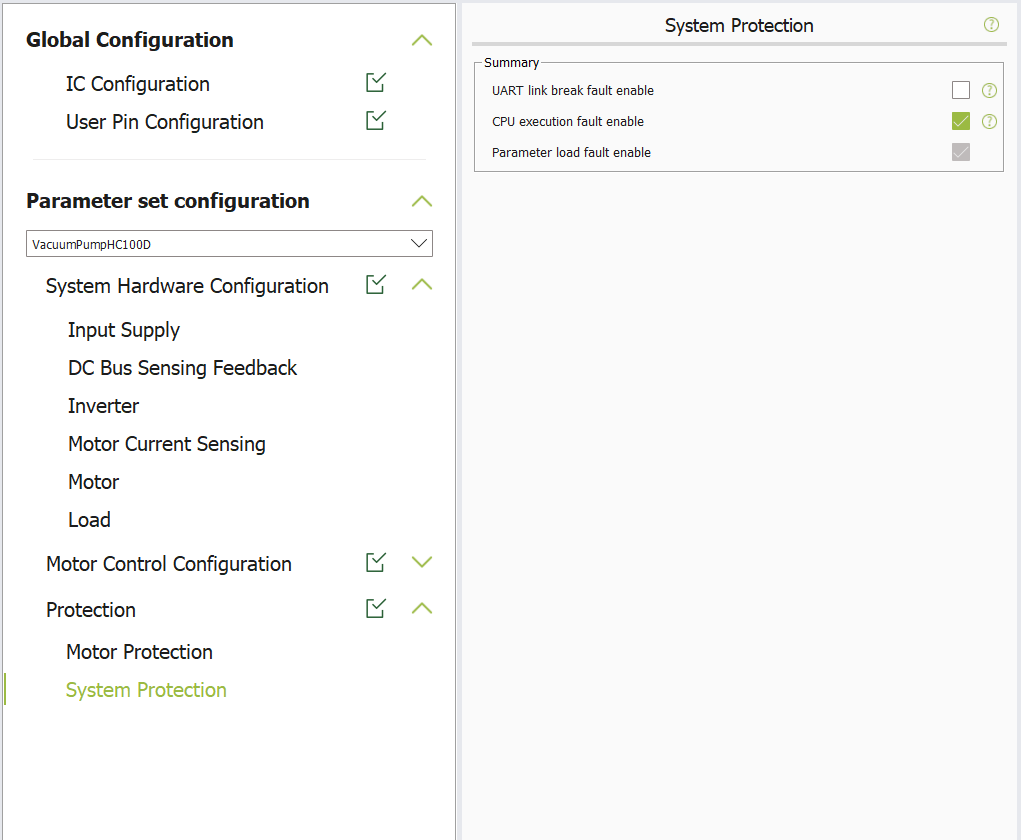
Documentation/Images/Driver configuration/Config Wizard/15_System Protection.png
