IliyanAntov/CodeFreeBLDC/Documentation/Images/Driver configuration/Motor parameters/1_Poles.jpg

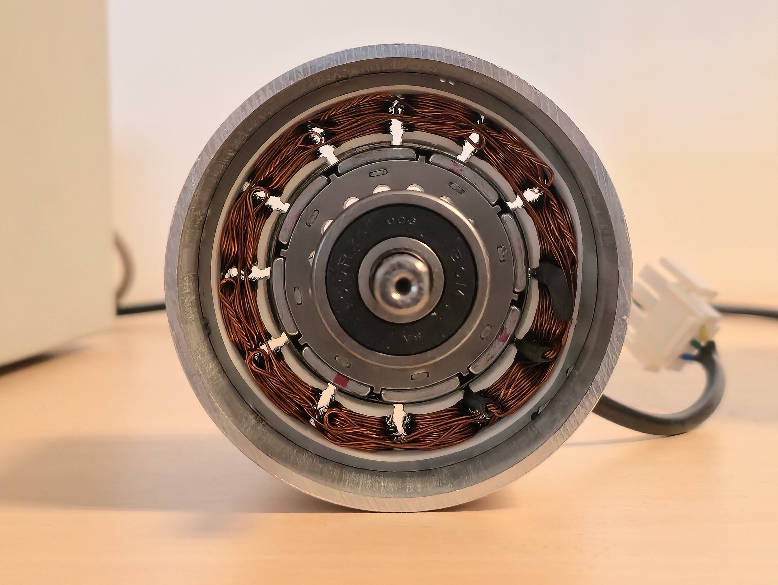
Documentation/Images/Driver configuration/Motor parameters/1_Poles.jpg
