IliyanAntov/CodeFreeBLDC/Documentation/Images/Driver configuration/Motor parameters/2_RL.jpg

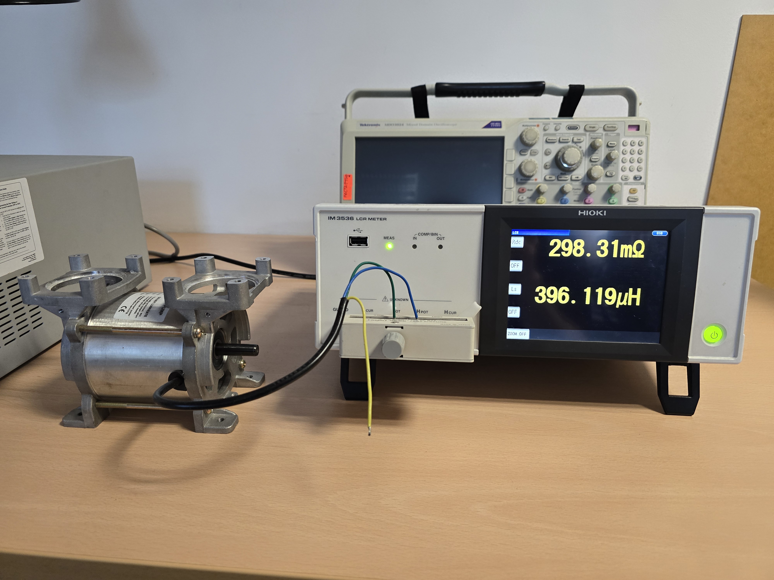
Documentation/Images/Driver configuration/Motor parameters/2_RL.jpg
