IliyanAntov/CodeFreeBLDC/Documentation/Images/Driver configuration/Scripts/BLDC_driver_scripts.png

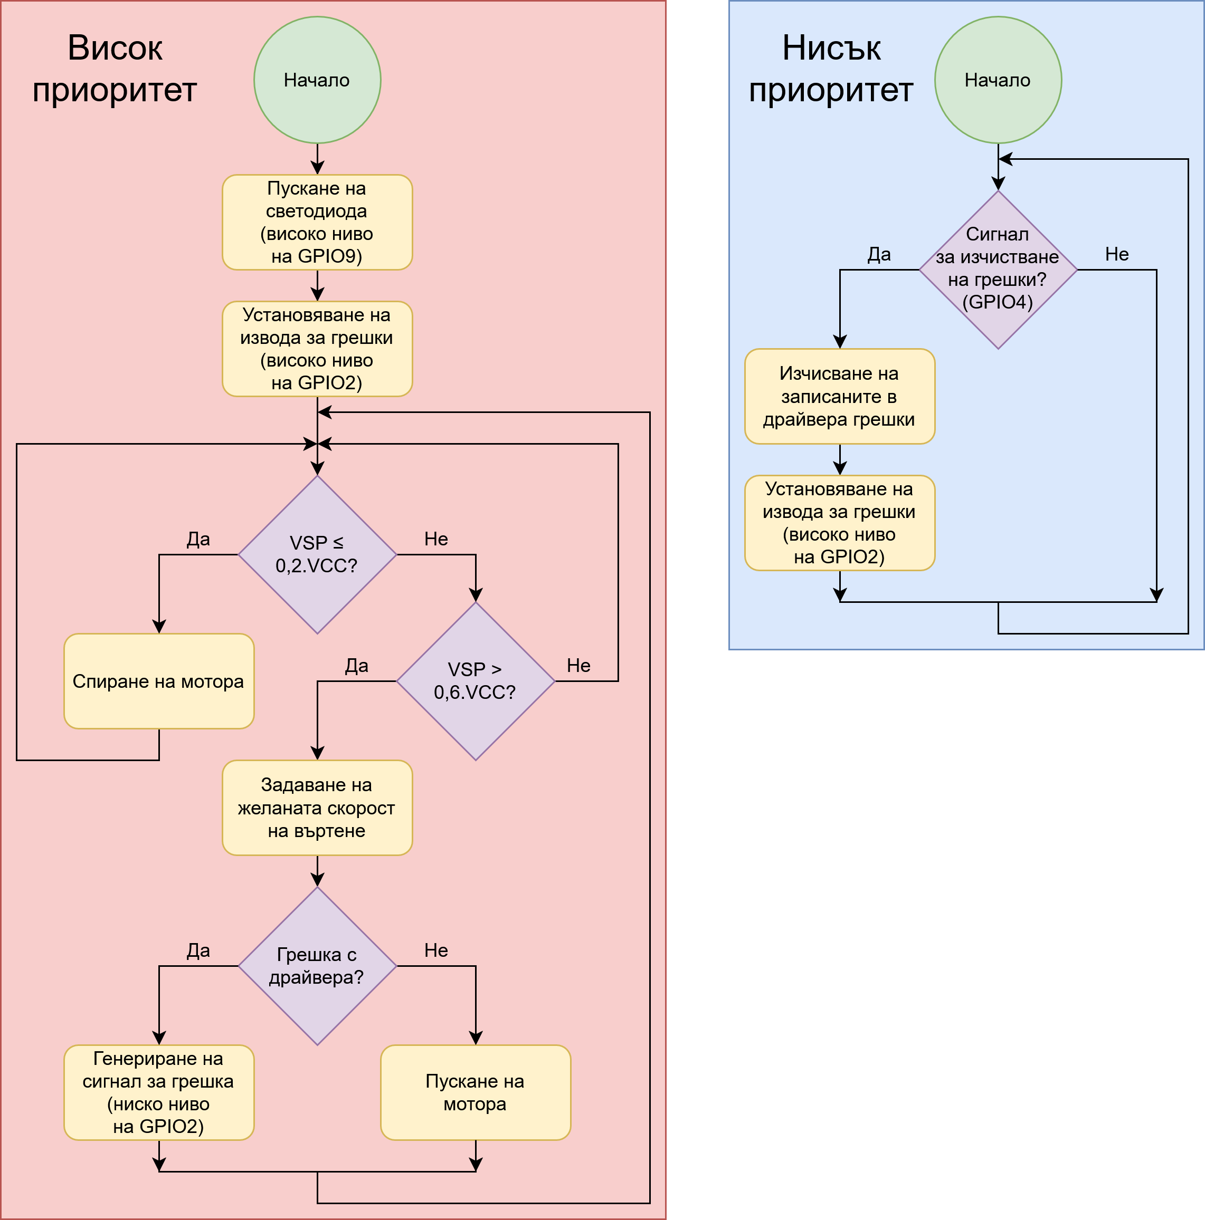
Documentation/Images/Driver configuration/Scripts/BLDC_driver_scripts.png
