IliyanAntov/CodeFreeBLDC/Design/Design report - calculations.xlsx

Sheet: Voltage-Speed conversion
 | Min | Nom | Max | Percentages
ADC voltage [V] | 3.22 | 3.29 | 3.37 | Stop | Start | Max | Resistor tolerance [%]
Speed [RPM] | 200 | 1700 | 2000 | 20% | 24% | 96% | 1
Vdiv_target [V] | 0.79 | 2.77 | 3.16
Rupper [kΩ] | 3.17 | 3.20 | 3.23 | text | Editable
Rlower [kΩ] | 16.63 | 16.80 | 16.97 | text | Non-editable
VSP [V] | 2.70 | 2.77 | 2.84 |  | Target
 |  |  |  |  | Parameter
 |  |  |  |  | Output
 |  |  |  |  | Temperature

Sheet: Bus sense
 | Min | Nom | Max
VDC [V] | 22 | 24 | 26 | text | Editable | Resistor tolerance [%]
Rupper [kΩ] | 990 | 1000 | 1010 | text | Non-editable | 1
Rlower [kΩ] | 99 | 100 | 101 |  | Target
BUS_SENSE [V] | 1.96 | 2.18 | 2.41 |  | Parameter
 |  |  |  |  | Output
 |  |  |  |  | Temperature

Sheet: +15V power supply LM317
 | Min | Nom | Max | IC | Tja [K/W] | Tamb [°C] | Resistor tolerance [%]
Vin [V] | 22 | 24 | 26 | LM317 | 50 | 40 | 1
Vout_target [V] | 15 | 15 | 15
I(3.3V+reg) [mA] | 11.88 | 27.50 | 38.13 | text | Editable
I(15V) [mA] | 0.00 | 9.81 | 16.62 | text | Non-editable
Iload [mA] | 11.88 | 37.31 | 54.75 |  | Target
 |  |  |  |  | Parameter
Vref [V] | 1.2 | 1.25 | 1.3 |  | Output
Iadj [uA] | 10 | 50 | 100 |  | Temperature
Ir1_target [mA] | 10 | 10 | 10
R1_target [Ω] | 120 | 125 | 130
R1[Ω] | 108.9 | 110 | 111.1
R2_target [Ω] | 1138.104646 | 1204.699323 | 1276.468203
R2 [Ω] | 1188 | 1200 | 1212
Vout [V] | 14.04 | 14.95 | 15.89
Ir1 [mA] | 10.80 | 11.36 | 11.94
Pr1 [mW] | 12.7046368 | 14.20454545 | 15.83233622
Pr2 [mW] | 133.992081 | 156.325314 | 181.6346674
Ireg [mA] | 22.68 | 48.67 | 66.69
Udrop [V] | 6.11 | 9.05 | 11.96
Preg [W] | 0.14 | 0.44 | 0.80
Treg [°C] | 46.93 | 62.03 | 79.87

Sheet: +3.3V power supply LM317
 | Min | Nom | Max | IC | Tja [K/W] | Tamb [°C] | Resistor tolerance [%]
Vin [V] | 14.04 | 14.95 | 15.89 | LM317 | 50 | 40 | 1
Vout_target [V] | 3.3 | 3.3 | 3.3
I(3.3V) [mA] | 0.00 | 15.00 | 25.00 | text | Editable
Iload [mA] | 0.00 | 15.00 | 25.00 | text | Non-editable
 |  |  |  |  | Target
Vref [V] | 1.2 | 1.25 | 1.3 |  | Parameter
Iadj [uA] | 10 | 50 | 100 |  | Output
Ir1_target [mA] | 10 | 10 | 10 |  | Temperature
R1_target [Ω] | 120 | 125 | 130
R1[Ω] | 99 | 100 | 101
R2_target [Ω] | 151.1565768 | 163.3466135 | 176.6013605
R2 [Ω] | 163.35 | 165 | 166.65
Vout [V] | 3.14 | 3.32 | 3.50
Ir1 [mA] | 11.88 | 12.50 | 13.13
Pr1 [mW] | 13.97510048 | 15.625 | 17.41556984
Pr2 [mW] | 20.36922901 | 25.9879125 | 32.52535853
Ireg [mA] | 11.88 | 27.50 | 38.13
Udrop [V] | 10.54 | 11.63 | 12.75
Preg [W] | 0.13 | 0.32 | 0.49
Treg [°C] | 46.26 | 55.99 | 64.30

Sheet: Temperatures
 | Min | Nom | Max | Tamb [°C] | Resistor tolerance [%]
Inverter shunt resistors (5x): |  |  |  | 40 | 1%
R [Ω] | 0.148 | 0.150 | 0.151
I [A] | 4 | 4.17 | 10
Cu area [mm^2] | - | 1000 | -
Cu area [in^2] | - | 1.55 | -
Rth(polygon) [°C in^2/W] | - | 125 | -
Ptransistor[W] | 0.095 | 0.104 | 0.606
Tboard[°C] | 47.66 | 48.41 | 88.87
Inverter transistors (6x):
Rdson [mΩ] | - | 2 | 3.7
I [A] | 4 | 4.17 | 10
Rth(j-mb) [°C/W] | - | 0.5 | 1.15
Cu area [mm^2] | - | 1000 | -
Cu area [in^2] | - | 1.55 | -
Ptransistor[W] | - | 0.035 | 0.370
Tboard[°C] | - | 42.82 | 70.26
24V power transistor:
Rdson [mΩ] | - | 2 | 3.7
I [A] | 4 | 4.17 | 10
Rth(j-mb) [°C/W] | - | 0.5 | 1.15
Cu area [mm^2] | - | 900 | -
Cu area [in^2] | - | 1.40 | -
Ptransistor[W] | - | 0.035 | 0.370
Tboard[°C] | - | 43.16 | 73.58
24V power shunt resistor:
R [Ω] | 0.005 | 0.005 | 0.005
I [A] | 4 | 4.17 | 10
Cu area [mm^2] | - | 550 | -
Cu area [in^2] | - | 0.85 | -
Ptransistor[W] | 0.079 | 0.087 | 0.505
Tboard[°C] | 51.61 | 52.75 | 114.05
Ptot [W] |  | 1.612

Sheet: Motor BEMF calculation
Description | Designator | Unit | Value
Number of poles | p | - | 8
Peak line-to-line voltage | Epk | [V] | 3.12 | 4.16 | 4.96 | 6 | 7.04 | 8 | 5.2
Electrical angle period of time | Telec | [ms] | 61.82 | 42.08 | 33.58 | 27.24 | 23.43 | 20.84 | 31.49
 |  |  |  |  |  |  |  |  |  | Avergage:
Back EMF constant | Ke | [Vrmp/kRPM] | 5.25 | 4.76 | 4.53 | 4.45 | 4.49 | 4.54 | 4.46 | 4.67

Sheet: (old) +15V power supply TL431
 | Min | Nom | Max | IC | Tja [K/W] | Tamb [°C] | Resistor tolerance [%]
Vin [V] | 22 | 24 | 26 | TL431CDR | 97 | 40 | 1
Vout_target [V] | 15 | 15 | 15
Iload [mA] | 0.00 | 10.00 | 16.62 | text | Editable
Iout_target [mA] | 0.00 | 10.00 | 16.62 | text | Non-editable
 |  |  |  |  | Target
Vref [V] | 2.44 | 2.495 | 2.55 |  | Parameter
Iref [uA] | 1 | 2 | 4 |  | Output
Idiv_target [mA] | 0.1 | 0.5 | 1 |  | Temperature
R2_target [kΩ] | 24.4 | 4.99 | 2.55
R2 [kΩ] | 4.65 | 4.7 | 4.75
R1_target [kΩ] | 22.72 | 23.56 | 24.44
R1 [kΩ] | 23.27 | 23.5 | 23.73
Vout [V] | 14.42 | 15.02 | 15.65
Idiv [mA] | 0.506 | 0.533 | 0.561
Udrop [V] | 6.35 | 9 | 11.58
Rsup_target [Ω] | 381.92 | 900.00 | ∞
Rsup[Ω] | 386.1 | 390 | 393.9
Ires [mA] | 16.11 | 23.08 | 29.99
Pres [W] | 0.10 | 0.21 | 0.35
Iout [mA] | 15.55 | 22.54 | 29.48
Preg [W] | 0.00 | 0.19 | 0.46
Treg [°C] | 40.00 | 58.27 | 84.76

Sheet: (old) +3.3V power supply TL431
 | Min | Nom | Max | IC | Tja [K/W] | Tamb [°C] | Resistor tolerance [%]
Vin [V] | 22 | 24 | 26 | TL431CDR | 97 | 40 | 1
Vout_target [V] | 3.3 | 3.3 | 3.3
Iload [mA] | 0.00 | 15.00 | 25.00 | text | Editable
Iout_target [mA] | 0.00 | 15.00 | 25.00 | text | Non-editable
 |  |  |  |  | Target
Vref [V] | 2.44 | 2.495 | 2.55 |  | Parameter
Iref [uA] | - | 2 | 4 |  | Output
Idiv_target [mA] | 0.1 | 0.5 | 1 |  | Temperature
R2_target [kΩ] | 24.4 | 4.99 | 2.55
R2 [kΩ] | 4.65 | 4.7 | 4.75
R1_target [kΩ] | 1.37 | 1.52 | 1.67
R1 [kΩ] | 1.49 | 1.5 | 1.51
Vout [V] | 3.22 | 3.29 | 3.37
Idiv [mA] | 0.514 | 0.531 | 0.549
Udrop [V] | 18.63 | 20.7 | 22.78
Rsup_target [Ω] | 677.46 | 1380.00 | ∞
Rsup[Ω] | 495 | 500 | 505
Ires [mA] | 36.89 | 41.40 | 46.02
Pres [W] | 0.67 | 0.86 | 1.07
Iout [mA] | 36.34 | 40.87 | 45.50
Preg [W] | 0.04 | 0.09 | 0.15
Treg [°C] | 43.54 | 48.27 | 54.87

Sheet: (old) NTC temperature
 | Min | Nom | Max
k | - | 1.29 | -
n | - | -1.34 | -
Istdy [A] | 4 | 4.17 | 4.5
δntc [mW/°C] | - | 24 | -
Rntc [Ω] | 0.201 | 0.190 | 0.172
Pntc [W] | 3.221 | 3.310 | 3.481
Tntc [°C] | 134.20 | 137.93 | 145.04
