IliyanAntov/CodeFreeBLDC/Design/Testing/702-pumpcontrol102_Test_Report.pdf

BTL Industries JSC | 702 – Skincare | RELEASE
702-51pumpcontrol102 Test report | | Page 1 of 17

## Test report

PROJECT NAME: 702 – Skincare
FILE NAME: 702-51gener104 Test plan | RELEASE
Rev. | Date | Description | Author
01 | 06.11.2024 | Document created by | AntovI
01 | | Reviewed and validated by

## Table of Contents

## Table of Figures

Figure 1. Pictures of 200182100126 - top and bottom sides | 5
Figure 2. Pictures of 200182100128 (reworked) - top and bottom sides | 6
Figure 4. Power test setup | 7
Figure 5. T1 power-on transient - 200182100126 | 8
Figure 6. T1 power-on transient - 200182100128 (reworked) | 8
Figure 8. Driver test setup | 9
Figure 9. PWM at SPEED_FB - 200182100126 | 10
Figure 10. PWM at SPEED_FB – 200182100128 (reworked) | 10
Figure 12. Voltage waveforms at U, V, W - 200182100126 | 11
Figure 13. Voltage waveforms at U, V, W - 200182100128 (reworked) | 11
Figure 16. Current waveforms at U, V, W - 200182100126 | 12
Figure 16. Current waveforms at U, V, W - 200182100128 (reworked) | 13
Figure 18. Control test setup | 14
Figure 19. Temperature measurements test setup | 15
Figure 20. Temperature measurements - 200182100126 | 16
Figure 21. Temperature measurements - 200182100128 (reworked) | 17
Table 1. Visual inspection results | 4
Table 2. Power measurements | 7
Table 3. Driver measurements | 9
Table 4. Control measurements | 14

## 1. Scope

The purpose of this document is to present the results from the experiments done while testing the device’s functionality.

## 2. References

- Pumpcontrol102 Test Plan – 702-pumpcontrol102_Test_Plan.docx

## 3. Equipment

- Oscilloscope – Tektronix MDO3024;
- Multimeter – Fluke 87V;
- IR imager – Agilent U5855A;
- DC power supply – Keysight U8031A.

## 4. Test conditions

The test conditions are valid for all tests unless otherwise specified.

- Ambient temperature - 23°C ±3°C
- Relative humidity - 30÷60 %
- Atmospheric pressure - 700÷1060 hPa

## 5. Visual inspection

Table 1. Visual inspection results
Serial number | 200182100126 | 200182100128 (reworked)
Labels | Pass | Pass
Solder joints | Pass | Pass
Components | Pass | Pass
Short circuit | Pass | Pass
PCB solder mask | Pass | Pass

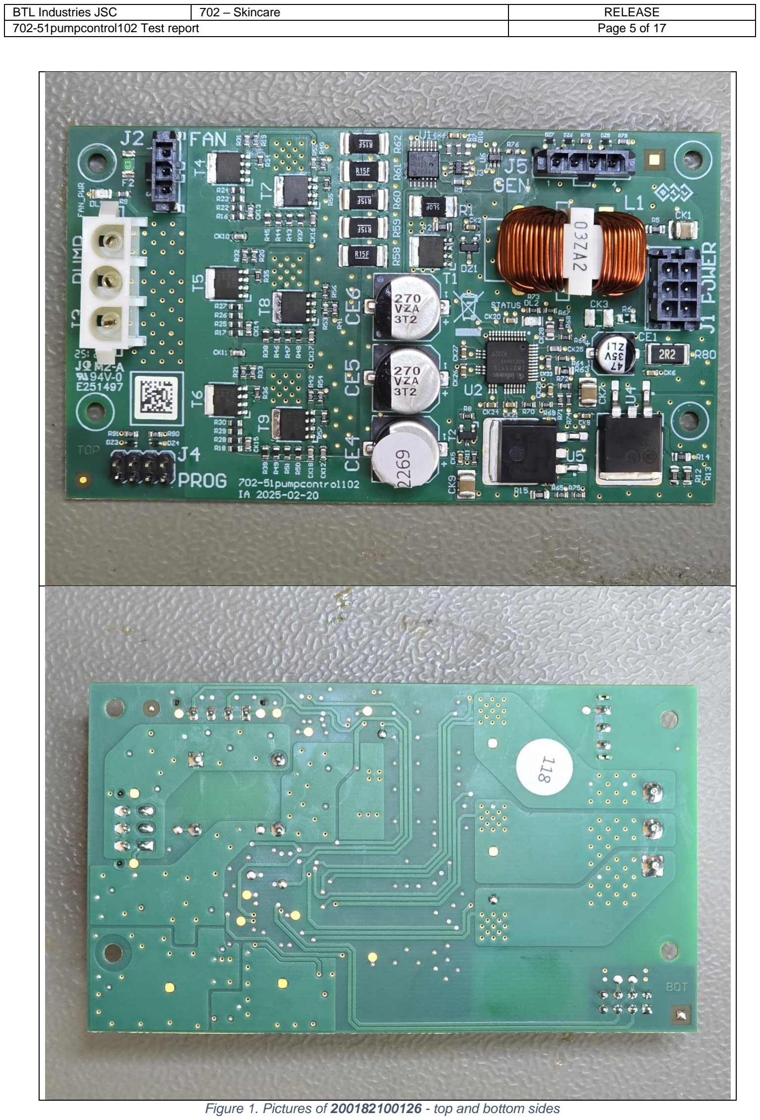
[picture p67: page 5]

Figure 1. Pictures of 200182100126 - top and bottom sides

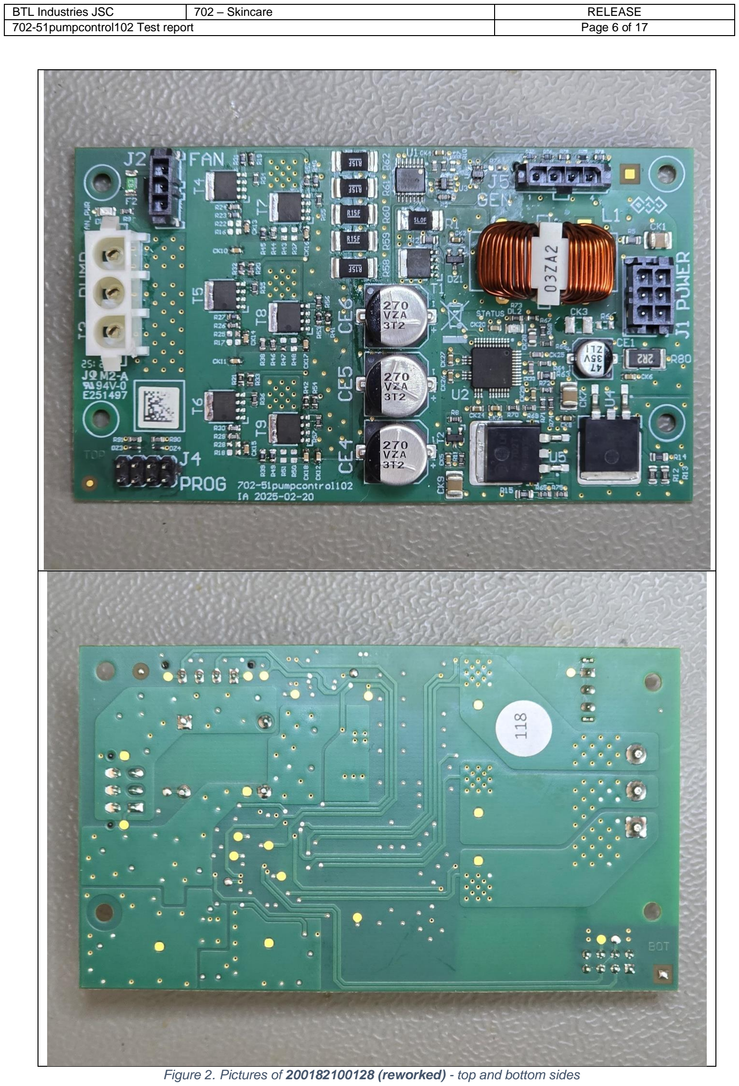
[picture p68: page 6]

Figure 2. Pictures of 200182100128 (reworked) - top and bottom sides

## 6. Electrical measurements

6.1. Power

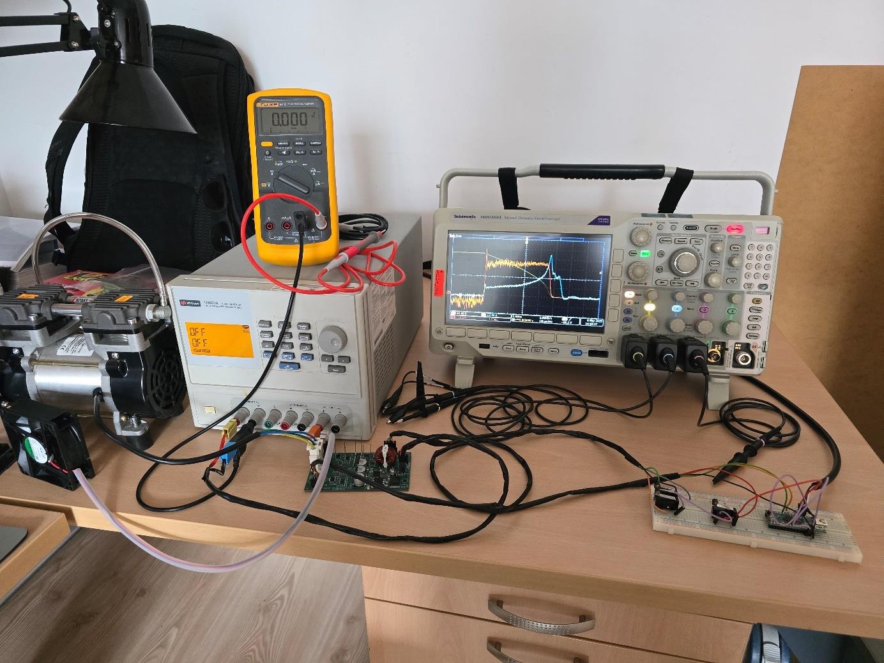
[picture p69: figure]

Figure 3. Power test setup

Table 2. Power measurements
Serial number | 200182100126 | 200182100128 (reworked)
| Stage 1: Pump/Fan OFF
U+24V_FILT [V] (TP3) | 23.99 | 24.00
U+15V [V] (TP19) | 14.85 | 14.77
U+3.3V [V] (TP11) | 3.315 | 3.314
UUVEN [V] (TP15) | 0.002 | 0.002
U+24V [V] (TP1) | 1.810 | 1.838
DL1 [ON/OFF] | OFF | OFF
U+24V_FAN [V] (TP4) | 1.809 | 1.837
U\PG [V] (TP16) | 3.286 | 3.284
Stage 2: Pump/Fan ON
UUVEN [V] (TP15) | 3.320 | 3.319
U+24V [V] (TP1) | 23.99 | 23.99
DL1 [ON/OFF] | ON | ON
U+24V_FAN [V] (TP4) | 23.87 | 23.89
U\PG [V] (TP16) | 0.008 | 0.009

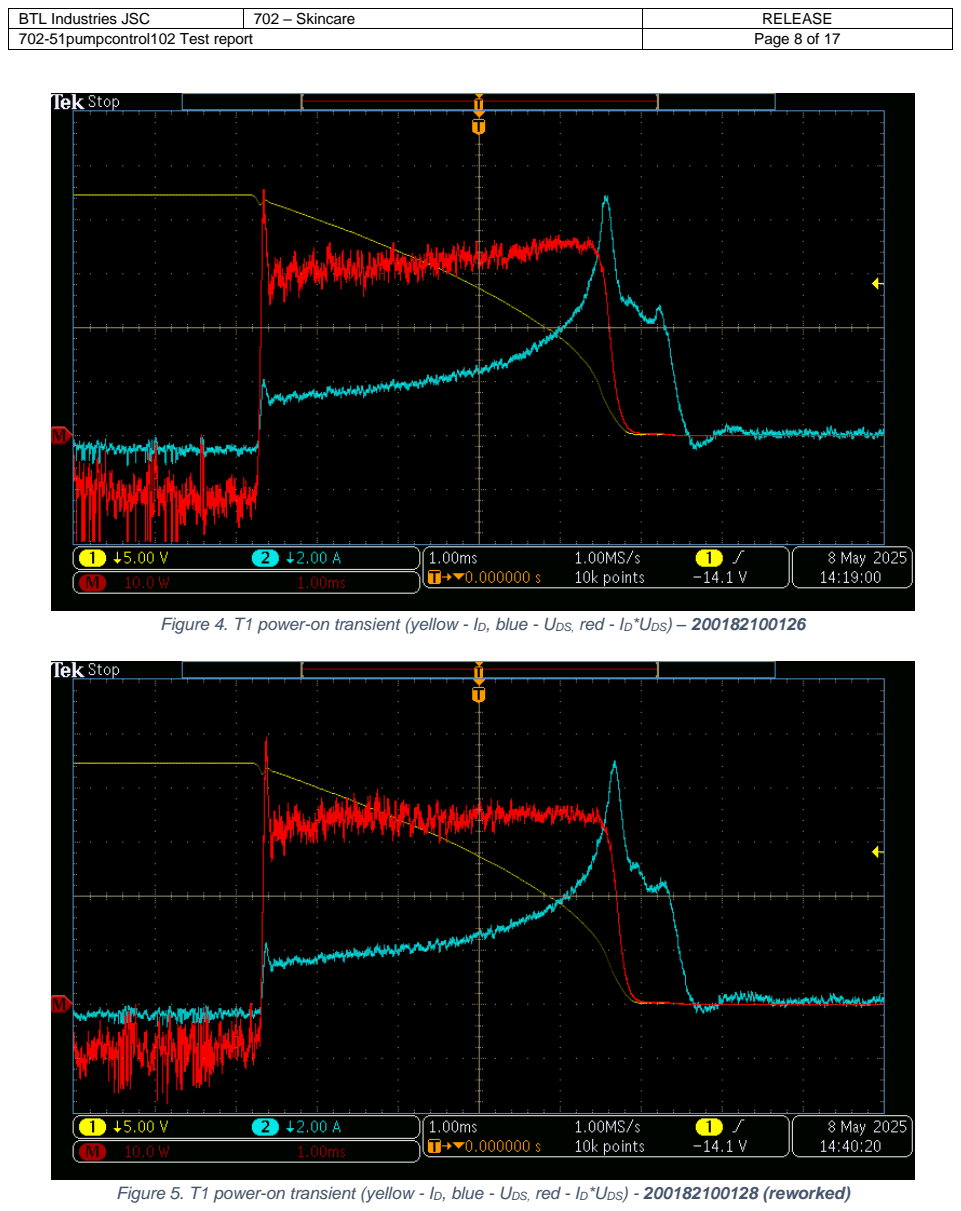
[picture p70: page 8]

Figure 4. T1 power-on transient (yellow - ID, blue - UDS, red - ID*UDS) – 200182100126

Figure 5. T1 power-on transient (yellow - ID, blue - UDS, red - ID*UDS) - 200182100128 (reworked)

6.2. Driver

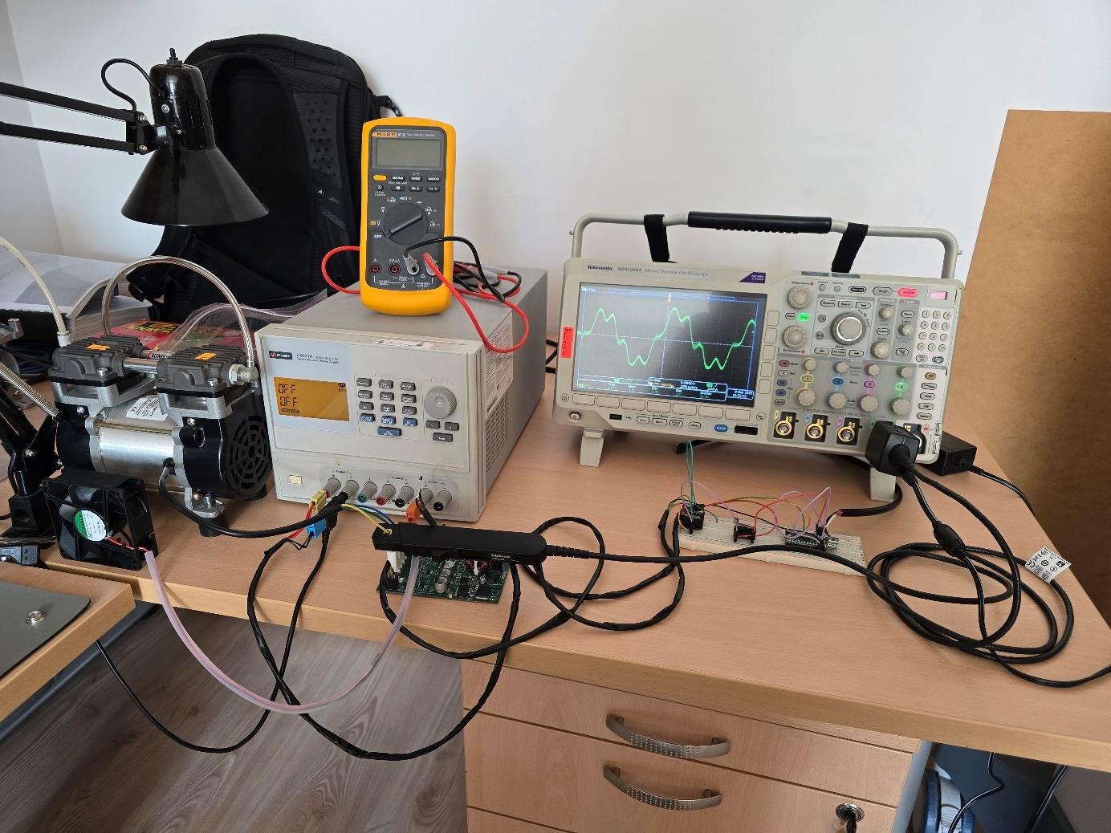
[picture p71: figure]

Figure 6. Driver test setup

Table 3. Driver measurements
Serial number | 200182100126 | 200182100128 (reworked)
| Stage 1: Pump/Fan OFF
DL2 [ON/OFF] | ON | ON
UBUS_SENSE [V] (TP17) | 0.145 | 0.148
UVSP [V] (TP22) | 0.000 | 0.000
Stage 2: Pump/Fan ON
UBUS_SENSE [V] (TP17) | 2.116 | 2.117
UVSP [V] (TP22) | 2.786 | 2.783
fSPEED_FB [Hz] (TP10) | 339.5 | 340.8

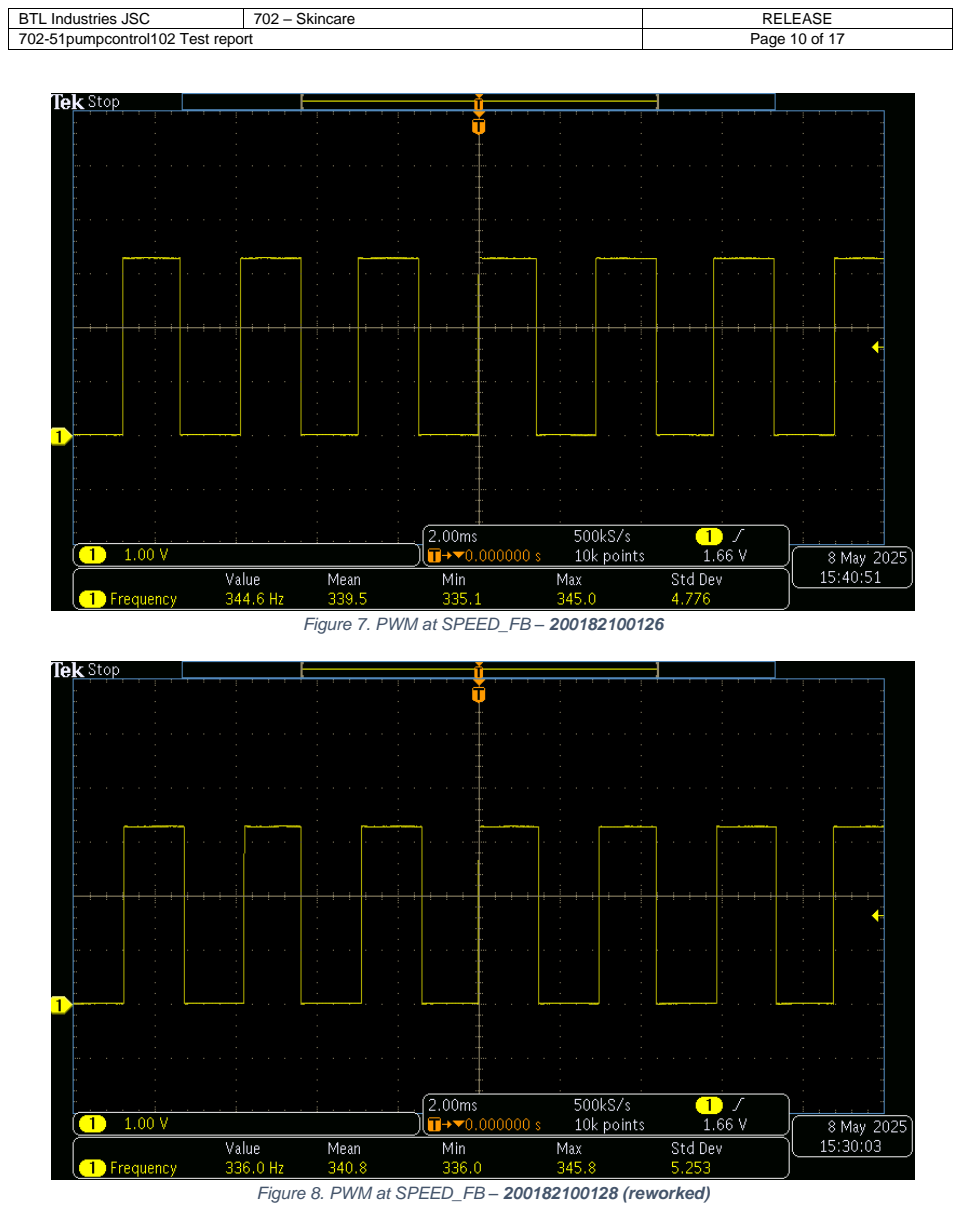
[picture p72: page 10]

Figure 7. PWM at SPEED_FB – 200182100126

Figure 8. PWM at SPEED_FB – 200182100128 (reworked)

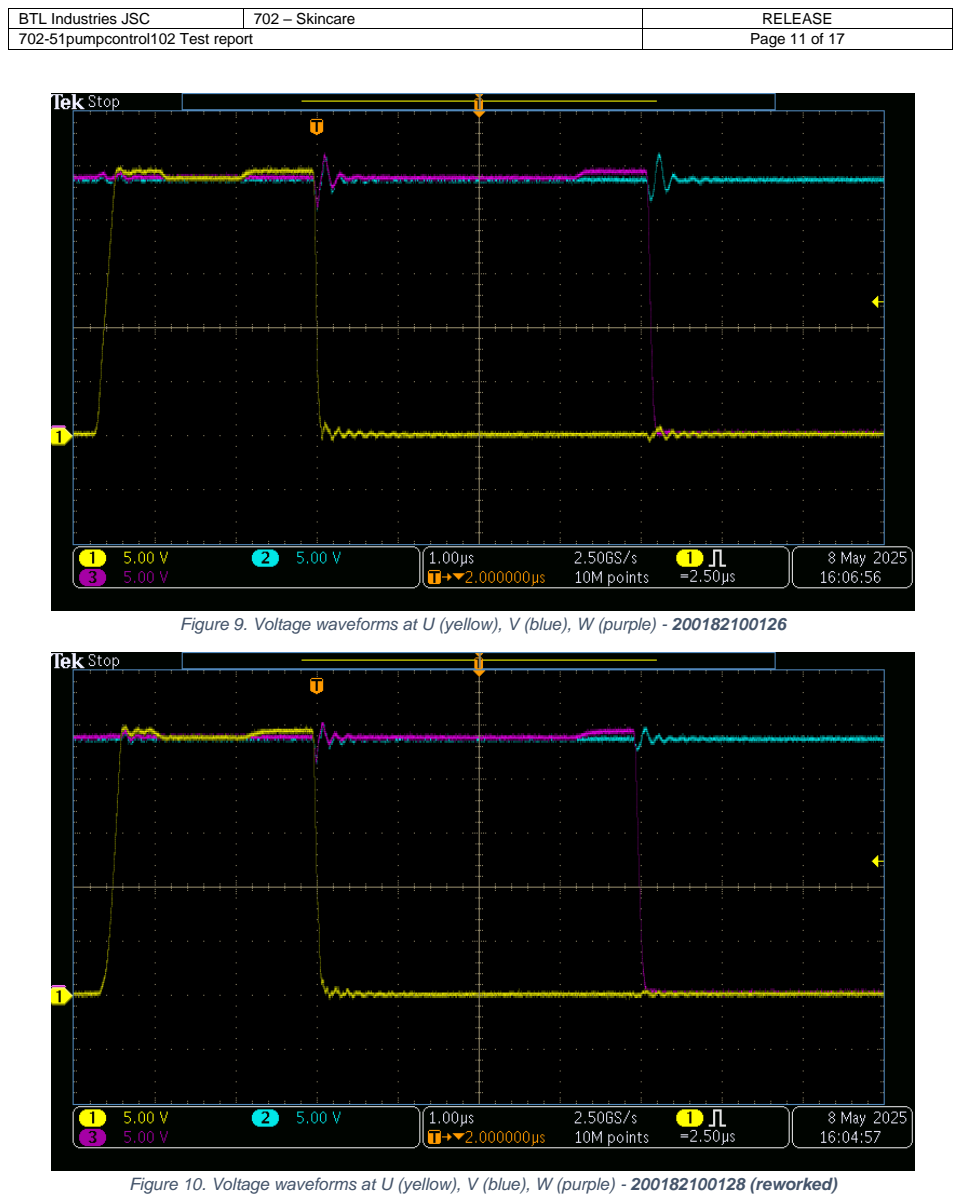
[picture p73: page 11]

Figure 9. Voltage waveforms at U (yellow), V (blue), W (purple) - 200182100126

Figure 10. Voltage waveforms at U (yellow), V (blue), W (purple) - 200182100128 (reworked)

NOT SYNCHRONIZED!

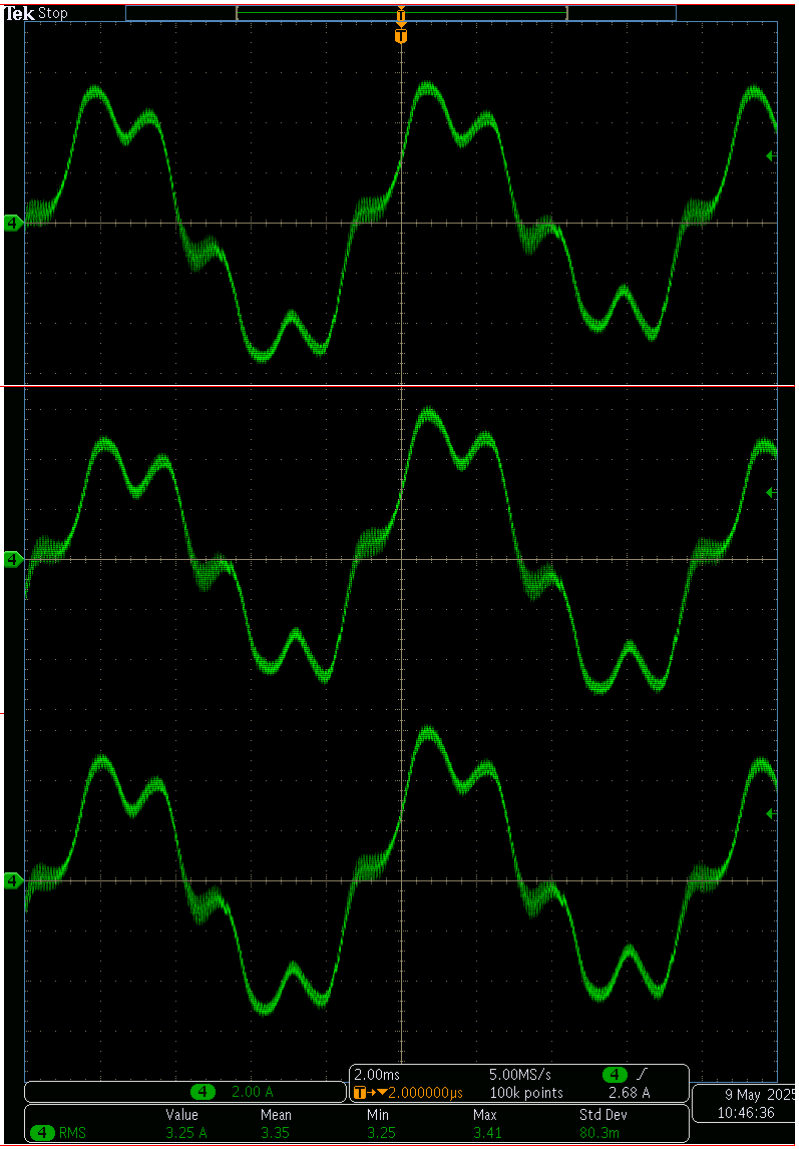
[picture p74: figure]

Figure 11. Current waveforms at U (top), V (middle), W (bottom) - 200182100126

NOT SYNCHRONIZED!

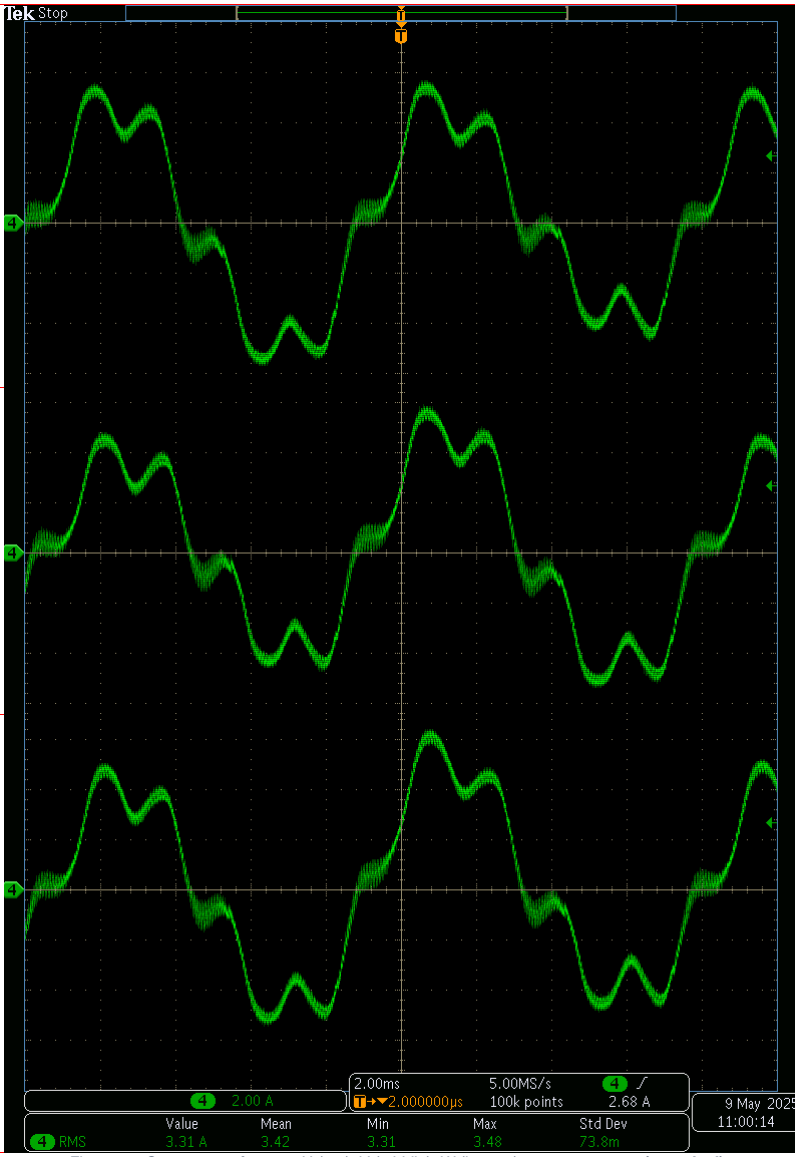
[picture p75: figure]

Figure 12. Current waveforms at U (top), V (middle), W (bottom) - 200182100128 (reworked)

6.3. Control

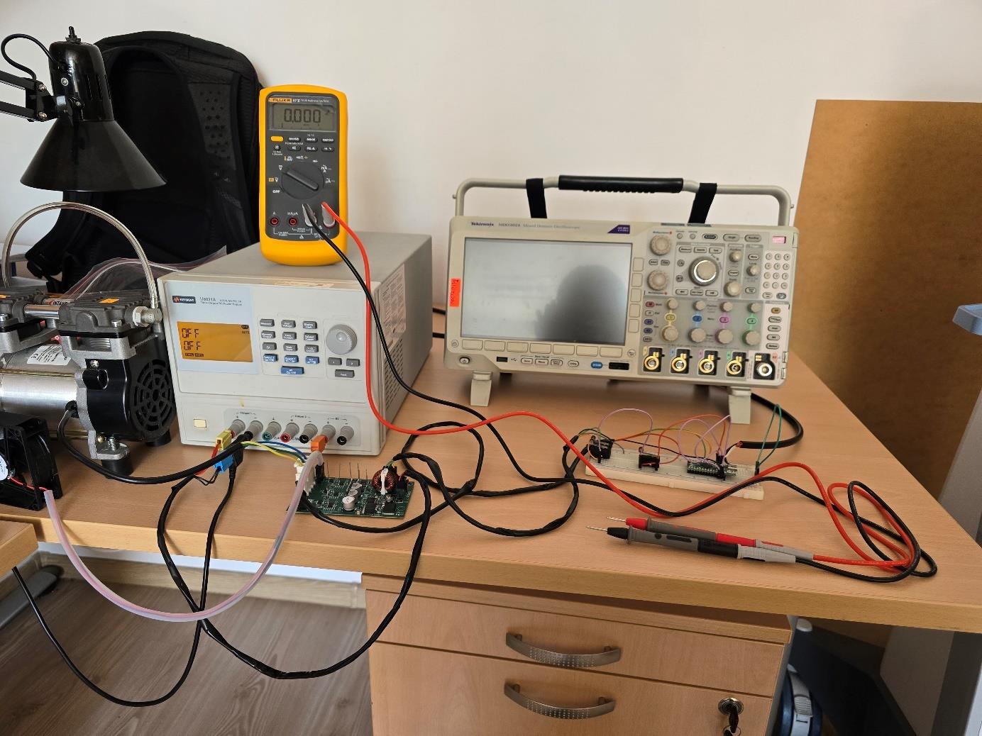
[picture p76: figure]

Figure 13. Control test setup

Table 4. Control measurements
Serial number | 200182100126 | 200182100128 (reworked)
| Stage 1: Pump/Fan OFF
U\FAULT_RST [V] (TP13) | 0.832 | 2.558
UON/O\F\F\ [V] (TP12) | 0.000 | 0.000
U\FAULT [V] (TP14) | 3.314 | 3.312
Stage 2: Pump/Fan ON
U\FAULT_RST [V] (TP13) | 0.832 | 2.558
UON/O\F\F\ [V] (TP12) | 3.314 | 3.311
U\FAULT [V] (TP14) | 3.314 | 3.311

## 7. Temperature measurements

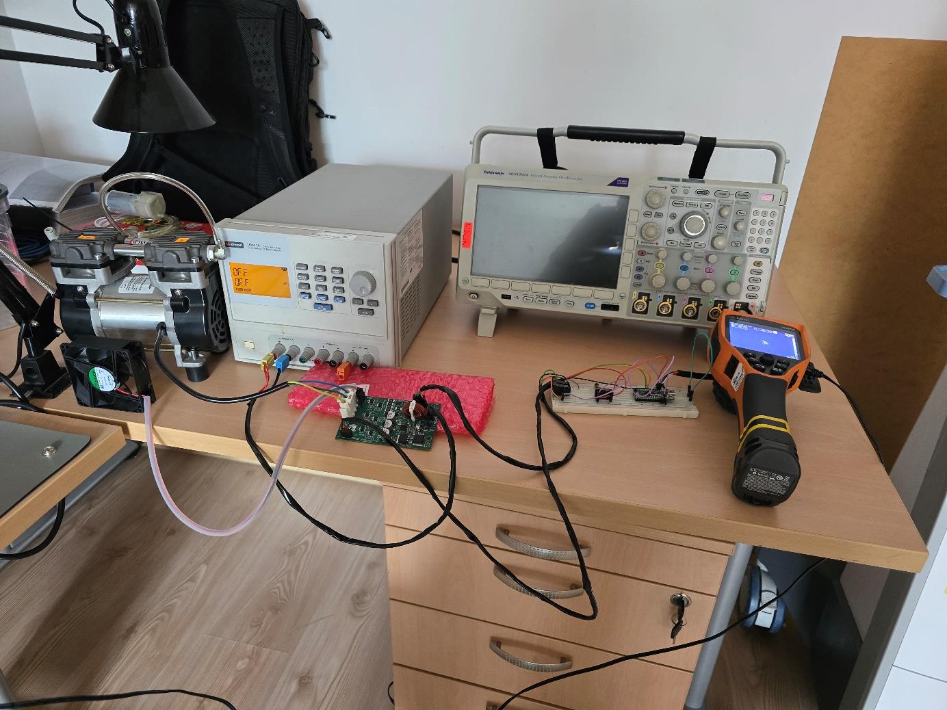
[picture p77: figure]

Figure 14. Temperature measurements test setup

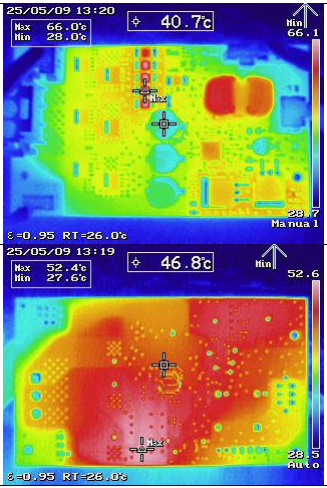
[picture p78: figure]

Figure 15. Temperature measurements of 200182100126 - top and bottom sides

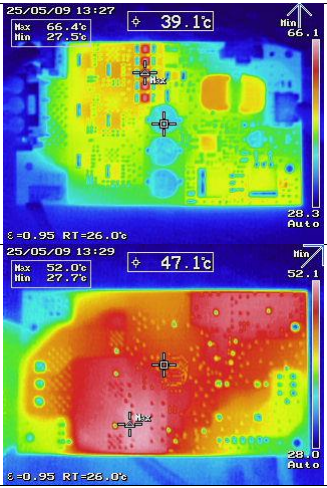
[picture p79: figure]

Figure 16. Temperature measurements of 200182100128 (reworked) - top and bottom sides

## 8. Conclusion

Based on the presented measurements, it can be concluded that certain changes should be made to the PCB for the next revision:

- The inverter’s gate resistances should be increased;
- The inverter’s snubber resistances should be increased;
- The inverter’s snubber capacitances should be decreased;
- The control logic pull-up and pull-down resistances should be decreased;
- The generator connector J5 should be rotated by 180° for easier access.
