IliyanAntov/CodeFreeBLDC/Documentation/Images/Measurements/EMC/VER_therapy - pumpconn104.pdf

## EMI Test Report

35

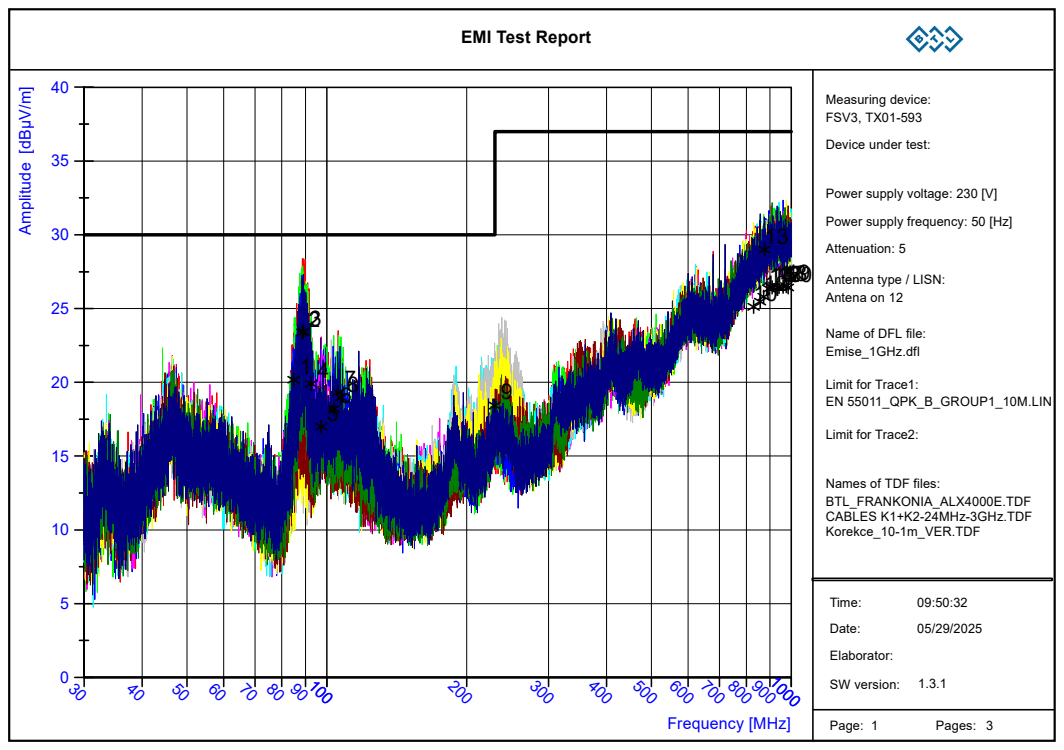
[picture p80: page 1]
Date:; Elaborator:; Page:; Pages:; Frequency [MHz]; plitu; Time:; Attenuation: 5; Measuring device: FSV3, TX01-593; Power supply voltage: 230 [V]; Power supply frequency: 50 [Hz]; Limit for Trace1: EN 55011_QPK_B_GROUP1_10M.LIN; Limit for Trace2:; SW version:

Device under test:

Antenna type / LISN:
Antena on 12

Name of DFL file:
Emise_1GHz.dfl

Names of TDF files:
BTL_FRANKONIA_ALX4000E.TDF
CABLES K1+K2-24MHz-3GHz.TDF
Korekce_10-1m_VER.TDF

Date:

Elaborator:

05/29/2025

Time: | 09:50:33
Index | Frequency MHz | Turntable degree | Peak value dB | Final m. dB | Margin to lim dB | Calc Limit | Polarization

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
84.8267
88.5139
89.0952
92.4910
97.1906
103.5232
105.8234
107.2932
229.8072
829.4198
856.4150
871.5638
875.0346
894.6863
909.2356
932.4852
940.5862
959.9130
974.8392
983.5382

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
22.8
28.4
27.8
23.3
20.9
23.2
23.5
23.1
22.7
30.8
31.4
31.4
31.2
31.6
30.8
30.4
32.2
32.3
32.3
30.5

20.2
23.4
23.4
19.9
17.0
18.2
19.3
18.9
18.4
25.1
25.5
25.8
29.0
26.3
26.4
26.4
26.5
26.5
26.5
26.4

9.8
6.6
6.6
10.1
13.0
11.8
10.7
11.1
11.6
11.9
11.5
11.2
8.0
10.7
10.6
10.6
10.5
10.5
10.5
10.6

30.0
30.0
30.0
30.0
30.0
30.0
30.0
30.0
30.0
37.0
37.0
37.0
37.0
37.0
37.0
37.0
37.0
37.0
37.0
37.0

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
Attenuation: 5

Measuring device:
FSV3, TX01-593

Device under test:

Power supply voltage: 230 [V]

Power supply frequency: 50 [Hz]

Antenna type / LISN:
Antena on 12

Name of DFL file:
Emise_1GHz.dfl

Limit for Trace1:
EN 55011_QPK_B_GROUP1_10M.LIN

Limit for Trace2:

Names of TDF files:
BTL_FRANKONIA_ALX4000E.TDF CABLES K1+K2-24MHz-3GHz.TDF Korekce_10-1m_VER.TDF

SW version: 1.3.1

Date:

Elaborator:

05/29/2025

Time: | 09:50:33

Attenuation: 5

Measuring device:
FSV3, TX01-593

Device under test:

Power supply voltage: 230 [V]

Power supply frequency: 50 [Hz]

Antenna type / LISN:
Antena on 12

Name of DFL file:
Emise_1GHz.dfl

Limit for Trace1:
EN 55011_QPK_B_GROUP1_10M.LIN

Limit for Trace2:

Names of TDF files:
BTL_FRANKONIA_ALX4000E.TDF CABLES K1+K2-24MHz-3GHz.TDF Korekce_10-1m_VER.TDF

SW version: 1.3.1
