IliyanAntov/CodeFreeBLDC/Documentation/Images/Measurements/EMC/VER_therapy - pumpcontrol103.pdf

## EMI Test Report

35

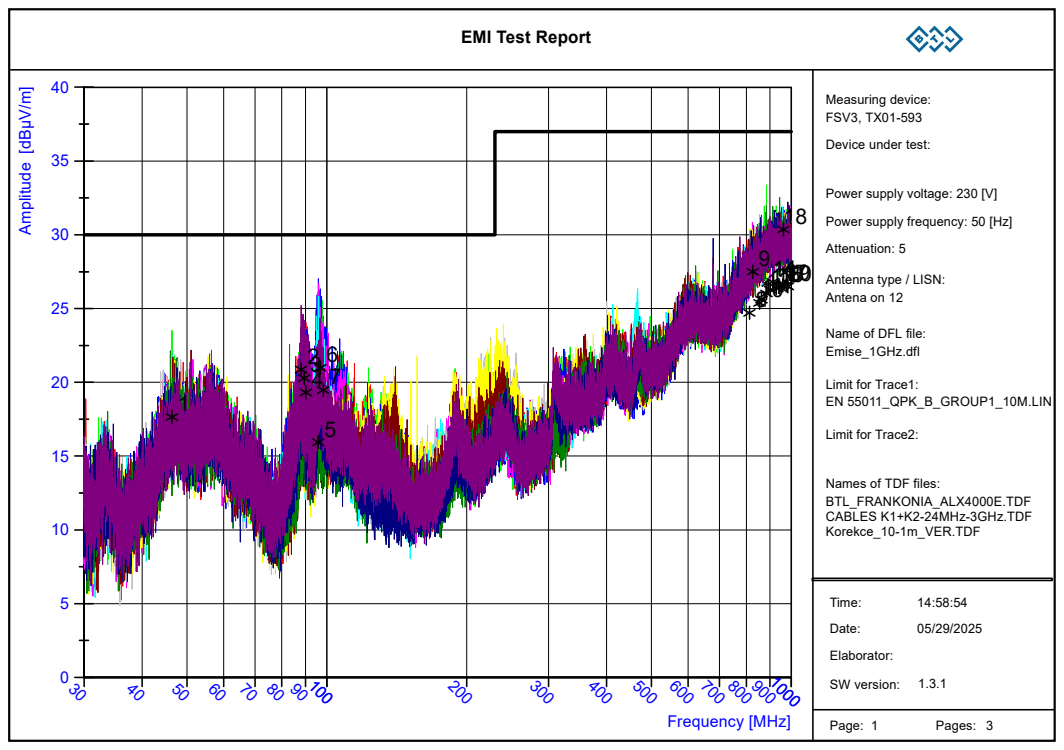
[picture p81: page 1]
Date:; Elaborator:; Page:; Pages:; Frequency [MHz]; plitu; Time:; Attenuation: 5; Measuring device: FSV3, TX01-593; Power supply voltage: 230 [V]; Power supply frequency: 50 [Hz]; Antenna type / LISN: Antena on 12; Limit for Trace1: EN 55011_QPK_B_GROUP1_10M.LIN; Limit for Trace2:; SW version:

Device under test:

Name of DFL file:
Emise_1GHz.dfl

Names of TDF files:
BTL_FRANKONIA_ALX4000E.TDF
CABLES K1+K2-24MHz-3GHz.TDF
Korekce_10-1m_VER.TDF

Date:

Elaborator:

05/29/2025

Time: | 14:58:55
Index | Frequency MHz | Turntable degree | Peak value dB | Final m. dB | Margin to lim dB | Calc Limit | Polarization

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
46.3849
88.0392
89.3455
90.0796
95.7920
96.7825
98.2185
812.3404
824.9719
854.0157
862.0395
883.6689
900.7727
912.0033
928.1353
944.3319
959.0158
961.7100
974.8392
982.8486

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
20.8
25.2
22.9
24.1
22.6
26.3
24.5
30.3
30.8
28.8
31.3
33.4
31.3
31.9
31.9
32.5
30.3
31.9
31.7
32.2

17.6
20.9
20.3
19.3
15.9
21.0
19.5
24.7
27.5
25.4
25.6
26.0
26.3
26.8
26.4
26.4
26.6
30.4
26.6
26.5

12.4
9.1
9.7
10.7
14.1
9.0
10.5
12.3
9.5
11.6
11.4
11.0
10.7
10.2
10.6
10.6
10.4
6.6
10.4
10.5

30.0
30.0
30.0
30.0
30.0
30.0
30.0
37.0
37.0
37.0
37.0
37.0
37.0
37.0
37.0
37.0
37.0
37.0
37.0
37.0

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
Attenuation: 5

Measuring device:
FSV3, TX01-593

Device under test:

Power supply voltage: 230 [V]

Power supply frequency: 50 [Hz]

Antenna type / LISN:
Antena on 12

Name of DFL file:
Emise_1GHz.dfl

Limit for Trace1:
EN 55011_QPK_B_GROUP1_10M.LIN

Limit for Trace2:

Names of TDF files:
BTL_FRANKONIA_ALX4000E.TDF CABLES K1+K2-24MHz-3GHz.TDF Korekce_10-1m_VER.TDF

SW version: 1.3.1

Date:

Elaborator:

05/29/2025

Time: | 14:58:55

Attenuation: 5

Measuring device:
FSV3, TX01-593

Device under test:

Power supply voltage: 230 [V]

Power supply frequency: 50 [Hz]

Antenna type / LISN:
Antena on 12

Name of DFL file:
Emise_1GHz.dfl

Limit for Trace1:
EN 55011_QPK_B_GROUP1_10M.LIN

Limit for Trace2:

Names of TDF files:
BTL_FRANKONIA_ALX4000E.TDF CABLES K1+K2-24MHz-3GHz.TDF Korekce_10-1m_VER.TDF

SW version: 1.3.1
