IliyanAntov/CodeFreeBLDC/Design/Testing/Pictures/200182100126/03. SOA_T1.png

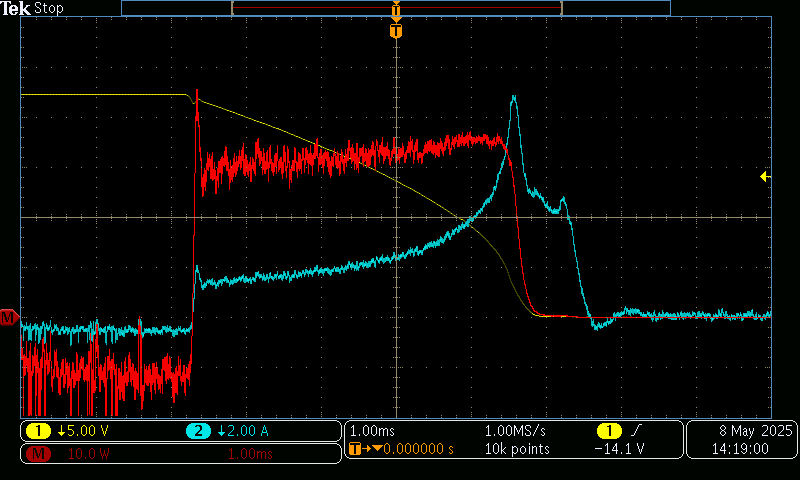
Design/Testing/Pictures/200182100126/03. SOA_T1.png
