IliyanAntov/CodeFreeBLDC/Design/Testing/Pictures/200182100126/04. SPEED_FB.png

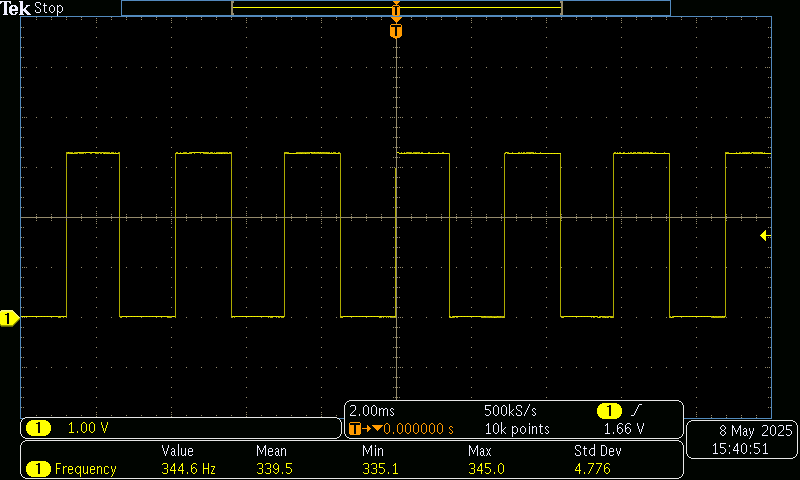
Design/Testing/Pictures/200182100126/04. SPEED_FB.png
