IliyanAntov/CodeFreeBLDC/Design/Testing/Pictures/200182100126/05. Phase_voltages.png

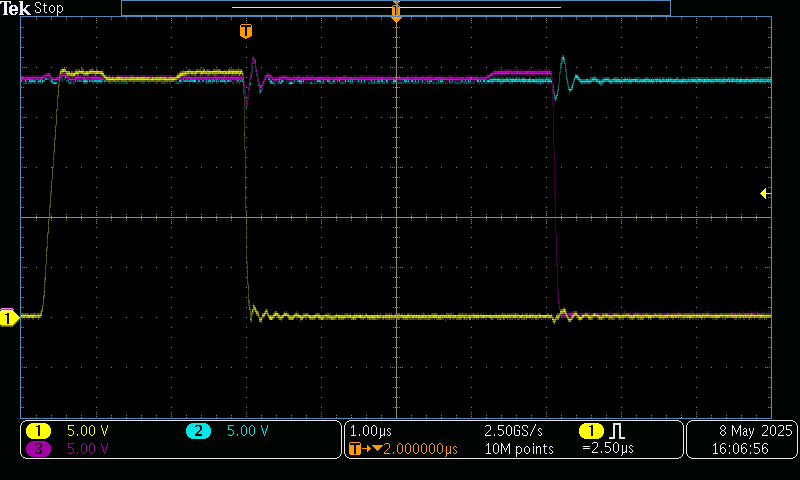
Design/Testing/Pictures/200182100126/05. Phase_voltages.png
