IliyanAntov/CodeFreeBLDC/Design/Testing/Pictures/200182100126/06. Phase_current_U.png

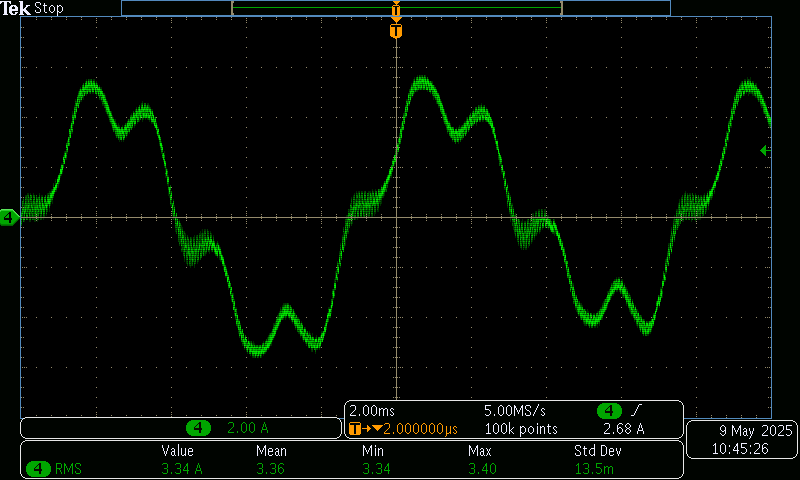
Design/Testing/Pictures/200182100126/06. Phase_current_U.png
