IliyanAntov/CodeFreeBLDC/Design/Testing/Pictures/200182100126/09. Temp_top.JPG

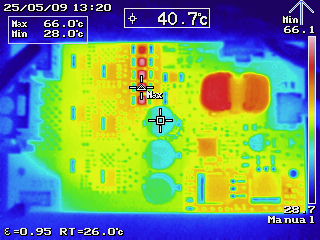
Design/Testing/Pictures/200182100126/09. Temp_top.JPG
