IliyanAntov/CodeFreeBLDC/Design/Testing/Pictures/200182100126/10. Temp_bot.JPG

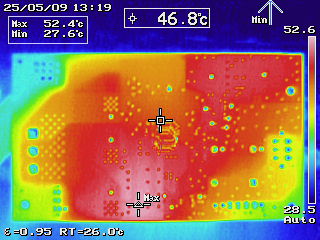
Design/Testing/Pictures/200182100126/10. Temp_bot.JPG
