IliyanAntov/CodeFreeBLDC/Design/Testing/Pictures/200182100128 (reworked)/04. SPEED_FB.png

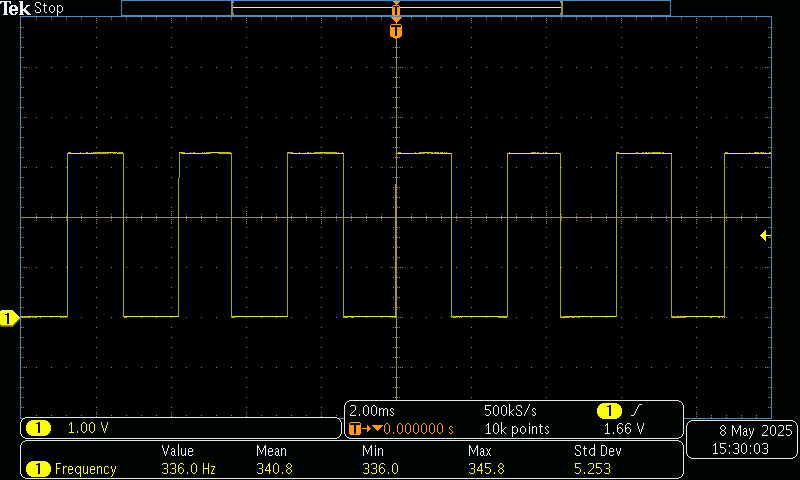
Design/Testing/Pictures/200182100128 (reworked)/04. SPEED_FB.png
