IliyanAntov/CodeFreeBLDC/Design/Testing/Pictures/200182100128 (reworked)/09. Temp_top.JPG

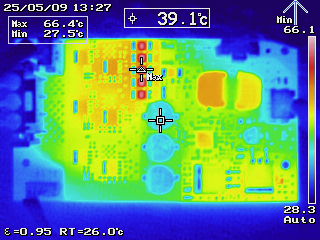
Design/Testing/Pictures/200182100128 (reworked)/09. Temp_top.JPG
