IliyanAntov/CodeFreeBLDC/Design/Testing/Pictures/200182100128 (reworked)/10. Temp_bot.JPG

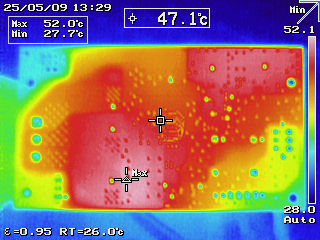
Design/Testing/Pictures/200182100128 (reworked)/10. Temp_bot.JPG
