IliyanAntov/CodeFreeBLDC/Documentation/Images/Driver configuration/Hardware calibration/2_Gate_resistors_v102_v103_50_75_100_100kHz_1GHz.png

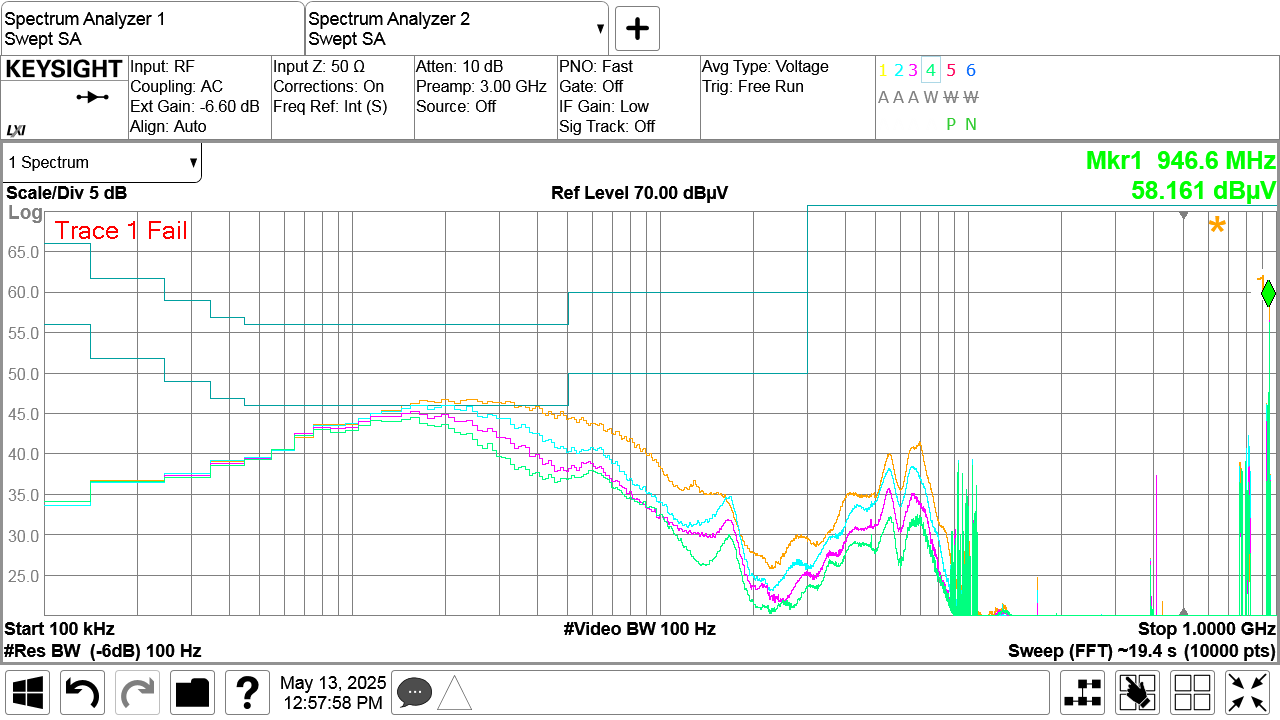
Documentation/Images/Driver configuration/Hardware calibration/2_Gate_resistors_v102_v103_50_75_100_100kHz_1GHz.png
