IliyanAntov/CodeFreeBLDC/Documentation/Images/Driver configuration/Hardware calibration/3_Gate_resistors_v102_v103_50_75_100_150kHz_30MHz.png

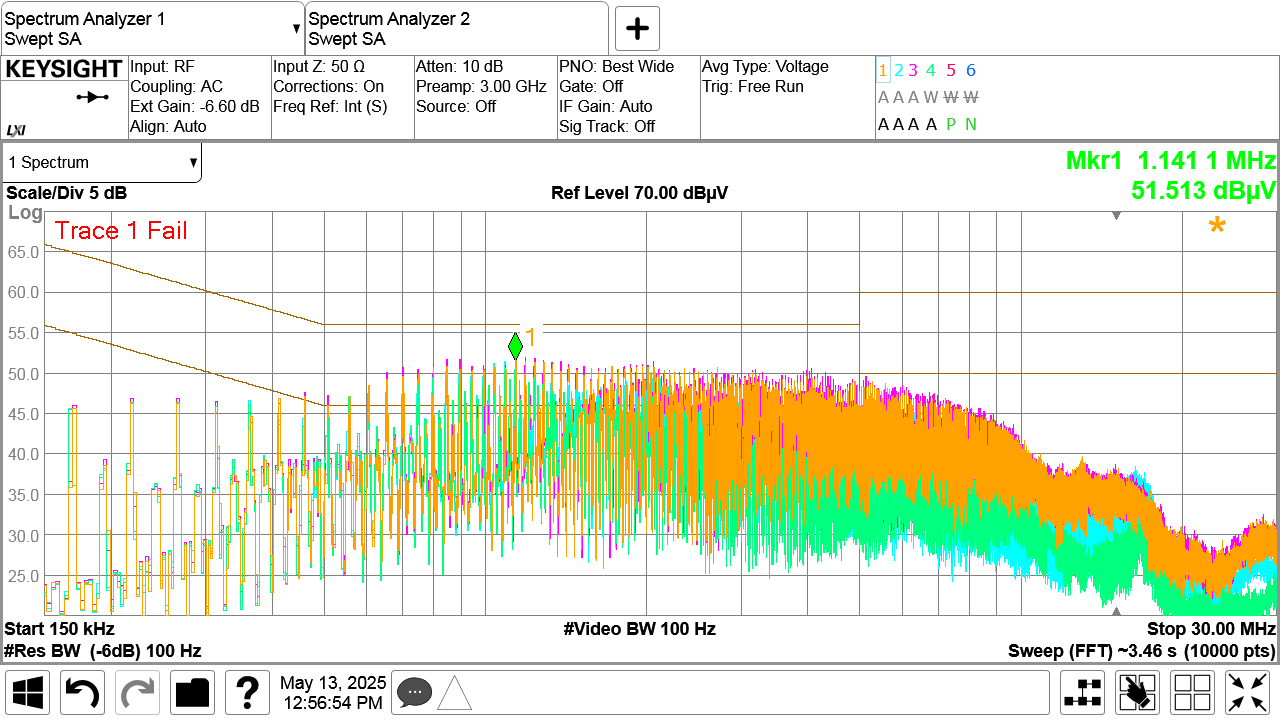
Documentation/Images/Driver configuration/Hardware calibration/3_Gate_resistors_v102_v103_50_75_100_150kHz_30MHz.png
