IliyanAntov/CodeFreeBLDC/Documentation/Images/Measurements/EMC/2_New_controller.png

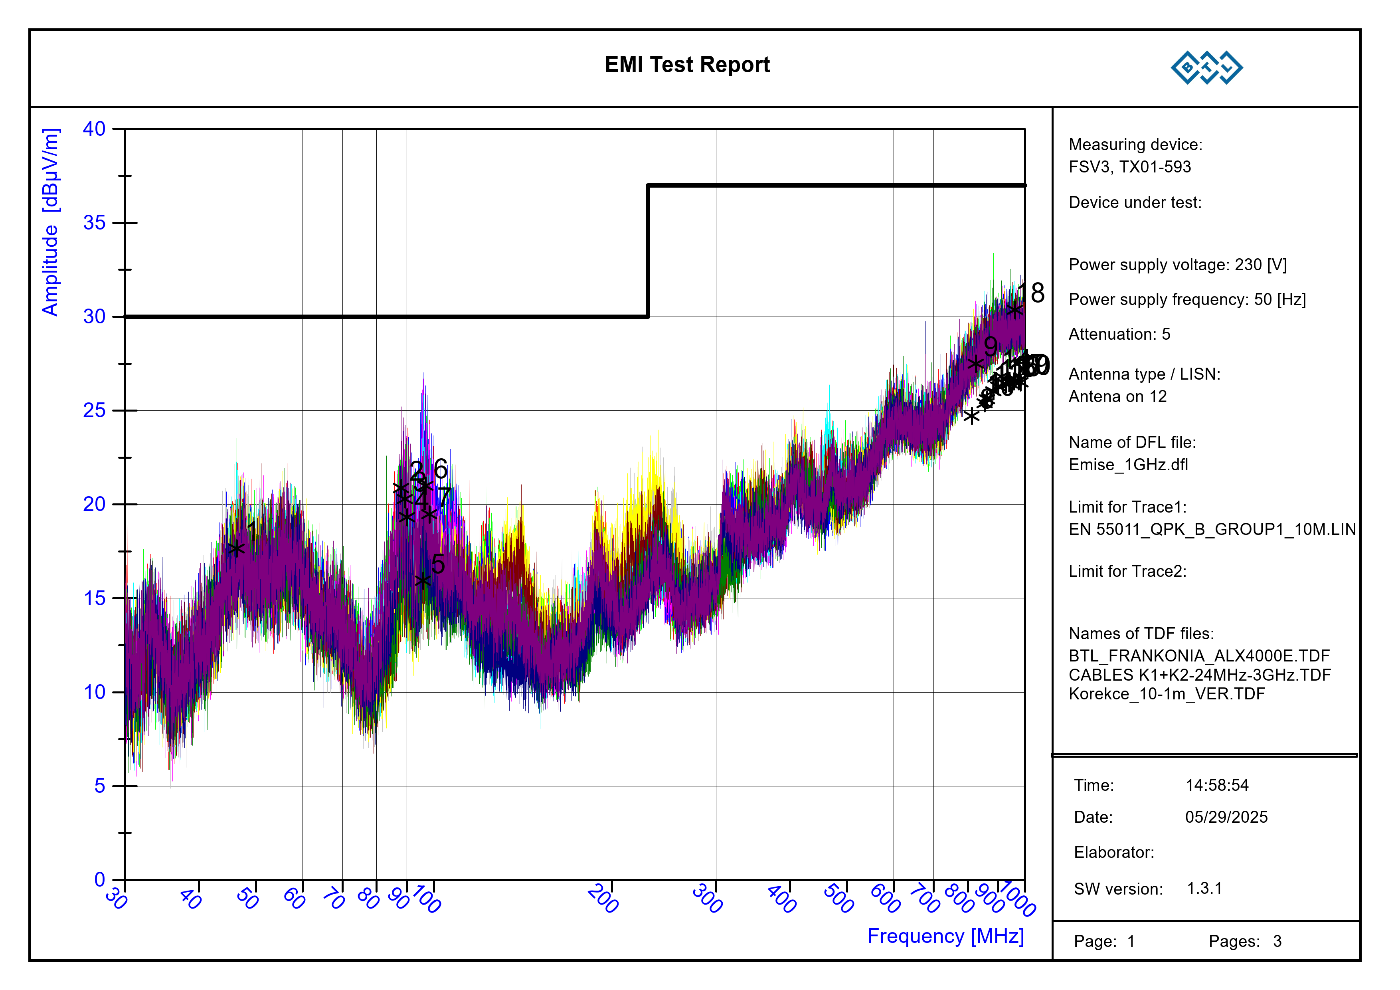
Documentation/Images/Measurements/EMC/2_New_controller.png
