IliyanAntov/CodeFreeBLDC/Documentation/Images/Measurements/Flow rate/2_New_controller.png

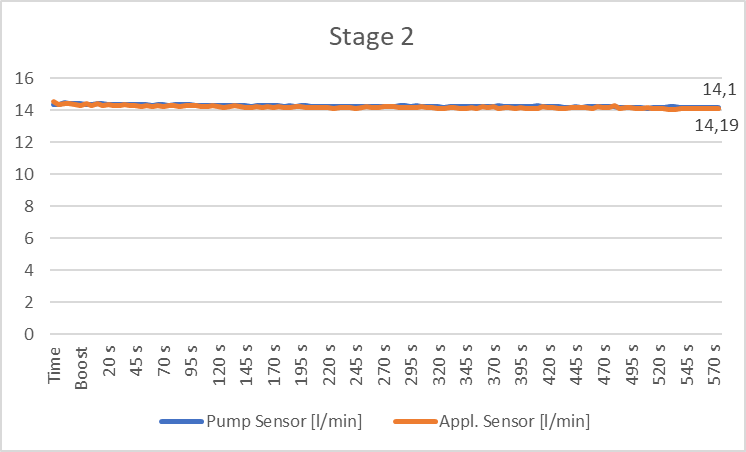
Documentation/Images/Measurements/Flow rate/2_New_controller.png
