IliyanAntov/CodeFreeBLDC/Documentation/Images/Measurements/Starting current/3_New_controller.png

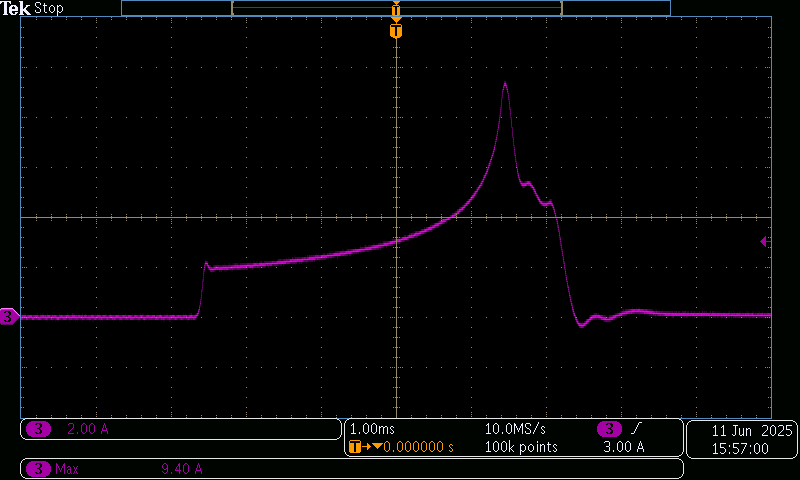
Documentation/Images/Measurements/Starting current/3_New_controller.png
