IliyanAntov/CodeFreeBLDC/Design/PCB/Layers.pdf

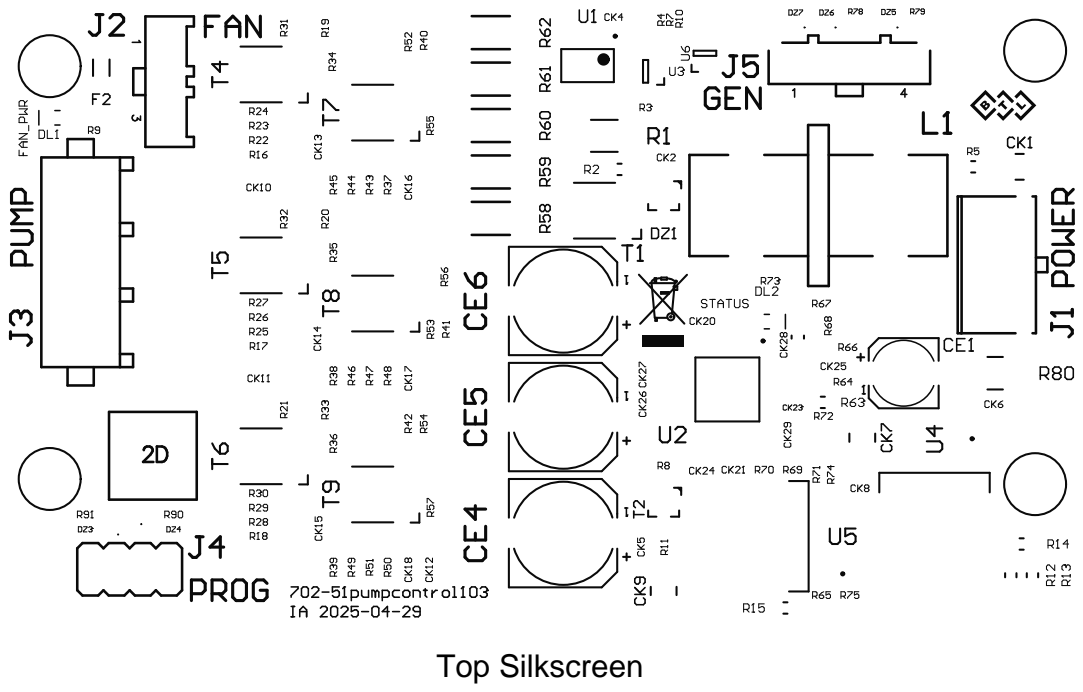
[picture p96: page 1]
Top Silkscreen

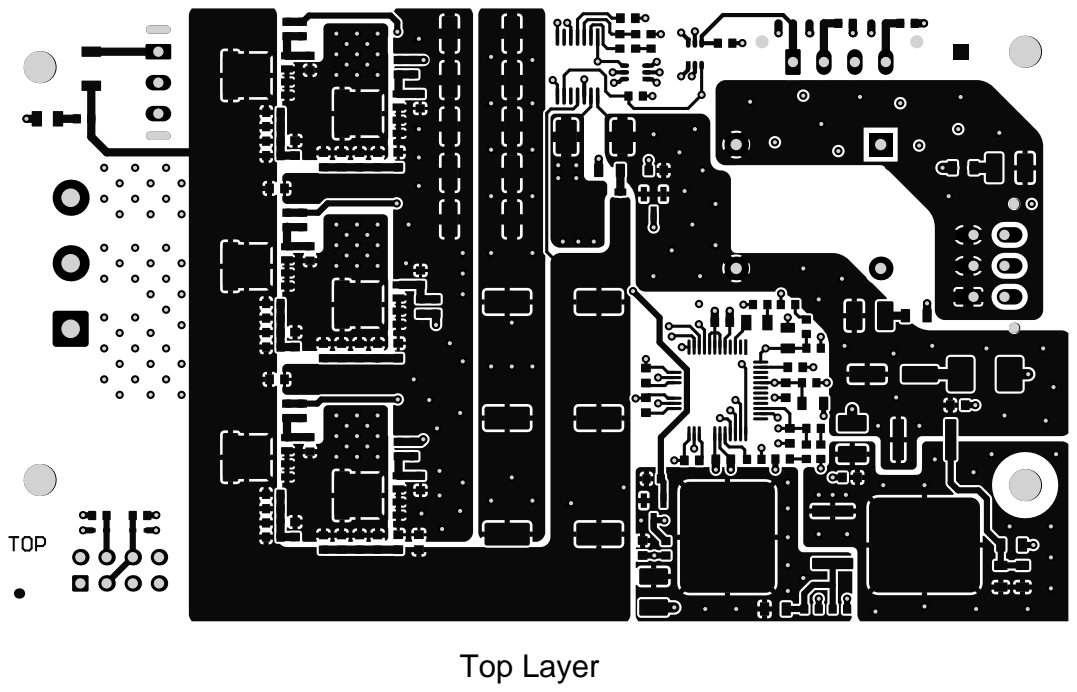
[picture p97: page 2]
Top Layer

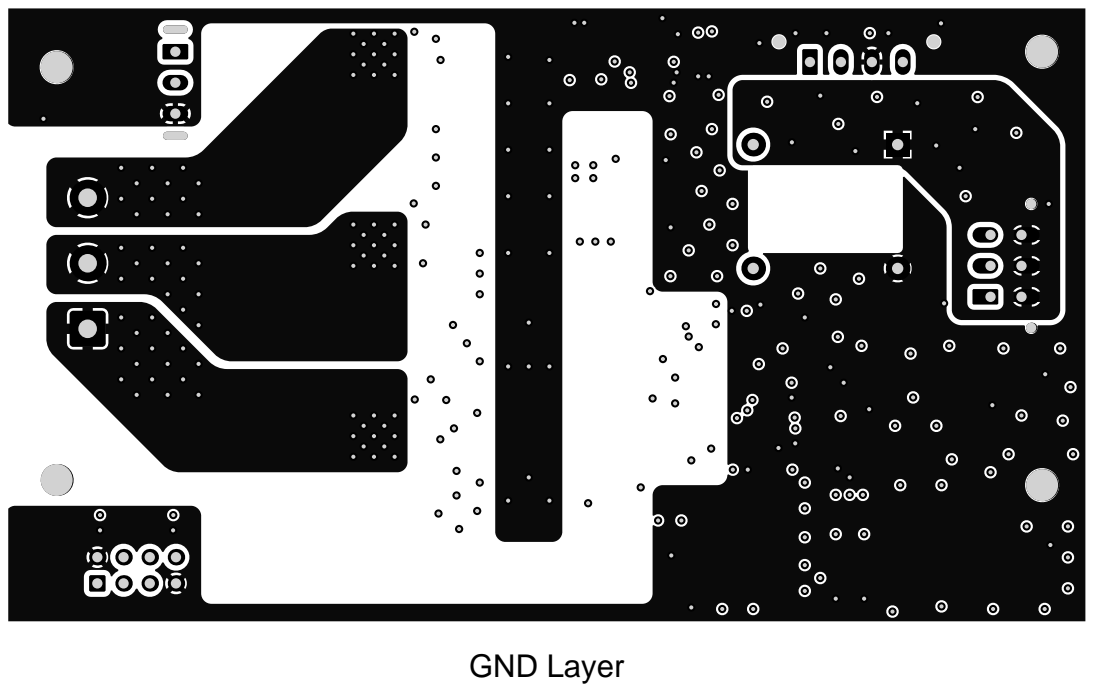
[picture p98: page 3]
GND Layer

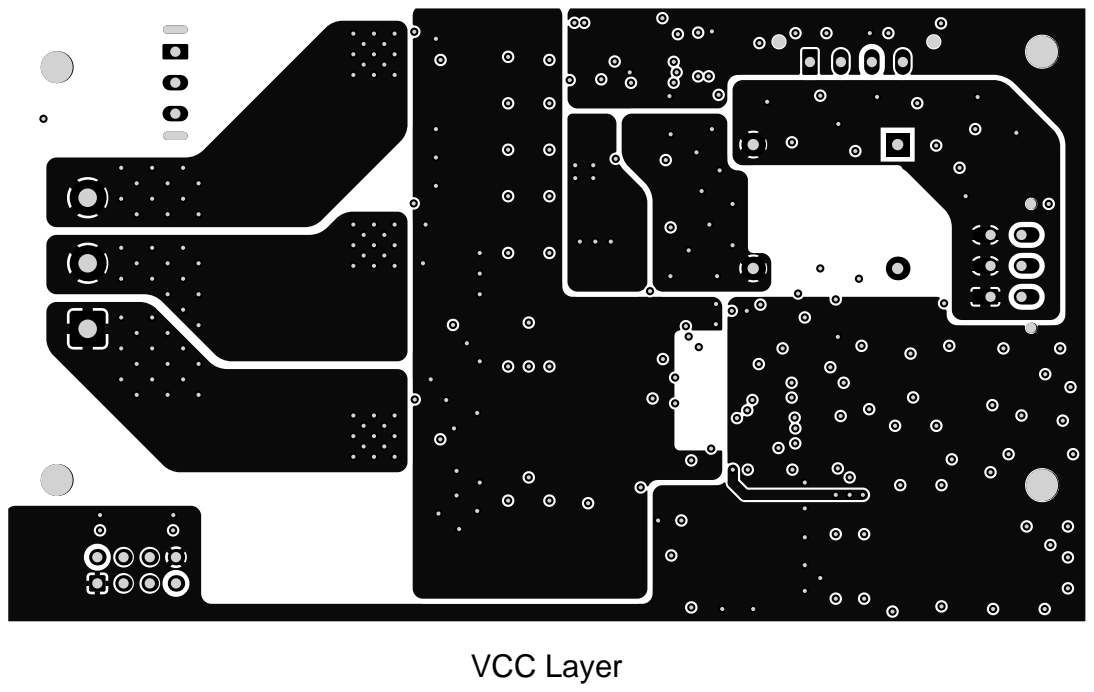
[picture p99: page 4]
VCC Layer

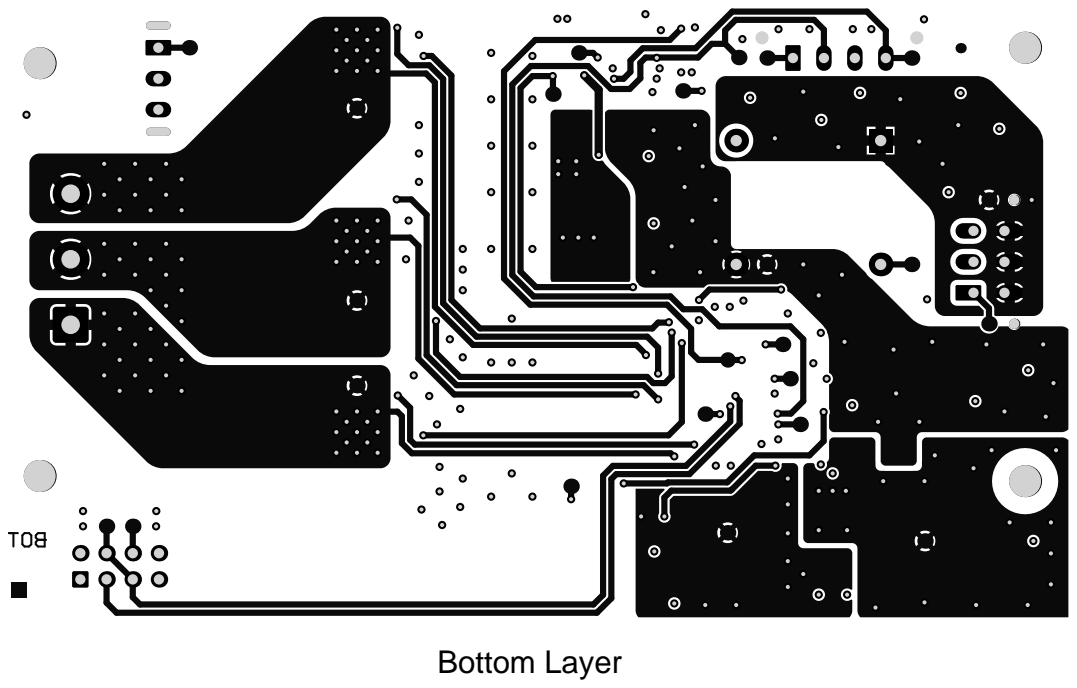
[picture p100: page 5]
Bottom Layer
