IliyanAntov/CodeFreeBLDC/Design/Schematic/Schematic.pdf

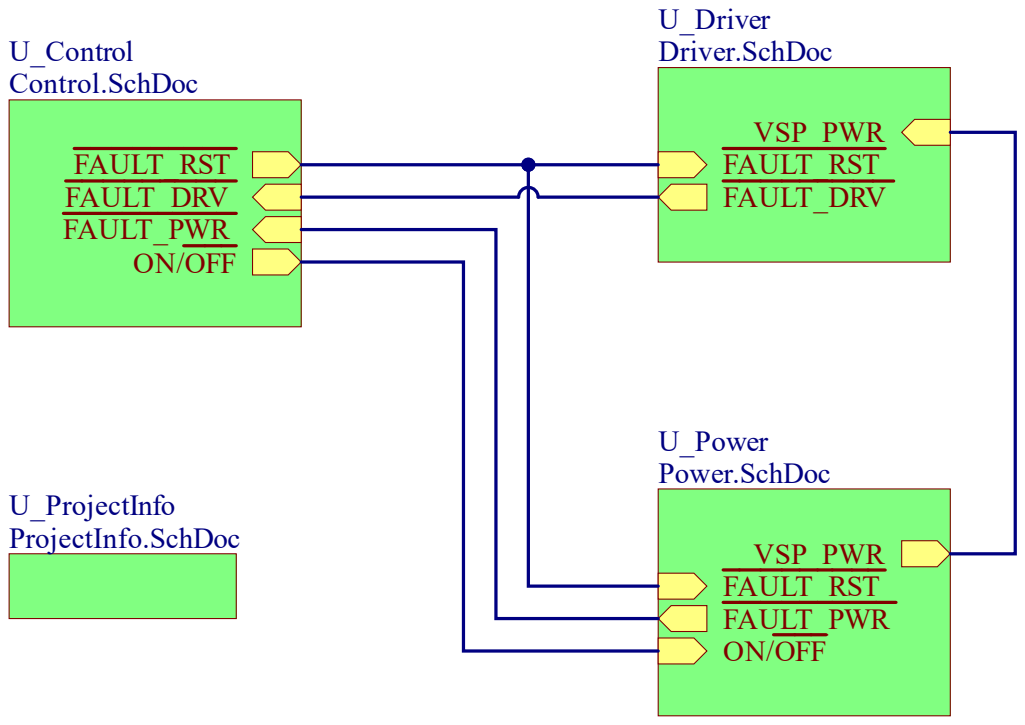
[picture p101: page 1]

Nazev listu/sheet name/: Top.SchDoc | DPS projekt/PCB project/: 702-pumpcontrol

Kreslil /drawn by/ : Iliyan Antov | Kontroloval /checked by/: Boris Botev

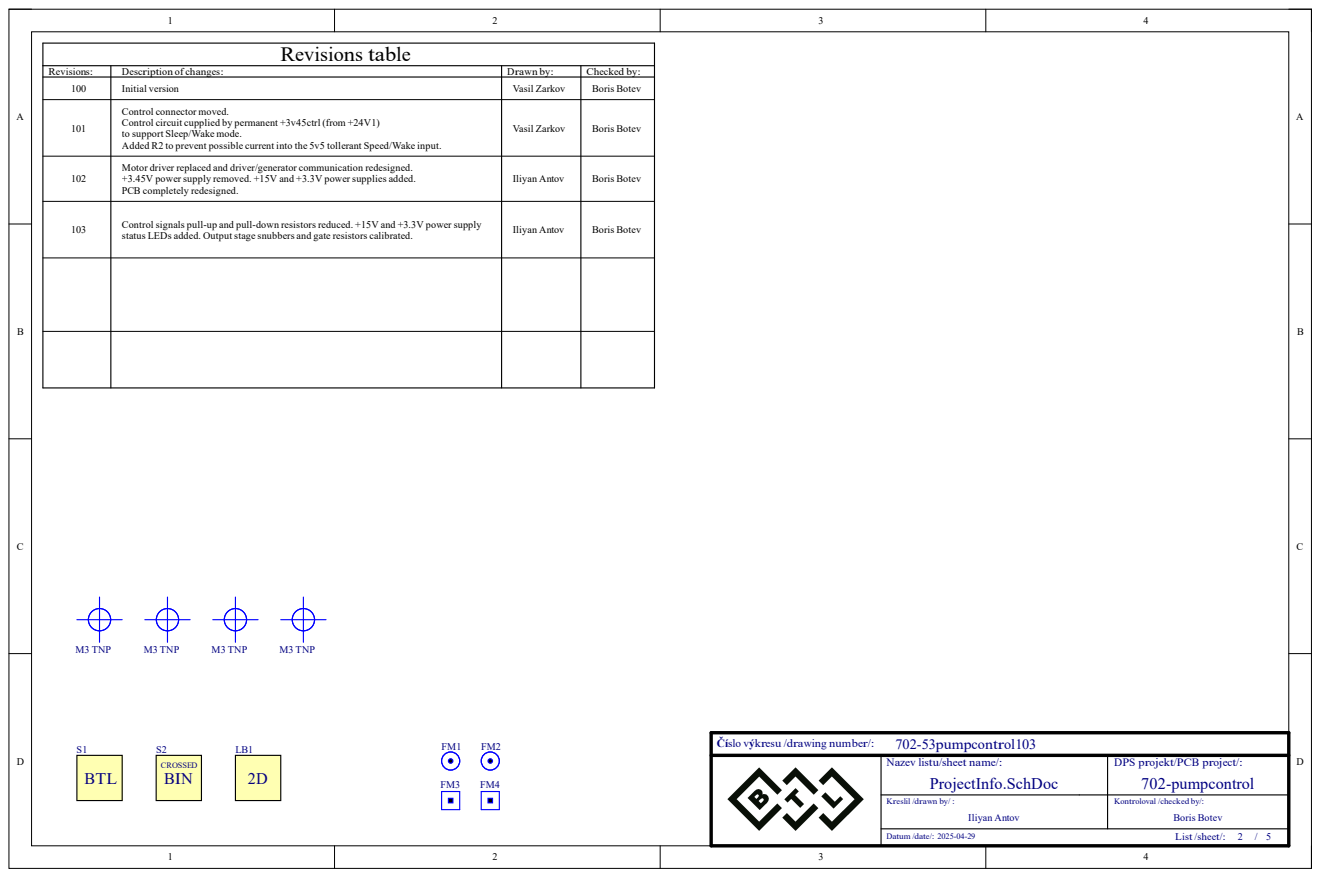
[picture p102: page 2]

Revisions: | Description of changes: | Drawn by: | Checked by:
100 | Initial version | Vasil Zarkov | Boris Botev

Control connector moved.
Control circuit cupplied by permanent +3v45ctrl (from +24V1)
to support Sleep/Wake mode.
Added R2 to prevent possible current into the 5v5 tollerant Speed/Wake input.

101 | | | | Vasil Zarkov | Boris Botev

Motor driver replaced and driver/generator communication redesigned.
+3.45V power supply removed. +15V and +3.3V power supplies added.
PCB completely redesigned.

102 | | | | Iliyan Antov | Boris Botev

Nazev listu/sheet name/:
ProjectInfo.SchDoc

DPS projekt/PCB project/:
702-pumpcontrol

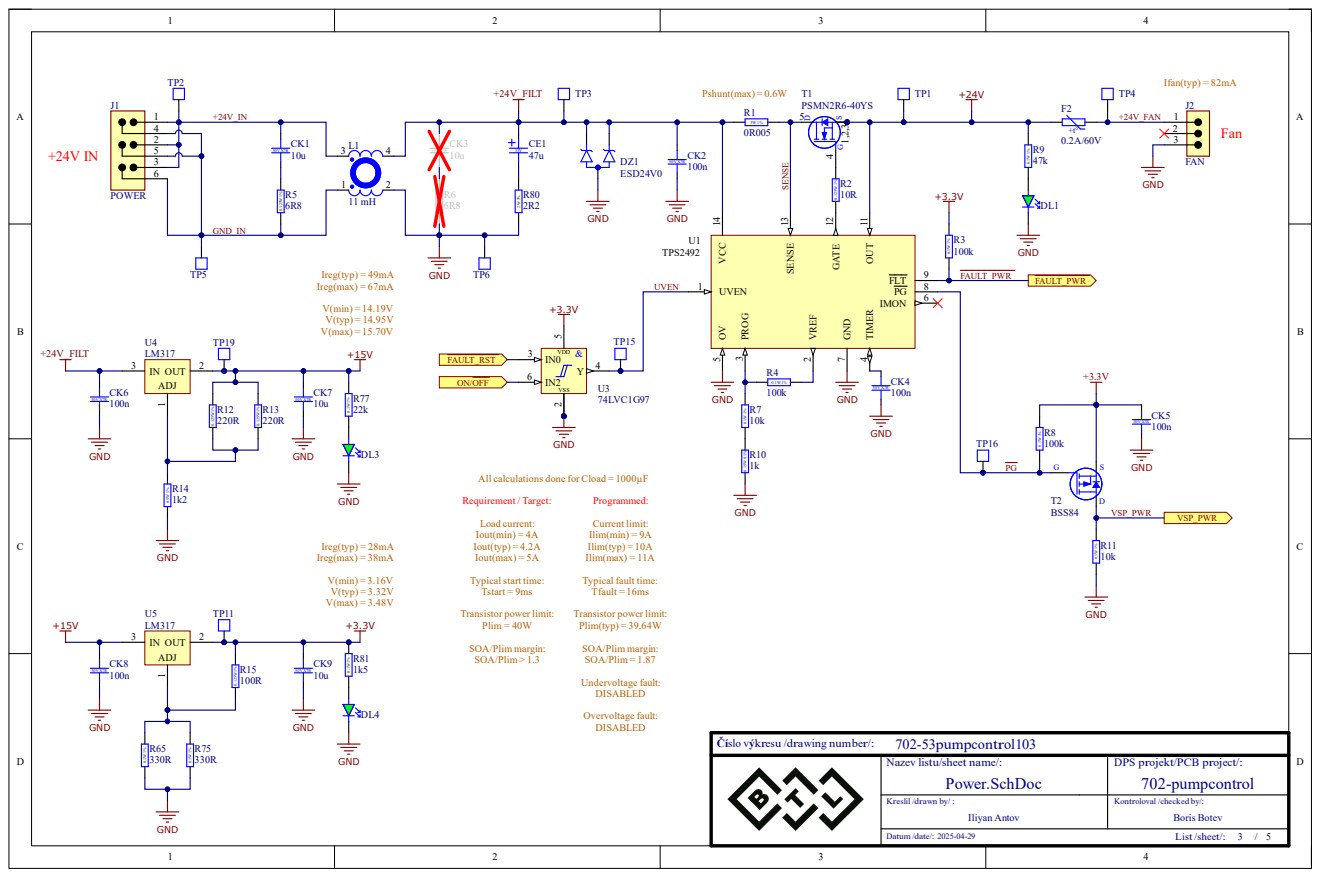
[picture p103: page 3]

Naz ev l i stu / s h e et nam e / : Power.SchDo c | D P S p roje kt/ P CB p roje ct/ : 7 0 2-p u mpco ntro l

Kr e slil /drawn by/ : Il i yan A nt o v | Kon troloval /c h e c k e d by/: Bori s Bo tev

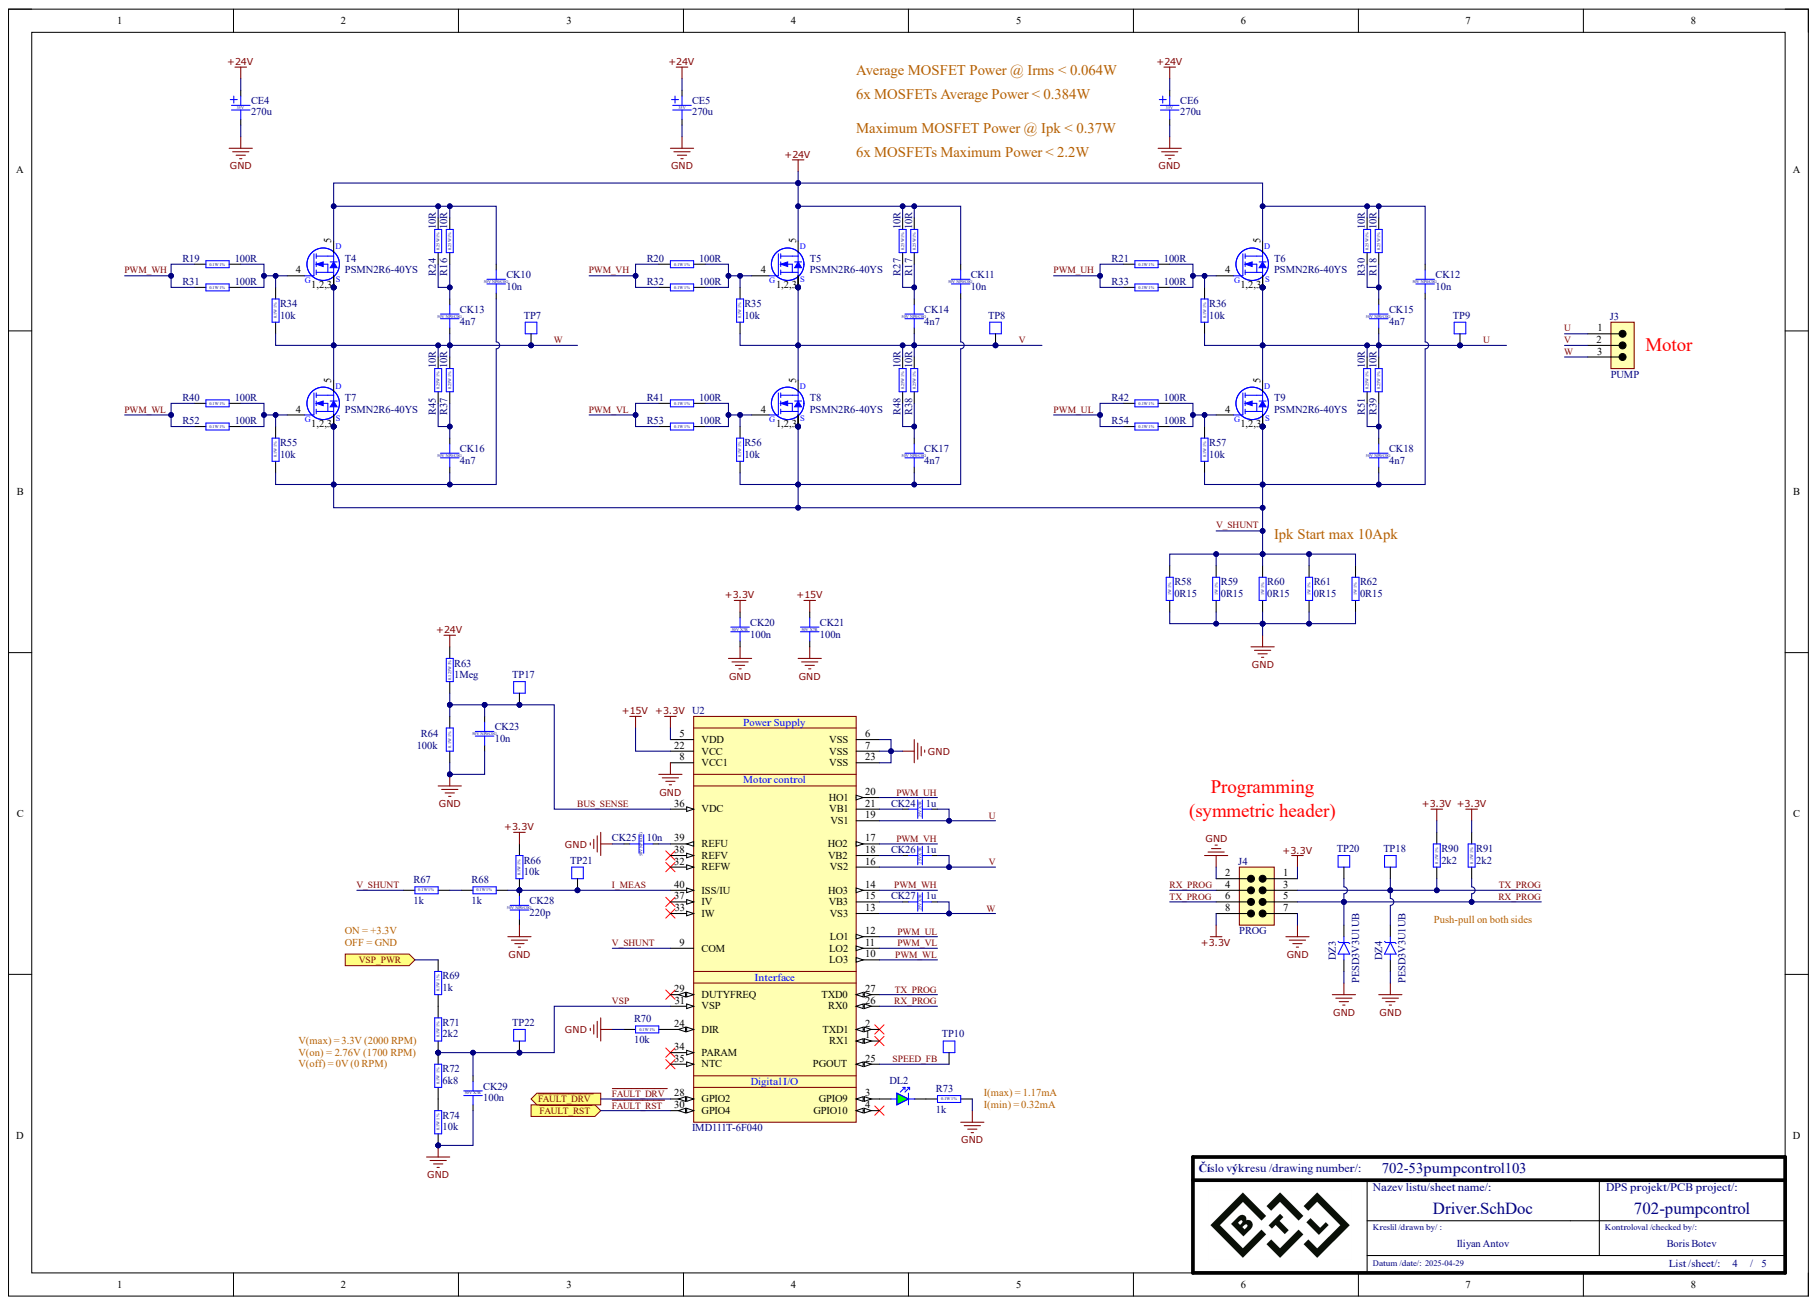
[picture p104: page 4]

Average MOSFET Power @ Irms < 0.064W
6x MOSFETs Average Power < 0.384W

Maximum MOSFET Power @ Ipk < 0.37W
6x MOSFETs Maximum Power < 2.2W

Push-pull on both sides

Nazev listu/sheet name/: Driver.SchDoc | DPS projekt/PCB project/: 702-pumpcontrol

Kreslil /drawn by/ : Iliyan Antov | Kontroloval /checked by/: BorisBotev

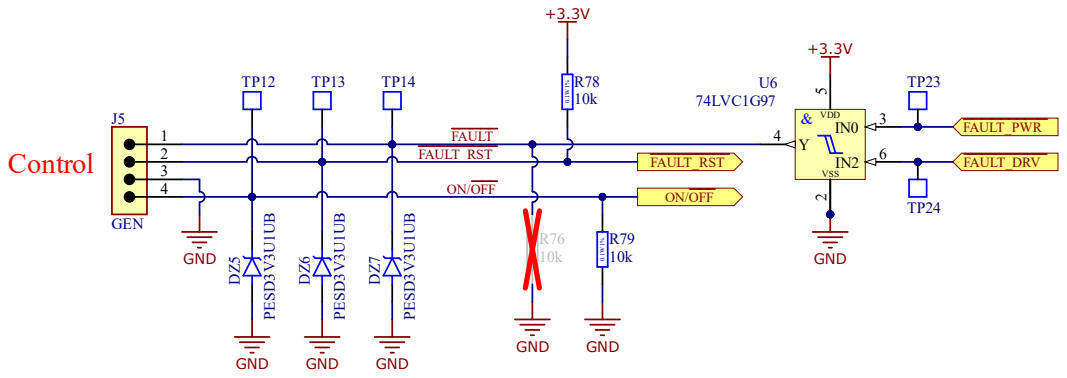
[picture p105: page 5]

Naz ev l i stu / s h e et nam e / : Co ntrol.SchDo c | D P S p roje kt/ P CB p roje ct/ : 7 0 2-p u mpco ntro l

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
