IliyanAntov/CodeFreeBLDC/Design/PCB/Assembly drawing.pdf

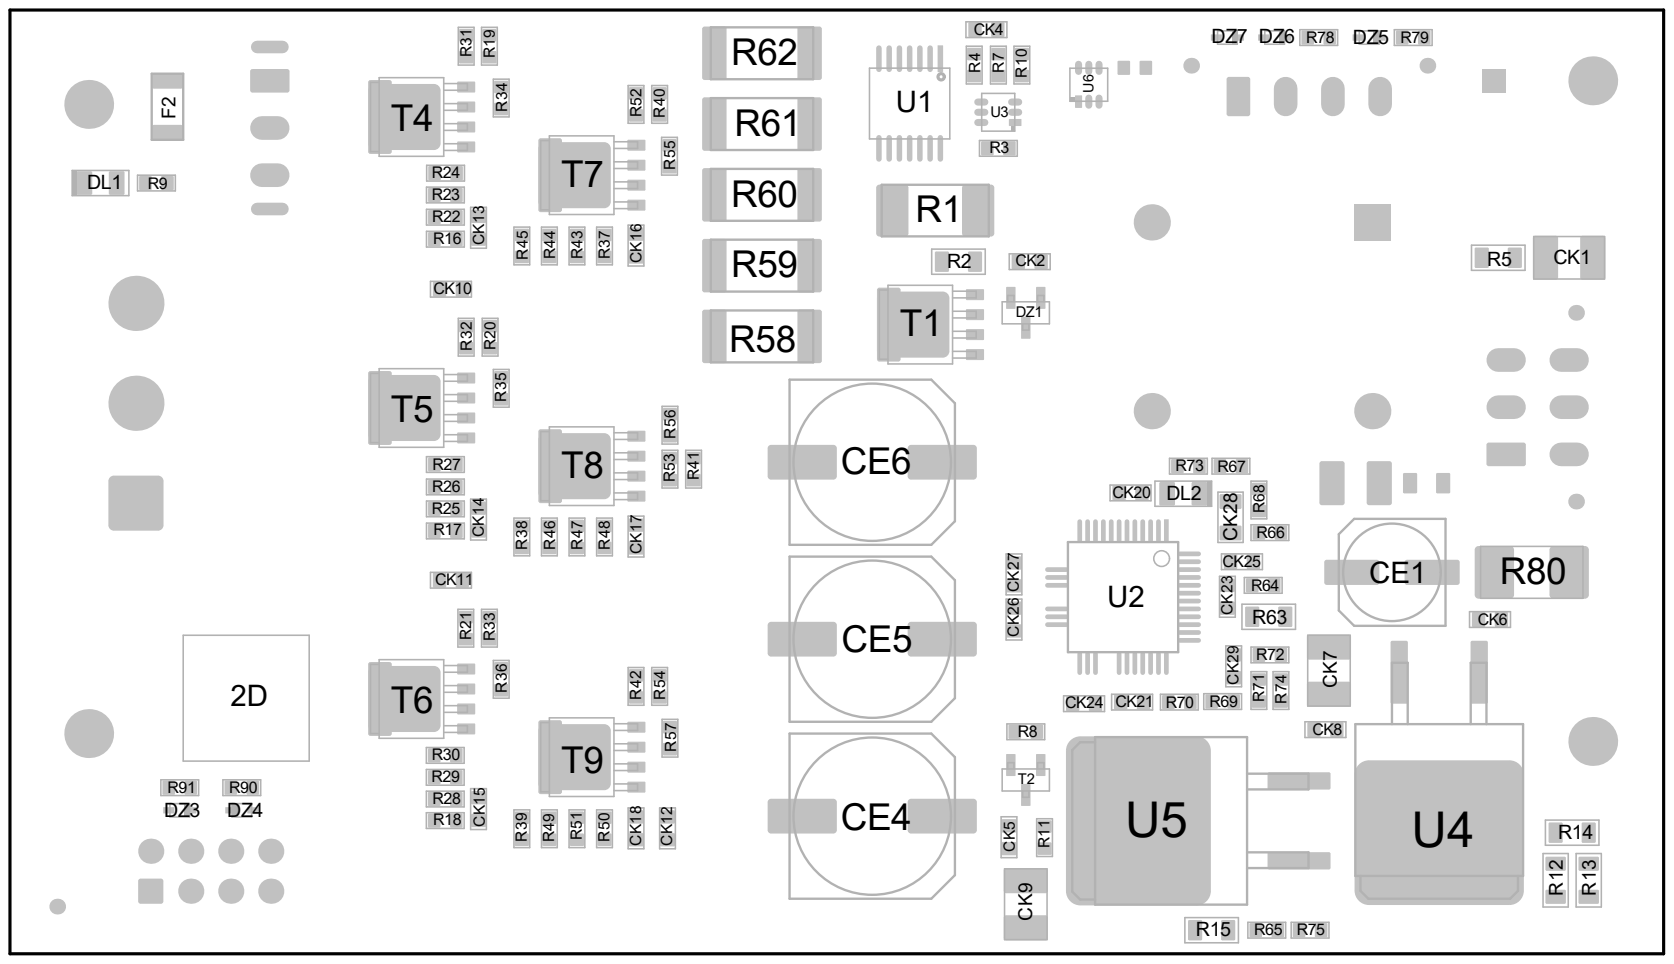
[picture p106: page 1]

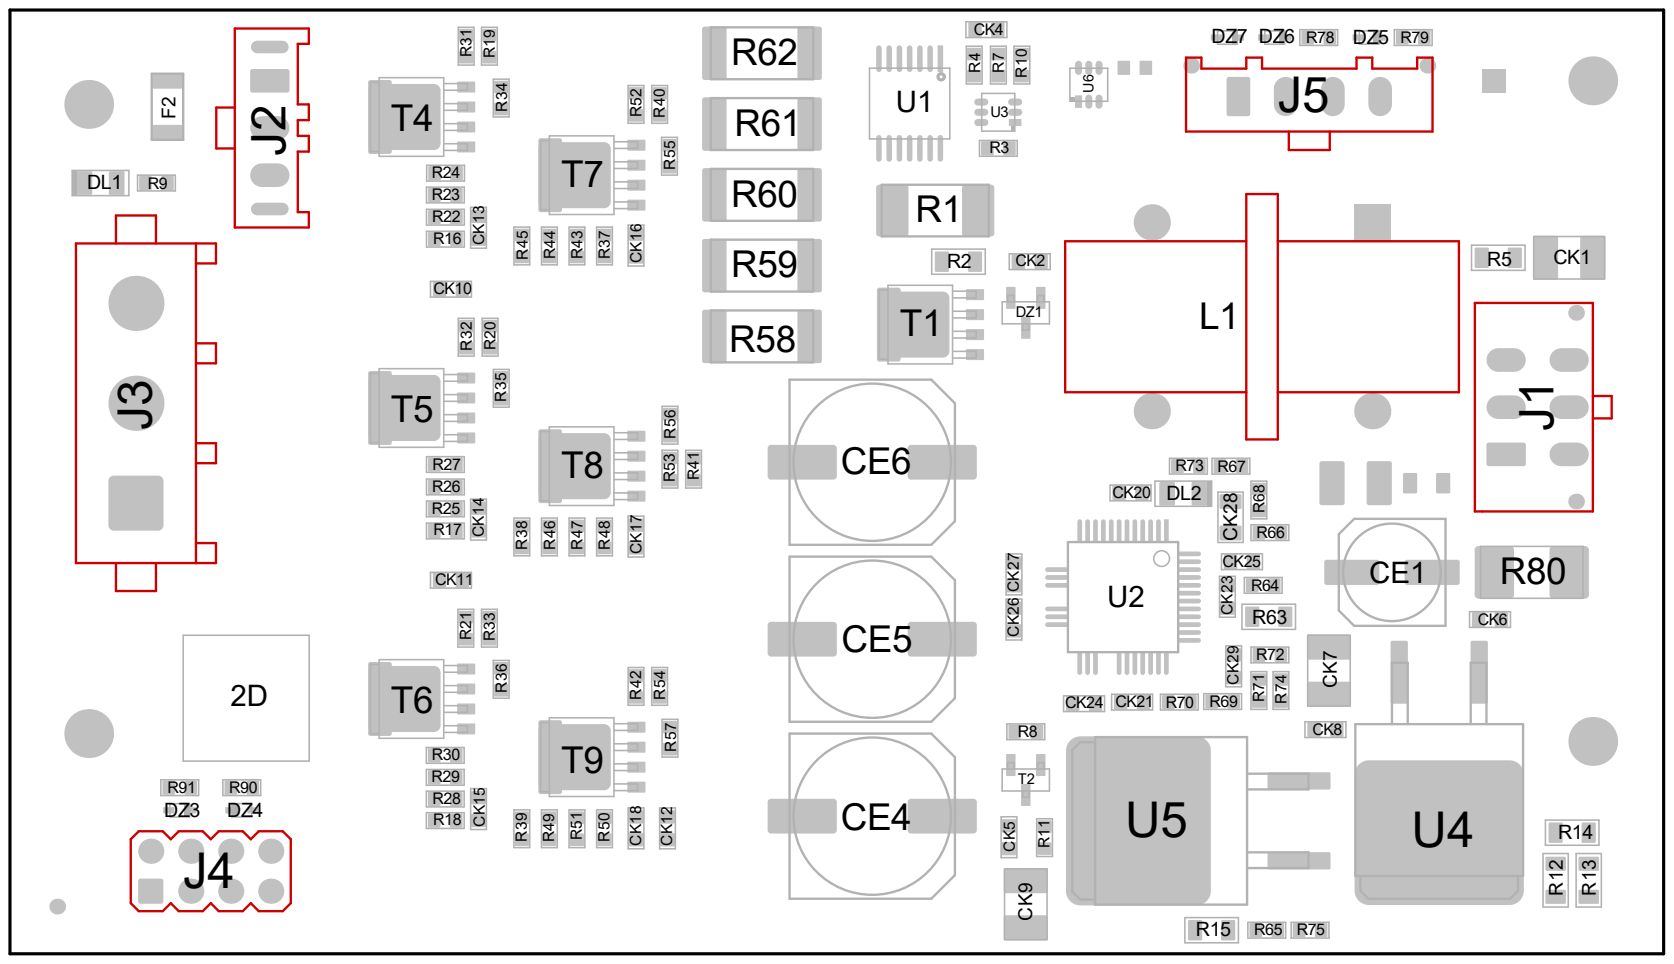
[picture p107: page 2]
