IliyanAntov/CodeFreeBLDC/Design/Simulations/+15V/15V.asc

I1: current; {Iadj}
R12: res; {R12}
R13: res; {R13}
R14: res; {R14}
V1: voltage; {Vref}
V2: voltage; {Vpwr}
Named nets: 0, Vin, Vref
.tran 0 1.000001m 1m
.step param run 0 64 1
.func binary(run,index) floor(run/(2**index))-2*floor(run/(2**(index+1)))
.func cv(nom,tol,index,pq) if(run==0,nom,if(binary((run-1),index),nom*(1+tol),nom*(1-tol)))
.func cv2(min,nom,max,index,pq) if(run==0,nom,if(binary((run-1),index),max,min))
WCCA simulation creates binnary combinations for each part and it's corner value. 
Function is named CV - Component value, this function calculates component value. This allows for change of error analysis withouth need to change unerlying schematics.
Description of binary fucntion can  be found at https://www.analog.com/en/technical-articles/ltspice-worst-case-circuit-analysis-with-minimal-simulations-runs.html
Function was modified so first run is nominal. This  allows op. data label to show nominal value and simplifies data processing.
# of runs needs to be  set to 2^(# of tolerated components) !
Index needs to be adjuster for each independent component
Resistor tolerance; 0.01 = 1%
.meas Vfbm PARAM Vfb
.meas R48m param R48
.meas R45m param R45
.meas R54m param R54
WCCA
uncomment below for WCCA
.OPTIONS measdgt=10
.OPTIONS numdgt=7
Number of significant figures for .meas statement
Forces LTspice to output simulation data into double precision
.options plotwinsize=0
Disables compression
.param TolR=0.01
.param tempcoppm=100
Temperature coefficient - ppm
.param delta_temp=40
.param TempErr = ({tempcoppm}*{delta_temp})/1000000
Delta temperature - rise above nominal 
(25 or 20C, see resistor vendor documentation)
Temperature error
.param R12=cv({220}, TolR+TempErr, 3, 6)
Reference voltage
.param Vpwr=cv2({22}, {24}, {26}, 0, 5)
.step param run 0 3000 1
.func cv(nom,tol,index,pq) if(run==0,nom,{nom+(gauss((nom*tol)/pq))})
.func cv2(min,nom,max,index,pq) if(run==0,nom,{nom+(gauss((max-nom)/pq))})
Monte Carlo
Component value is generated as a random number fron a normal distribution. 
Index is not used. PQ defines confidence level of part tolerance. 
Use PQ=6 for six sigma process(min/max is guaranteed)
 
Uncomment below for MC analysis
.meas Vout AVG Vref*(1+R14/(R12*R13/(R12+R13))) + Iadj*R14
TL431CD
Tolerance analysis
.meas Vout AVG V(out)
.param Vref=cv2({1.2}, {1.25}, {1.3}, 1, 5)
.param R13=cv({220}, TolR+TempErr, 4, 6)
.param R14=cv({1.2k}, TolR+TempErr, 5, 6)
.param Iadj=cv2({10u}, {50u}, {100u}, 2, 5)
