IliyanAntov/CodeFreeBLDC/Design/Simulations/+24V_IN/24V_IN.asc

R1: res; 2.2
R2: res; 6.8
R3: res; 6.8
U2: ECE+47U35VXXM
U5: EL-12M10ACMXX0
U6: ECK+10U50VXX0
U7: ECK+10U50VXX0
V1: voltage; PULSE(0 24 1m 10p 10p 50m 100m)
Named nets: 0, OUT, IN
47u
.tran 10m
10u
10u
