IliyanAntov/CodeFreeBLDC/(commit log)

2025-05-24 Wrote the Types of BLDC motors chapter
2025-05-24 Wrote the BLDC control algorithms chapter
2025-05-25 Added initial PCB images and schematics
2025-06-01 Created a block scheme of the device and wrote the Block scheme chapter
2025-06-03 Added design notes
    [Design report - calculations.xlsx, TPS2492_calculations.xlsx, ToleranceAnalysis.xlsx]
2025-06-04 Wrote some of the Power Block Design chapter (input filter and linear regulators)
    [Design report - calculations.xlsx]
2025-06-06 Wrote the full Power Block Design chapter. Updated the assignment page (final version)
2025-06-07 Some fixes to the schematics
2025-06-07 Wrote the full Inverter Design chapter. Updated schematic pictures.
2025-06-07 Wrote the full Driver Design and Externals Design chapters.
2025-06-08 Wrote the full PCB chapter.
2025-06-09 Wrote part of the Device Configuration chapter
    [Design report - calculations.xlsx]
2025-06-11 Wrote the full Device Configuration chapter. Added some measurement images. Almost finished the Measurements chapter.
2025-06-25 Added a file with PCB layers in PDF format
